dvntekim/fc-h743/docs/critical_nets.md

# Critical nets (from the routed board)

Generated by `scripts/check_critical.py`. Lengths are routed copper only (pads excluded).

| Net | Routed length (mm) | By layer | Vias | Widths (mm) |
|---|---|---|---|---|
| USB: `USB_DP` | 6.0 | F 3.0, In3 3.0 | 2 | 0.25 |
| USB: `USB_DM` | 8.3 | F 8.3 | 0 | 0.25 |
| USB: `USB_DP_C` | 7.8 | F 4.0, B 3.8 | 2 | 0.25 |
| USB: `USB_DM_C` | 5.7 | F 5.7 | 0 | 0.25 |
| Crystal: `HSE_IN` | 6.1 | F 6.1 | 0 | 0.15 |
| Crystal: `HSE_OUT` | 4.1 | F 4.1 | 0 | 0.15 |
| Buck: `BUCK_SW` | 0.0 |  | 0 |  |
| Buck: `BUCK_BOOT` | 2.3 | F 2.3 | 0 | 0.3 |
| Buck: `BUCK_FB` | 6.2 | F 6.2 | 0 | 0.127 |
| Buck: `BUCK_COMP` | 13.2 | F 13.2 | 0 | 0.127 |
| Buck: `VBAT` | 53.4 | F 29.0, B 9.6, In2 10.6, In3 4.2 | 6 | 0.421, 0.5, 0.6, 0.8, 1.0, 1.2 |
| Buck: `+5V` | 143.6 | F 24.9, B 65.0, In2 30.3, In3 23.4 | 10 | 0.4, 0.5, 0.6, 0.8, 1.0, 1.2 |
| IMU0 SPI1: `SPI1_SCK` | 15.5 | F 1.7, B 3.5, In2 10.3 | 3 | 0.127 |
| IMU0 SPI1: `SPI1_SCK_MCU` | 1.9 | F 1.9 | 0 | 0.127 |
| IMU0 SPI1: `SPI1_MISO` | 7.5 | F 6.8, B 0.8 | 1 | 0.127 |
| IMU0 SPI1: `SPI1_MOSI` | 7.9 | F 7.2, B 0.7 | 1 | 0.127, 0.15 |
| IMU0 SPI1: `IMU1_CS` | 14.2 | F 3.2, B 10.9 | 1 | 0.127 |
| IMU0 SPI1: `IMU1_DRDY` | 6.3 | F 3.4, B 0.6, In2 2.3 | 2 | 0.127 |
| IMU0 SPI1: `IMU_CLKIN` | 13.6 | F 2.0, B 1.0, In2 10.5 | 2 | 0.127 |
| IMU1 SPI2: `SPI2_SCK` | 16.2 | F 2.2, B 2.2, In2 11.8 | 2 | 0.127 |
| IMU1 SPI2: `SPI2_MISO` | 17.8 | F 8.9, B 3.5, In3 5.4 | 2 | 0.127 |
| IMU1 SPI2: `SPI2_MOSI` | 15.7 | F 14.4, B 1.3 | 1 | 0.127 |
| IMU1 SPI2: `BMI_ACC_CS` | 14.0 | F 9.0, B 1.7, In2 3.2 | 2 | 0.127 |
| IMU1 SPI2: `BMI_GYRO_CS` | 18.7 | F 2.4, B 1.9, In2 14.4 | 3 | 0.127 |
| SDMMC2: `SD_CLK` | 51.4 | F 2.4, B 5.9, In2 42.9, In3 0.2 | 2 | 0.127 |
| SDMMC2: `SD_CLK_MCU` | 2.5 | F 2.5 | 0 | 0.127 |
| SDMMC2: `SD_CMD` | 28.0 | F 3.6, B 9.9, In3 14.5 | 2 | 0.127 |
| SDMMC2: `SD_D0` | 29.3 | F 8.9, B 11.8, In2 8.7 | 3 | 0.127 |
| SDMMC2: `SD_D1` | 36.3 | F 11.6, B 14.5, In3 10.2 | 2 | 0.127 |
| SDMMC2: `SD_D2` | 26.1 | F 3.3, B 7.3, In2 15.6 | 2 | 0.127 |
| SDMMC2: `SD_D3` | 18.1 | F 1.6, B 8.1, In3 8.5 | 2 | 0.127 |
| CAN1: `CAN1_H` | 44.0 | F 12.1, B 3.9, In2 21.4, In3 6.6 | 3 | 0.127 |
| CAN1: `CAN1_L` | 27.3 | F 9.2, B 5.2, In3 12.9 | 3 | 0.127 |
| CAN2: `CAN2_H` | 14.0 | F 9.1, In3 4.9 | 2 | 0.127 |
| CAN2: `CAN2_L` | 8.0 | F 8.0 | 0 | 0.127 |

- `USB_DP`/`USB_DM` length difference: 2.26 mm
- `USB_DP_C`/`USB_DM_C` length difference: 2.06 mm
- `CAN1_H`/`CAN1_L` length difference: 16.72 mm
- `CAN2_H`/`CAN2_L` length difference: 5.97 mm
- Nearest IMU to L1 (buck inductor): 16.4 mm (spec: ≥ 10 mm)
- Nearest IMU to U1 (buck IC): 14.2 mm (spec: ≥ 10 mm)
- Crystal Y1 to MCU OSC_IN pin: 3.0 mm
- Tracks/vias inside the BMP581 body outline: {('B', 'other net'): 71, ('F', 'own net'): 241, ('via', 'own net'): 3, ('In3', 'own net'): 8, ('In3', 'other net'): 2, ('In2', 'own net'): 2, ('In2', 'other net'): 4}
- Sensor/clock nets crossing the inductor L1 outline on any layer: none
- Buck hot loop: C3 GND pad to D3 anode 10.0 mm, closed on In1 0.18 mm below F.Cu; 2 GND vias at the D3 anode
- Buck switch node: F.Cu pour, 26 mm2 (BUCK_SW has no tracks)
- Vias: 533 total; 20 at 0.35/0.15 mm, of which 17 are via-in-pad (need JLC epoxy fill + cap)
