dvntekim/fc-h743/docs/copper_layers.png

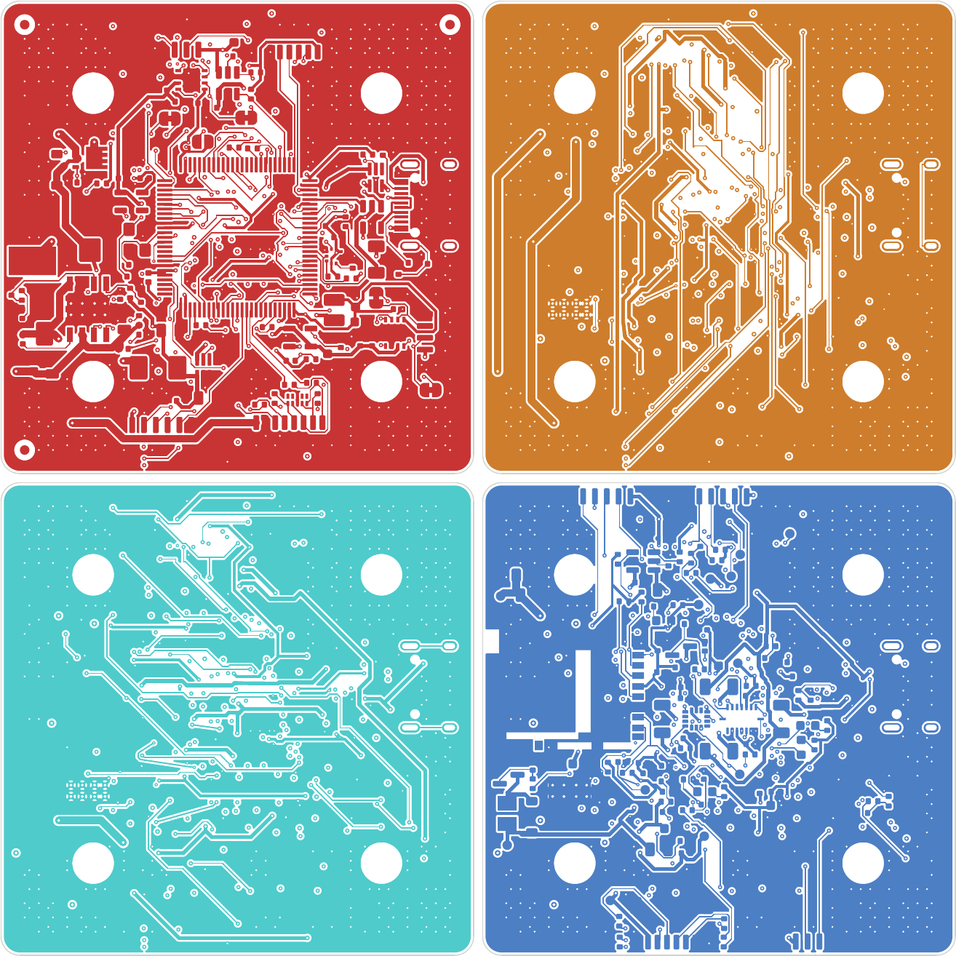
docs/copper_layers.png
