dvntekim/fc-h743/docs/render_iso.png

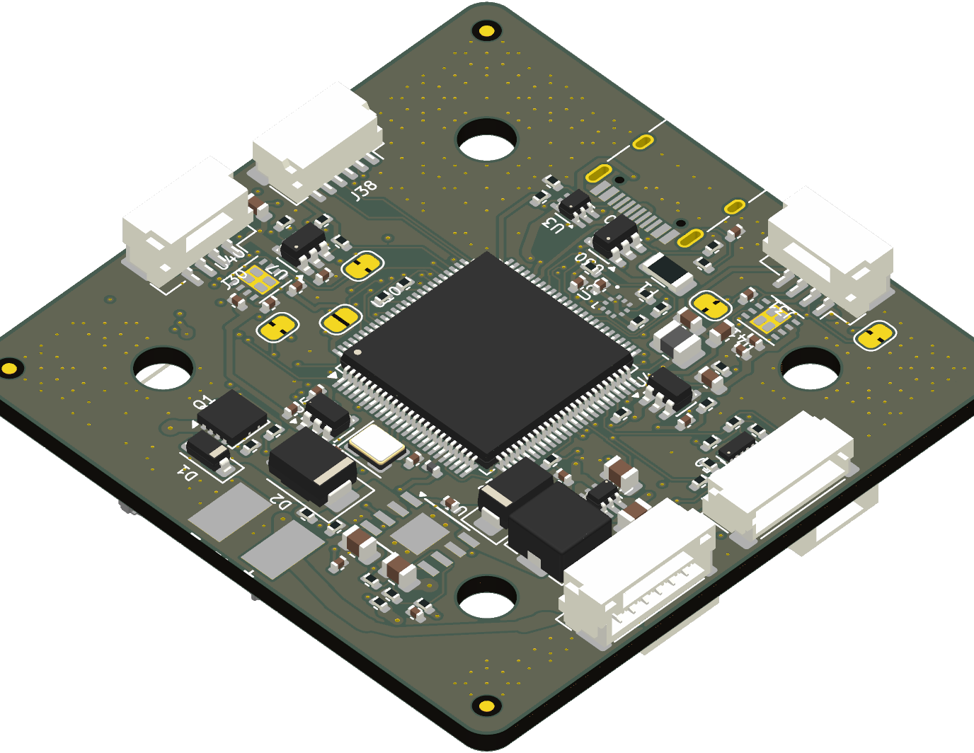
docs/render_iso.png
