dvntekim/fc-h743/sim/pi/P3V3_B.png

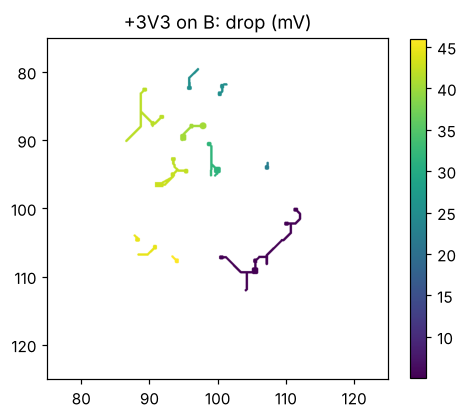
sim/pi/P3V3_B.png
