dvntekim/fc-h743/sim/pi/P3V3_F.png

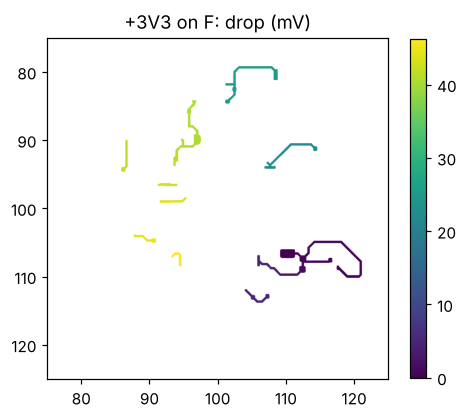
sim/pi/P3V3_F.png
