dvntekim/fc-h743/sim/pi/P3V3_In2.png

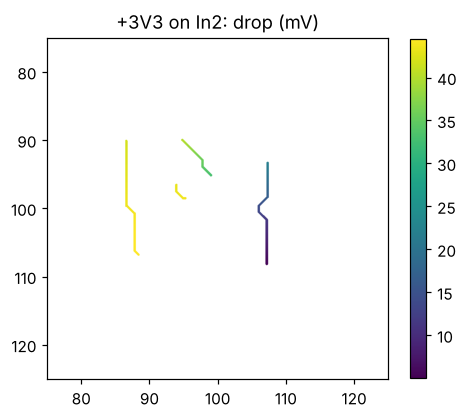
sim/pi/P3V3_In2.png
