dvntekim/fc-h743/sim/pi/P5V_B.png

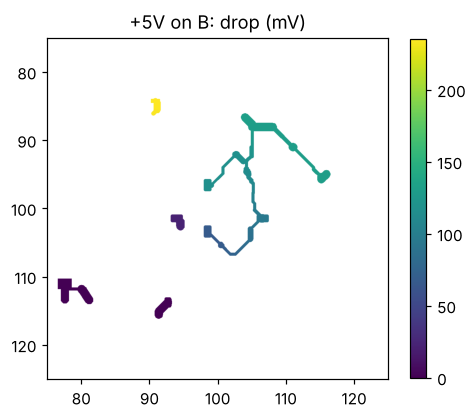
sim/pi/P5V_B.png
