dvntekim/fc-h743/sim/pi/P5V_F.png

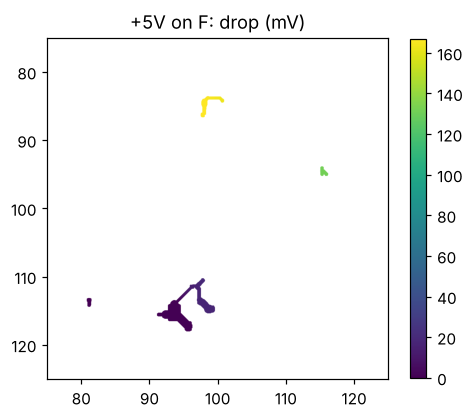
sim/pi/P5V_F.png
