dvntekim/fc-h743/sim/pi/P5V_In2.png

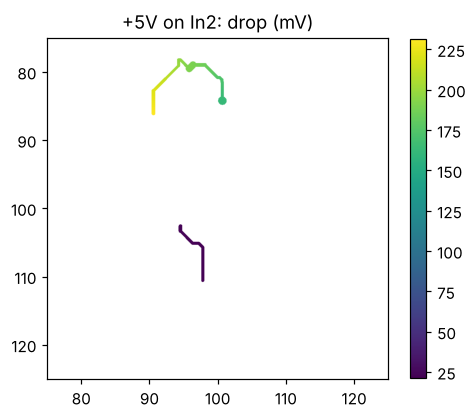
sim/pi/P5V_In2.png
