dvntekim/fc-h743/sim/pi/VBAT_B.png

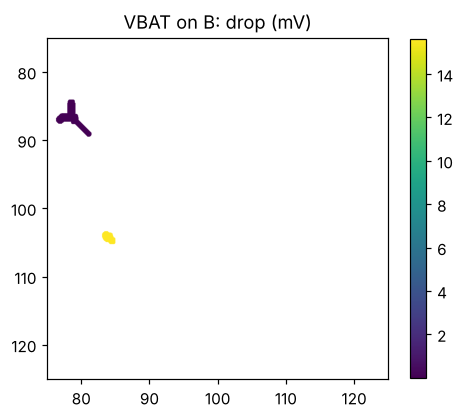
sim/pi/VBAT_B.png
