dvntekim/fc-h743/sim/pi/VBAT_F.png

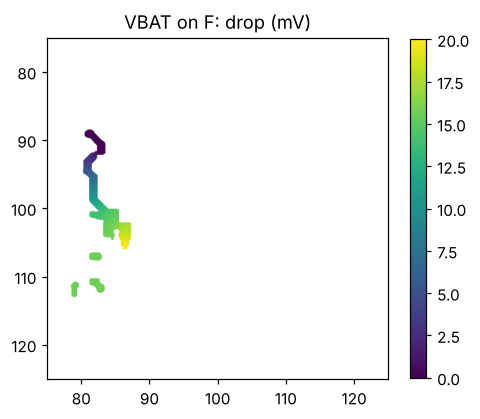
sim/pi/VBAT_F.png
