dvntekim/fc-h743/sim/pi/VBAT_In2.png

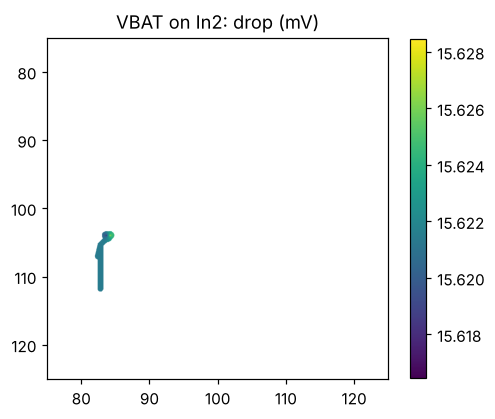
sim/pi/VBAT_In2.png
