dvntekim/fc-h743/sim/pi/VBAT_RAW_F.png

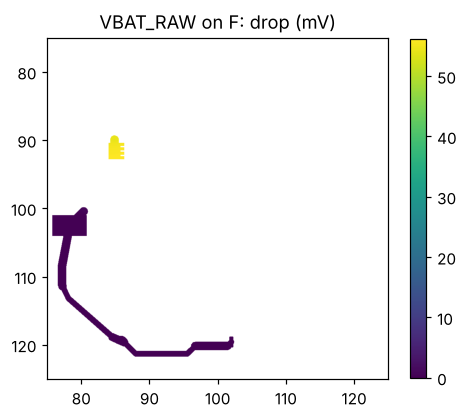
sim/pi/VBAT_RAW_F.png
