dvntekim/fc-h743/sim/pi/VBAT_RAW_In2.png

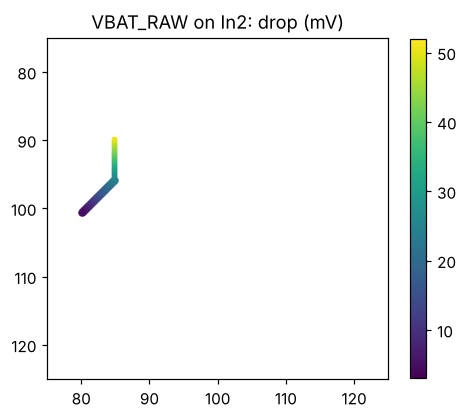
sim/pi/VBAT_RAW_In2.png
