dvntekim/fc-h743/sim/thermal/map_4S_1.2A+heater_h12.png

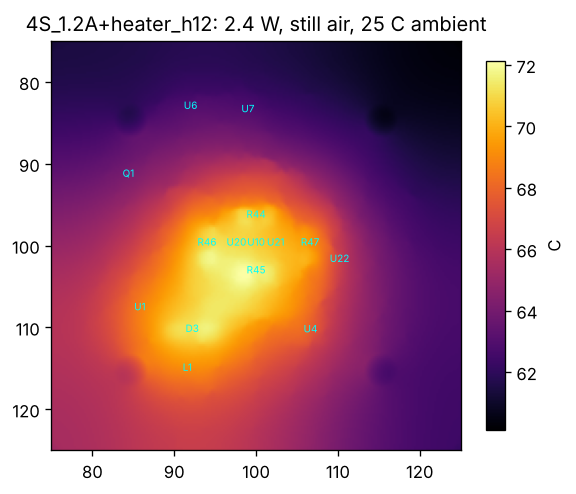
sim/thermal/map_4S_1.2A+heater_h12.png
