dvntekim/fc-h743/sim/thermal/map_6S_2.5A_h12.png

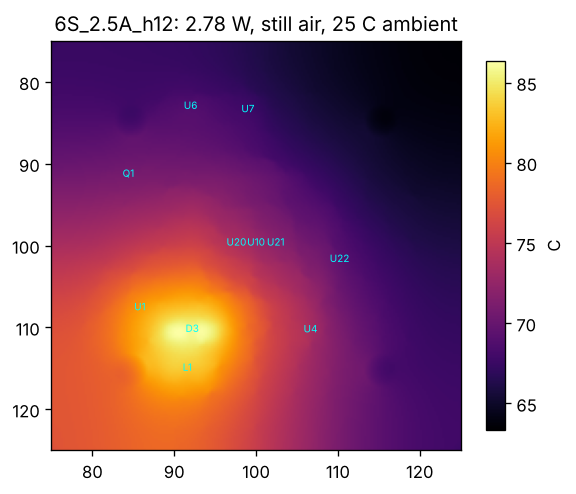
sim/thermal/map_6S_2.5A_h12.png
