dvntekim/fc-h743/sim/thermal/revB/island_inplace_slot_11x9_0.86W_cold.png

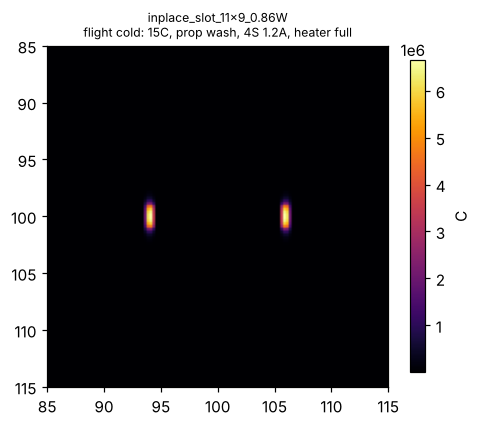
sim/thermal/revB/island_inplace_slot_11x9_0.86W_cold.png
