dvntekim/fc-h743/fab/bom_jlc.csv

Comment | Designator | Footprint | LCSC Part #
10uF | C1,C2,C6,C7 | C_0805_2012Metric | C440198
100nF | C3 | C_0603_1608Metric | C14663
100nF | C4,C5,C9,C13,C17,C18,C25,C27,C29,C30,C31,C32,C33,C34,C39,C40,C41,C44,C45,C47,C48,C49,C50,C53,C54,C56,C58,C60 | C_0402_1005Metric | C1525
22uF | C10,C11,C12,C26 | C_0805_2012Metric | C45783
4.7nF | C14,C51,C57,C61 | C_0402_1005Metric | C1538
47pF | C15 | C_0402_1005Metric | C1567
10uF | C16,C19,C21,C22,C28,C52 | C_0603_1608Metric | C19702
10pF | C20 | C_0402_1005Metric | C32949
1uF | C23,C24,C38,C46,C55,C59 | C_0402_1005Metric | C52923
4.7uF | C35 | C_0603_1608Metric | C19666
2.2uF | C36,C37 | C_0402_1005Metric | C12530
12pF | C42,C43 | C_0402_1005Metric | C1547
BZT52C12 | D1 | D_SOD-123 | C43491
SMBJ28A | D2 | D_SMB | C113997
B360A-13-F | D3 | D_SMA | C94193
GREEN PWR | D4 | LED_0603_1608Metric | C2986059
RED | D10 | LED_0603_1608Metric | C2286
BLUE | D11 | LED_0603_1608Metric | C965807
GREEN | D12 | LED_0603_1608Metric | C2986059
B5819W | D20 | D_SOD-123 | C8598
0.5A | F1 | Fuse_1206_3216Metric | C69688
220R@100MHz | FB1 | L_0402_1005Metric | C76885
USB-C | J20 | USB_C_Receptacle_HRO_TYPE-C-31-M-12 | C165948
microSD | J21 | microSD_HC_Hirose_DM3AT-SF-PEJM5 | C114218
CAN1 | J30 | JST_GH_SM04B-GHS-TB_1x04-1MP_P1.25mm_Horizontal | C189895
CAN2 | J31 | JST_GH_SM04B-GHS-TB_1x04-1MP_P1.25mm_Horizontal | C189895
TELEM1 | J32 | JST_GH_SM06B-GHS-TB_1x06-1MP_P1.25mm_Horizontal | C133065
TELEM2 | J33 | JST_GH_SM06B-GHS-TB_1x06-1MP_P1.25mm_Horizontal | C133065
GPS/I2C | J34 | JST_GH_SM06B-GHS-TB_1x06-1MP_P1.25mm_Horizontal | C133065
RC | J35 | JST_GH_SM04B-GHS-TB_1x04-1MP_P1.25mm_Horizontal | C189895
ESC | J36 | JST_SH_SM08B-SRSS-TB_1x08-1MP_P1.00mm_Horizontal | C160407
AUX | J37 | JST_SH_SM06B-SRSS-TB_1x06-1MP_P1.00mm_Horizontal | C56123098
DEBUG | J38 | JST_SH_SM06B-SRSS-TB_1x06-1MP_P1.00mm_Horizontal | C56123098
4.7uH | L1 | L_Changjiang_FXL0530 | C177246
2.2uH | L2 | L_1008_2520Metric | C98350
DMP4013LFGQ-13 | Q1 | Diodes_PowerDI3333-8 | C7264680
AO3400A | Q2 | SOT-23 | C20917
2N7002 | Q3 | SOT-23 | C8545
100k | R1,R2,R11,R18,R19,R21,R24,R43,R74 | R_0402_1005Metric | C25741
10k | R3,R9,R12,R13,R14,R15,R16,R22,R25,R27,R35,R36,R37,R38,R39 | R_0402_1005Metric | C25744
1k | R4,R32,R68 | R_0402_1005Metric | C11702
147k | R5 | R_0402_1005Metric | C64171
36k | R6 | R_0402_1005Metric | C43676
162k | R7 | R_0402_1005Metric | C54068
53.6k | R8 | R_0402_1005Metric | C53398
9.09k | R10 | R_0402_1005Metric | C11549
453k | R17 | R_0402_1005Metric | C27009
20k | R20 | R_0402_1005Metric | C25765
22k | R23,R51 | R_0402_1005Metric | C25768
2k | R26 | R_0402_1005Metric | C4109
33 | R28,R29,R31 | R_0402_1005Metric | C25105
22 | R30 | R_0402_1005Metric | C25092
470 | R33,R34 | R_0402_1005Metric | C25117
2.2k | R40,R41,R62,R63 | R_0402_1005Metric | C25879
47 | R42,R64,R65,R66,R67,R69,R70,R71,R72 | R_0402_1005Metric | C25118
120 | R44,R45,R46,R47 | R_1206_3216Metric | C17909
5.1k | R48,R49 | R_0402_1005Metric | C25905
1M | R50 | R_0402_1005Metric | C26083
33k | R52 | R_0402_1005Metric | C25779
47k | R53,R54,R55,R56,R57 | R_0402_1005Metric | C25792
60.4 | R58,R59,R60,R61 | R_0402_1005Metric | C60310
100 | R73 | R_0402_1005Metric | C25076
TPS54360BDDAR | U1 | TI_SO-PowerPAD-8_ThermalVias | C524806
LM66100DCKR | U2,U3 | SOT-363_SC-70-6 | C2869734
TLV62569DBVR | U4 | SOT-23-5 | C141836
LP5907MFX-3.3/NOPB | U5 | SOT-23-5 | C80670
TPS2553DBVR | U6,U7 | SOT-23-6 | C55266
STM32H743VIT6 | U10 | LQFP-100_14x14mm_P0.5mm | C114409
ICM-45686 | U20 | LGA-14_3x2.5mm_P0.5mm_LayoutBorder3x4y | C22459454
BMI088 | U21 | Bosch_LGA-16_4.5x3mm_P0.5mm_LayoutBorder7x1y_ClockwisePinNumbering | C194919
BMP581 | U22 | Bosch_LGA-10_2x2mm_P0.5mm_BMP581 | C5362283
USBLC6-2SC6 | U30 | SOT-23-6 | C7519
TCAN1462VDRBRQ1 | U40,U41 | TI_DRB0008J_VSON-8_3x3mm_P0.65mm | C5215833
TPD4E05U06DQAR | U50 | USON-10_2.5x1.0mm_P0.5mm | C138714
16MHz | Y1 | Crystal_SMD_3225-4Pin_3.2x2.5mm | C13738
