dvntekim/fc-h743/fab/fc-h743.step

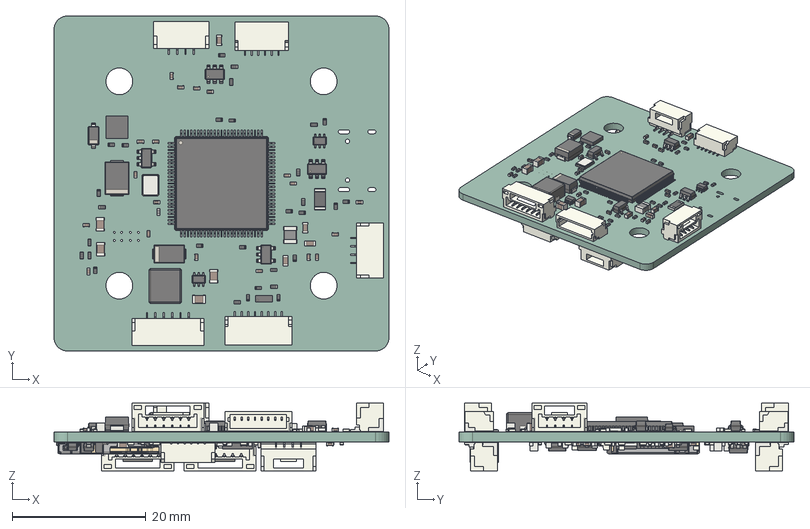
[picture p22: CAD file, 2026-11-07]
fab/fc-h743.step
50.0 x 50.0 x 10.1 mm
R_0402_1005Metric x 70
C_0603_1608Metric x 8
D_SOD-123 x 2
C_0402_1005Metric x 44
Crystal_SMD_3225-4Pin_3.2x2.5mm
C_0805_2012Metric x 8
SOT-363_SC-70-6 x 2
JST_GH_SM04B-GHS-TB_1x04-1MP_P1.25mm_Horizontal x 3
JST_SH_SM06B-SRSS-TB_1x06-1MP_P1.00mm_Horizontal x 2
Diodes_PowerDI3333-8
SOT-23-6 x 3
JST_GH_SM06B-GHS-TB_1x06-1MP_P1.25mm_Horizontal x 3
D_SMB
L_Changjiang_FXL0530
JST_SH_SM08B-SRSS-TB_1x08-1MP_P1.00mm_Horizontal
D_SMA
Fuse_1206_3216Metric
SOT-23-5 x 2
USON-10_2.5x1.0mm_P0.5mm
L_1008_2520Metric
L_0402_1005Metric
LQFP-100_14x14mm_P0.5mm
LED_0603_1608Metric x 4
LGA-14_3x2.5mm_P0.5mm_LayoutBorder3x4y
R_1206_3216Metric x 4
microSD_HC_Hirose_DM3AT-SF-PEJM5
SOT-23 x 2
Bosch_LGA-16_4.5x3mm_P0.5mm_LayoutBorder7x1y_ClockwisePinNumbering
fc_PCB
