dvntekim/fc-h743/docs/schematic.pdf

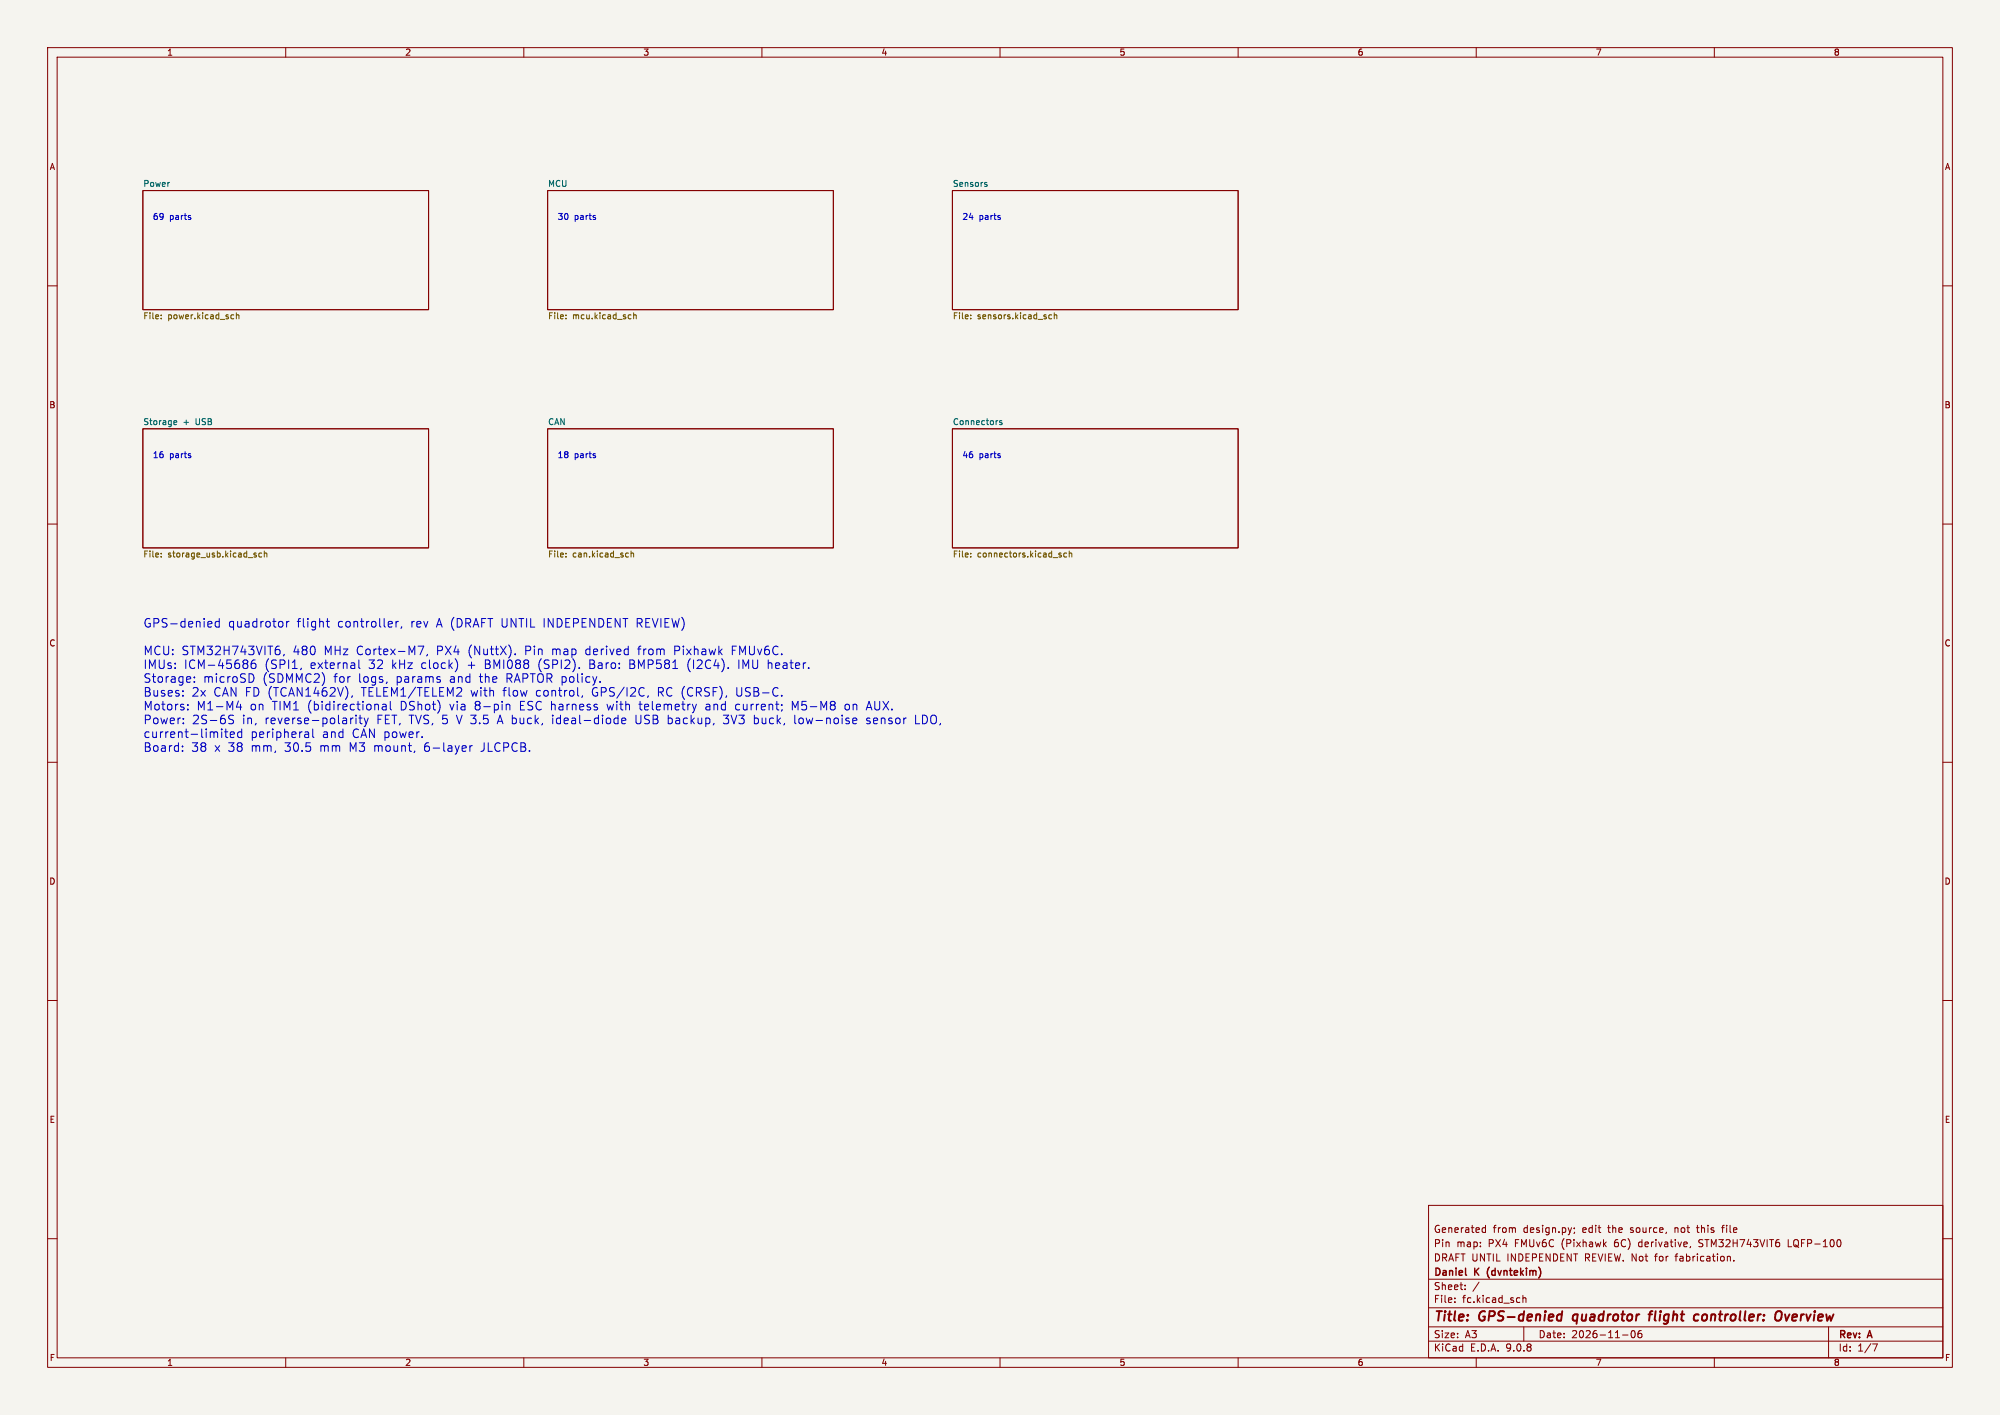
[picture p23: page 1]

Storage: microSD (SDMMC2) for logs, params and the RAPTOR policy.

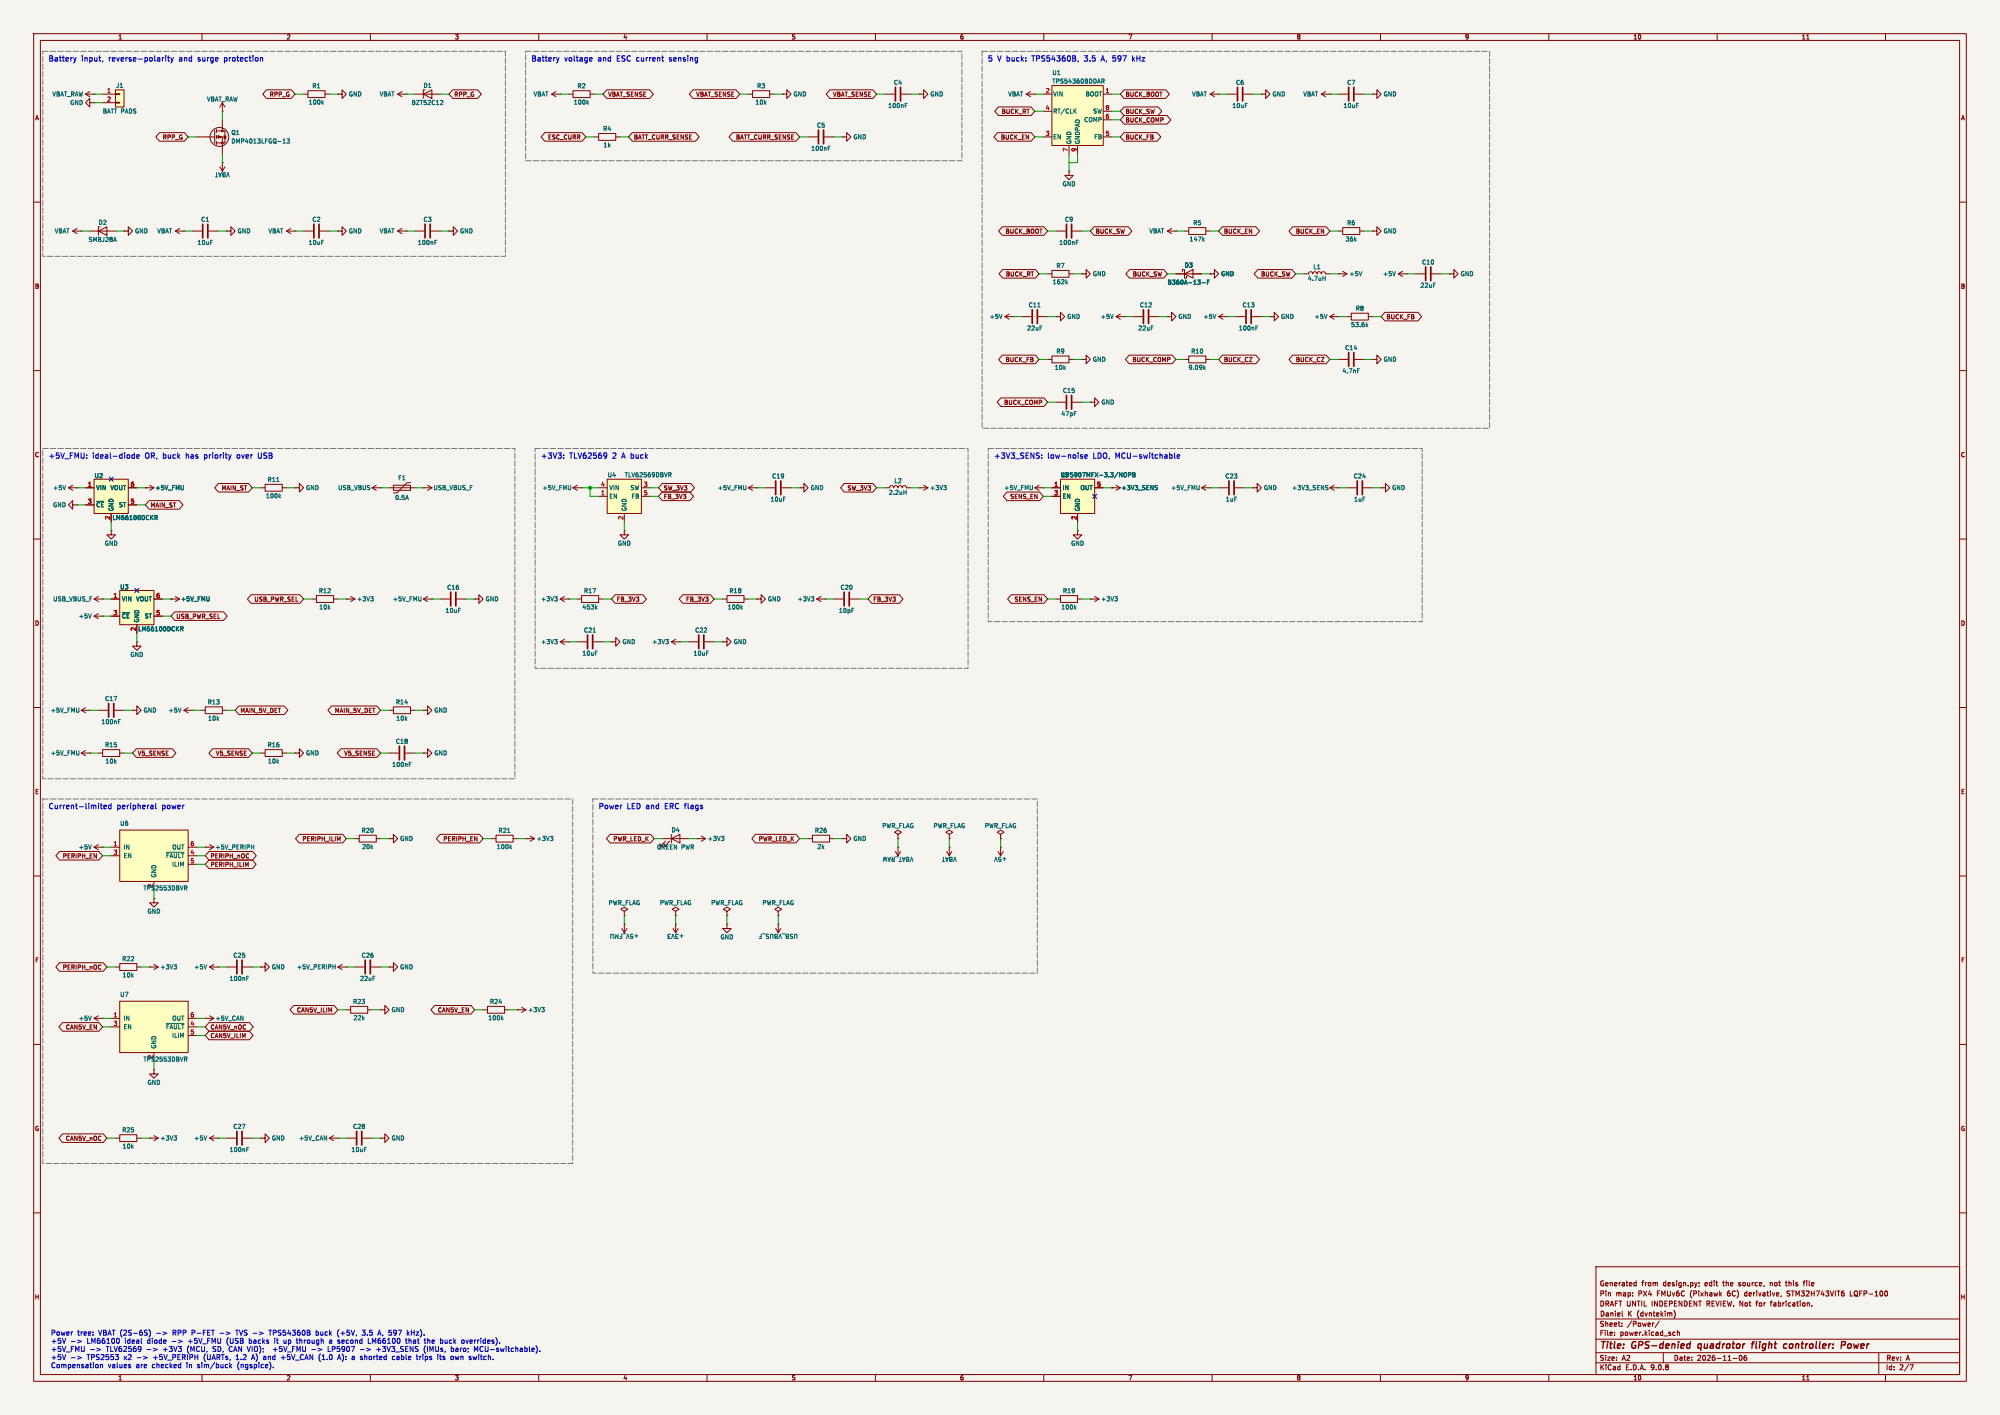
[picture p24: page 2]

Battery voltage and ESC current sensing

9 BOOT 1 SW 8 COMP 6 FB 5 U1 TPS54360BDDAR

2 SW 3 FB 5 U4 TLV62569DBVR GND GND

2 OUT 5 U5LP5907MFX-3.3/NOPB GND +5V_FMU +3V3_SENS GND +3V3_SENS C24

Power LED and ERC flags

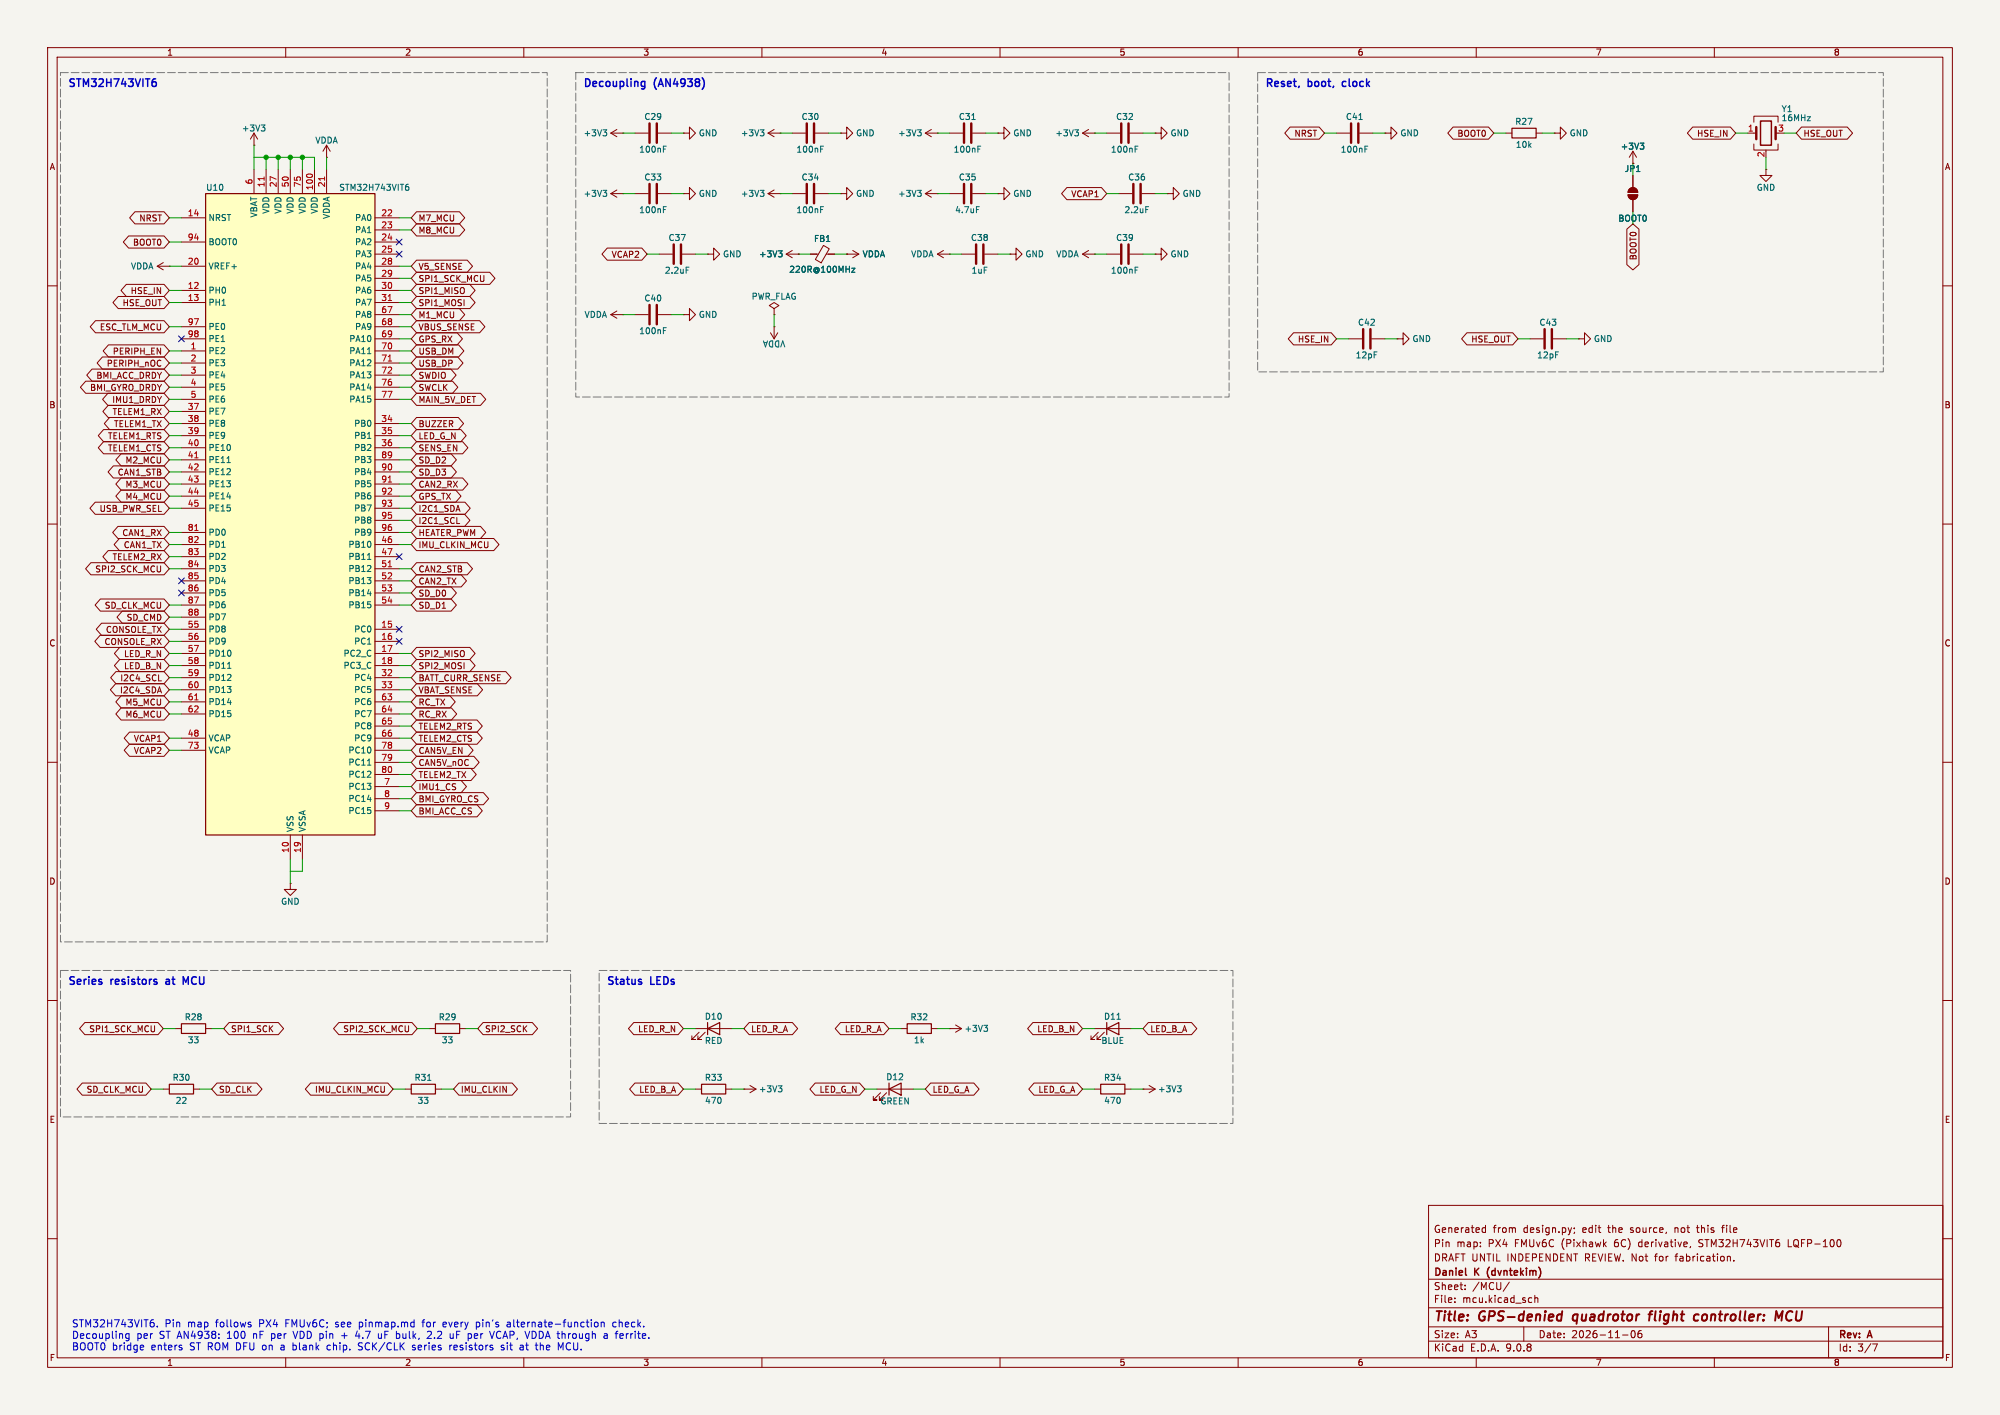
[picture p25: page 3]

6 VDD 11 VDD 27 VDD 50 VSS 10 VDD 75 VSSA 19 VDD 100 VDDA 21 PA0 22 PA1 23 PA2 24 PA3 25 PA4 28 PA5 29 PA6 30 PA7 31 PA8 67 PA9 68 PA10 69 PA11 70 PA12 71 PA13 72 PA14 76 PA15 77 PB0 34 PB1 35 PB2 36 PB3 89 PB4 90 PB5 91 PB6 92 PB7 93 PB8 95 PB9 96 PB10 46 PB11 47 PB12 51 PB13 52 PB14 53 PB15 54 PC0 15 PC1 16 PC2_C 17 PC3_C 18 PC4 32 PC5 33 PC6 63 PC7 64 PC8 65 PC9 66 PC10 78 PC11 79 PC12 80 PC13 7 PC14 8 PC15 9

Series resistors at MCU

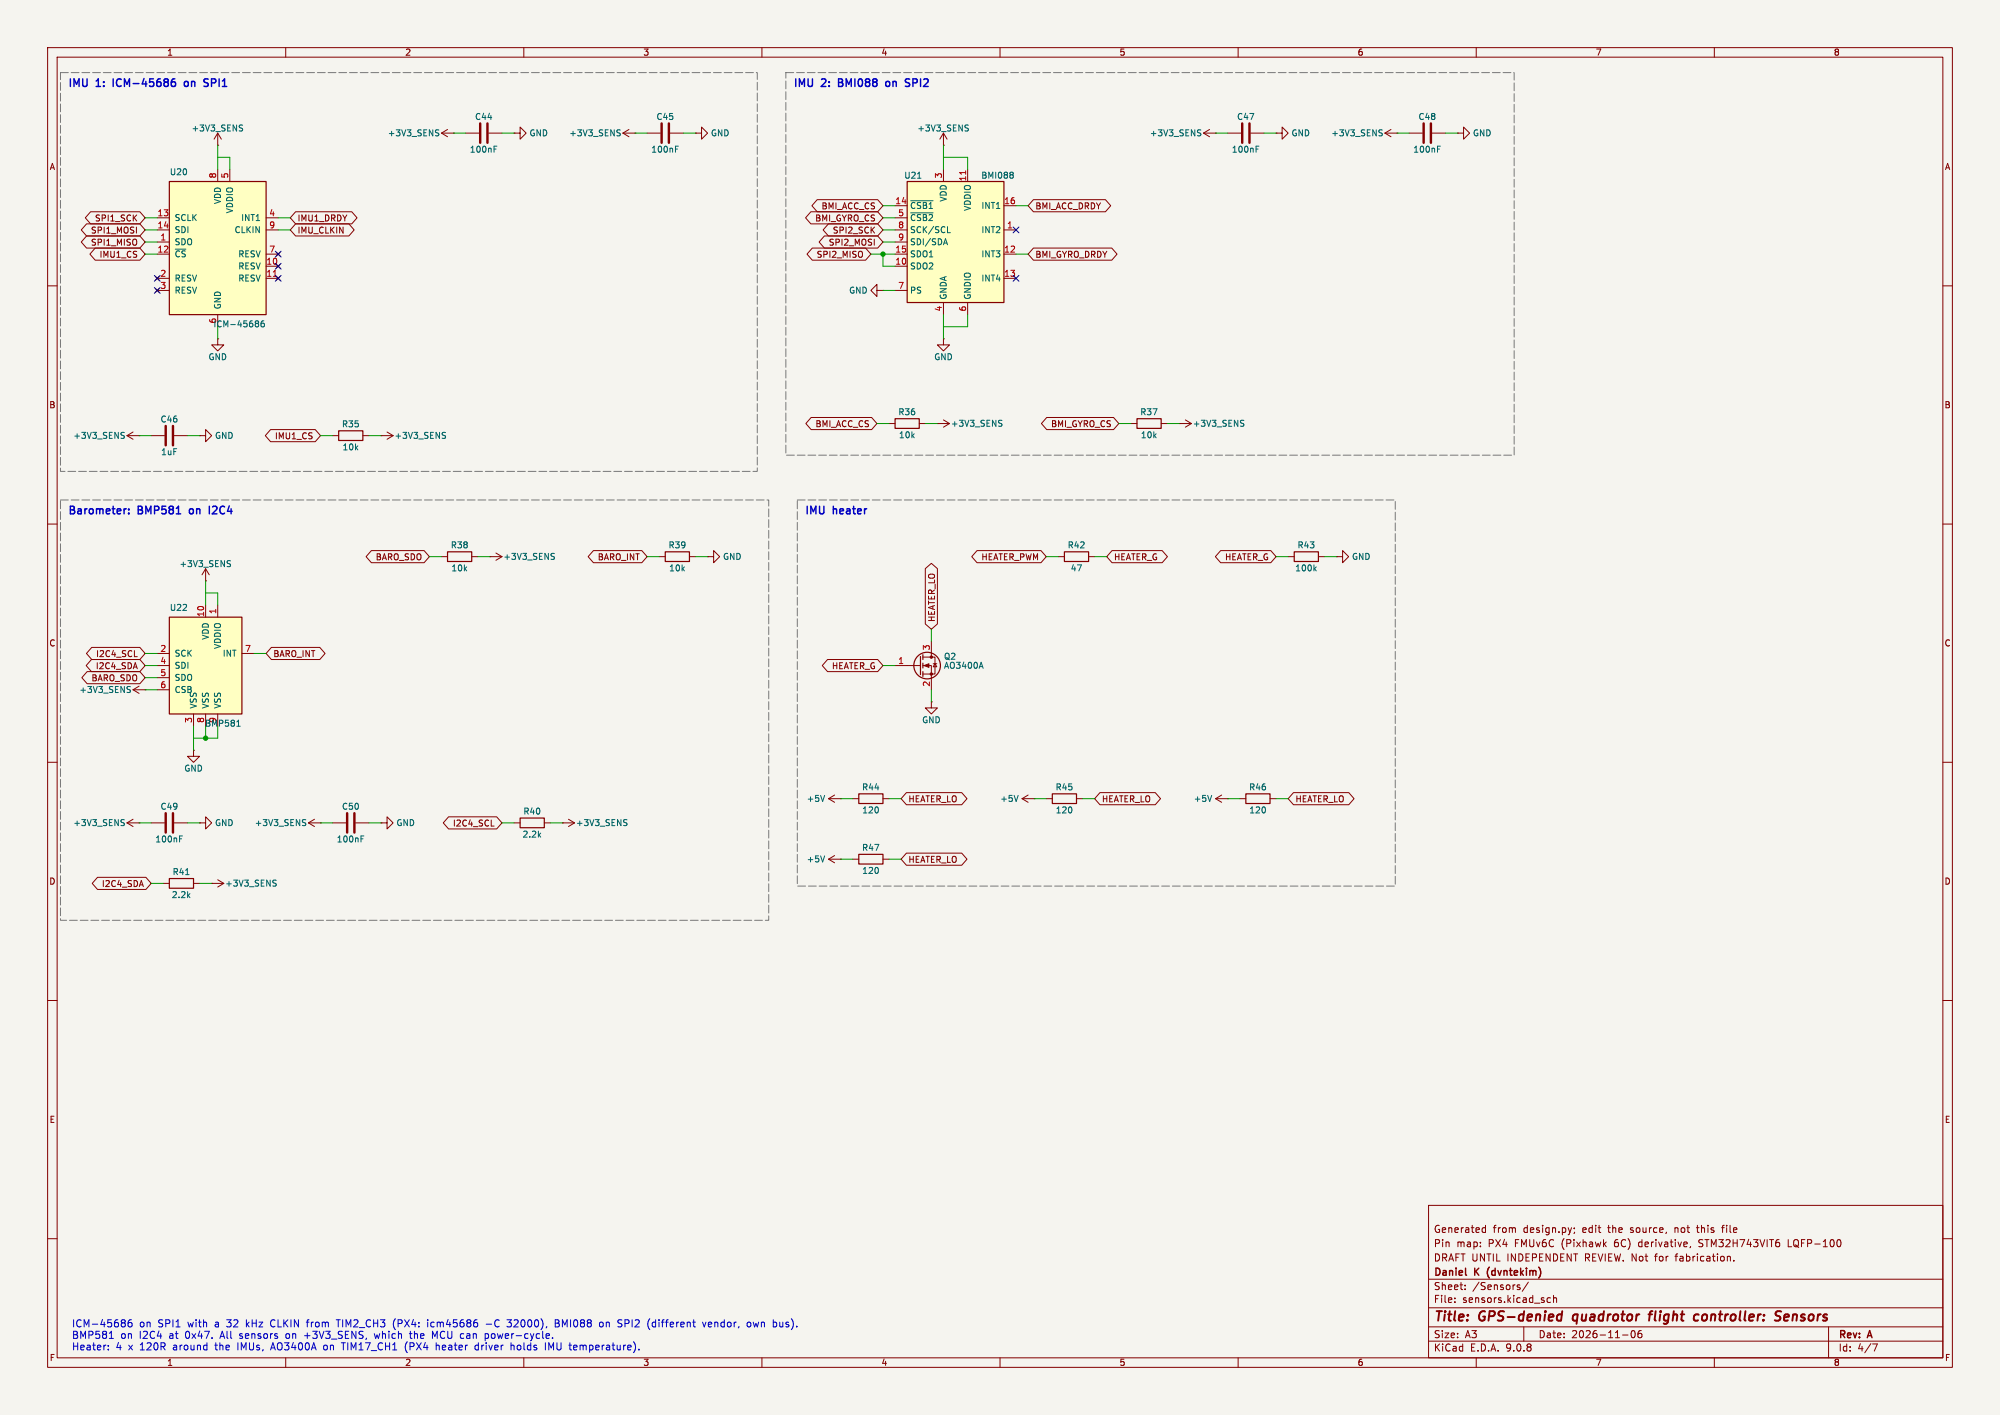
[picture p26: page 4]

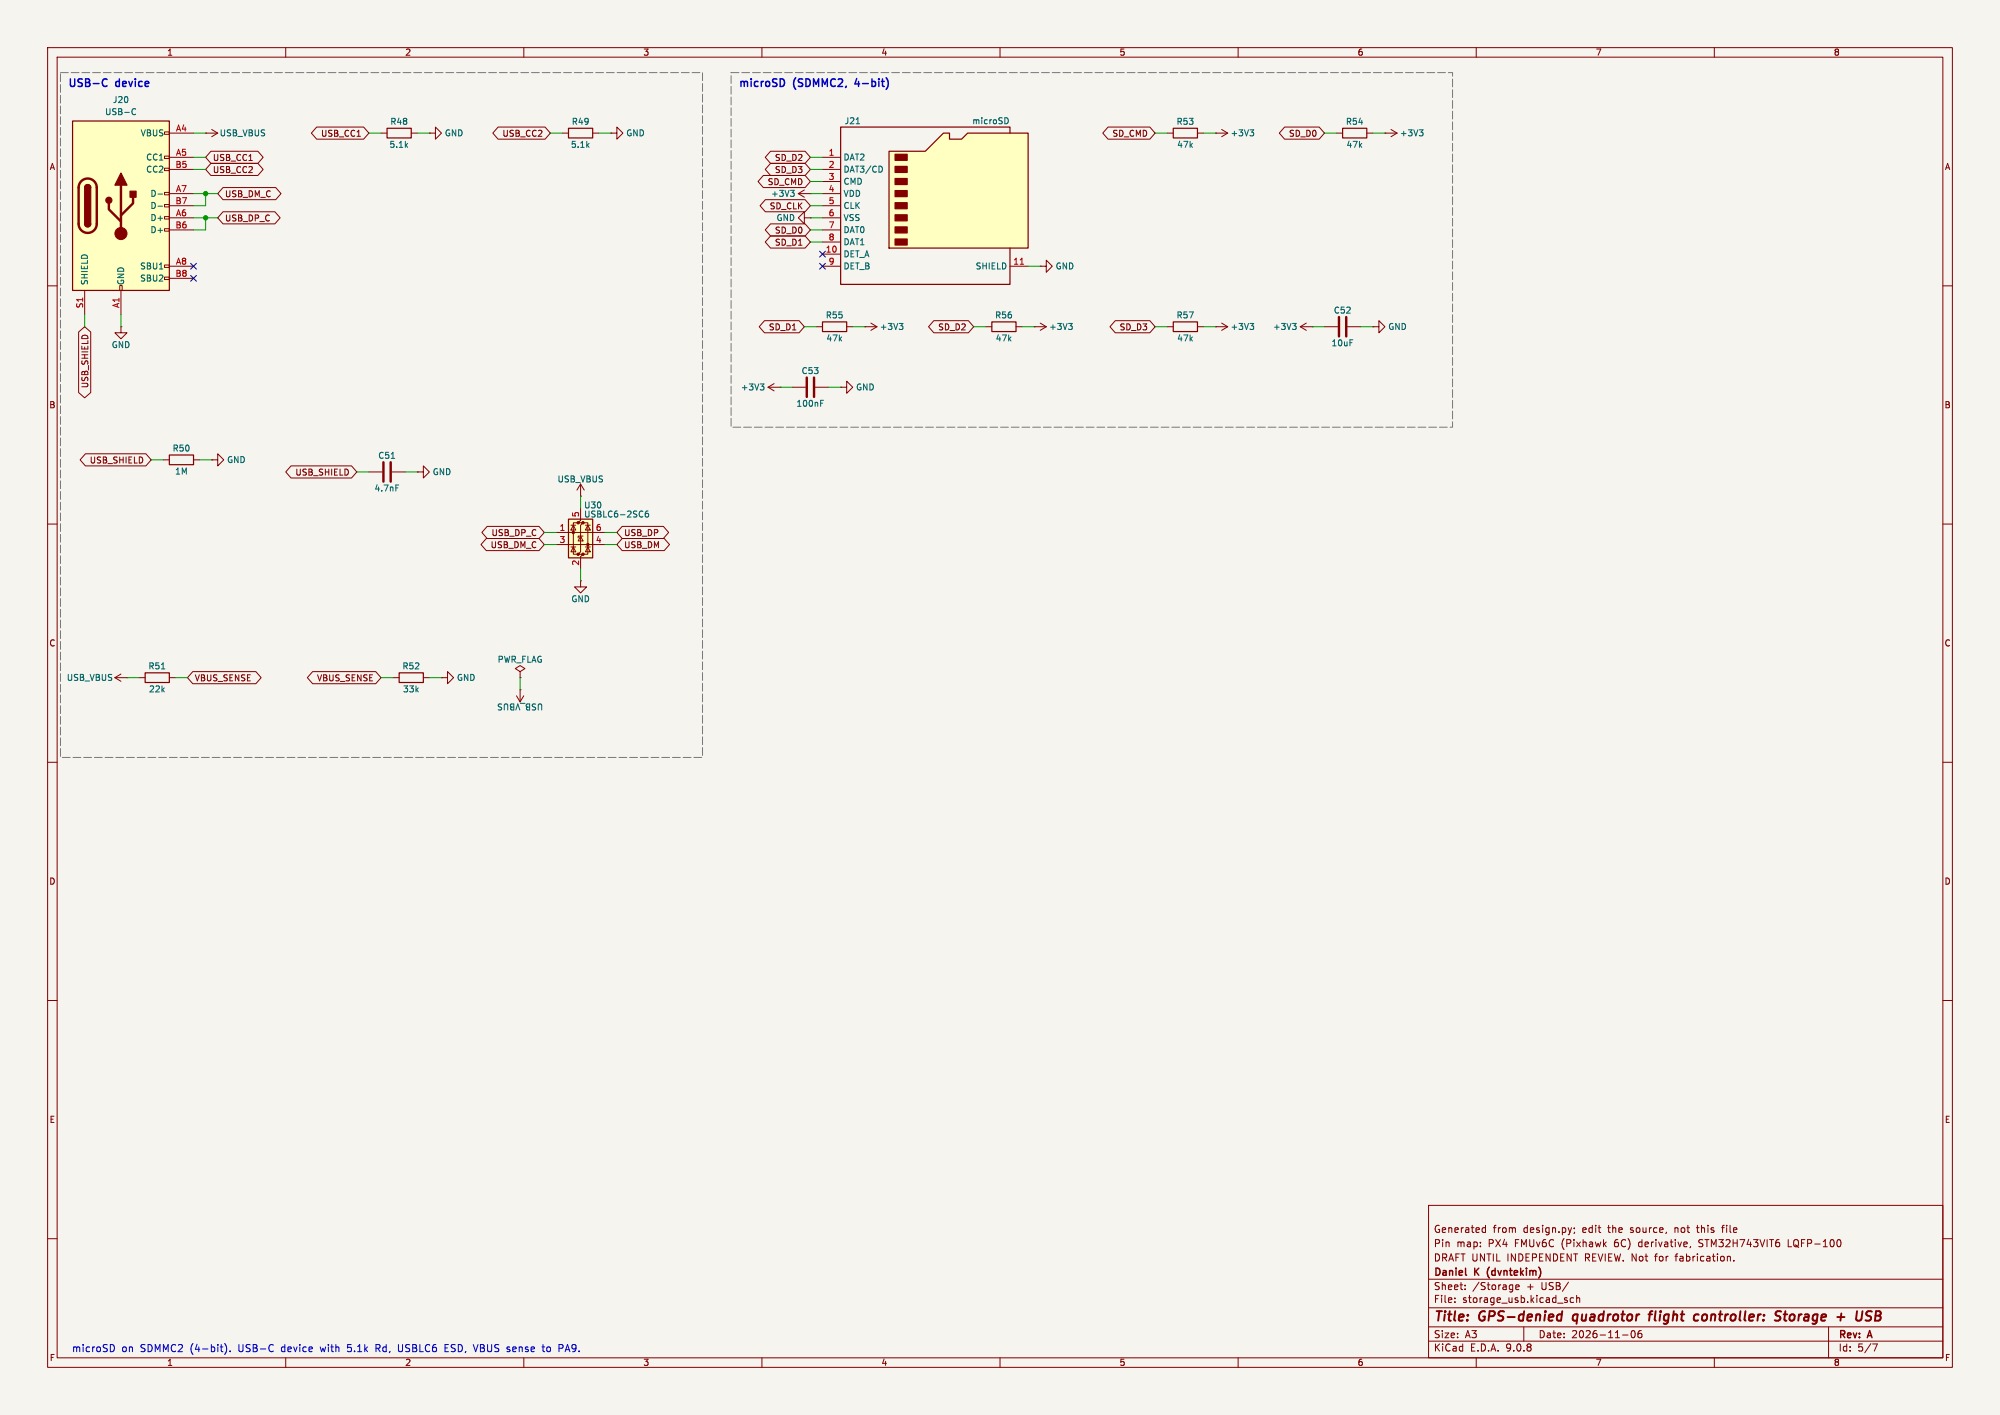
[picture p27: page 5]

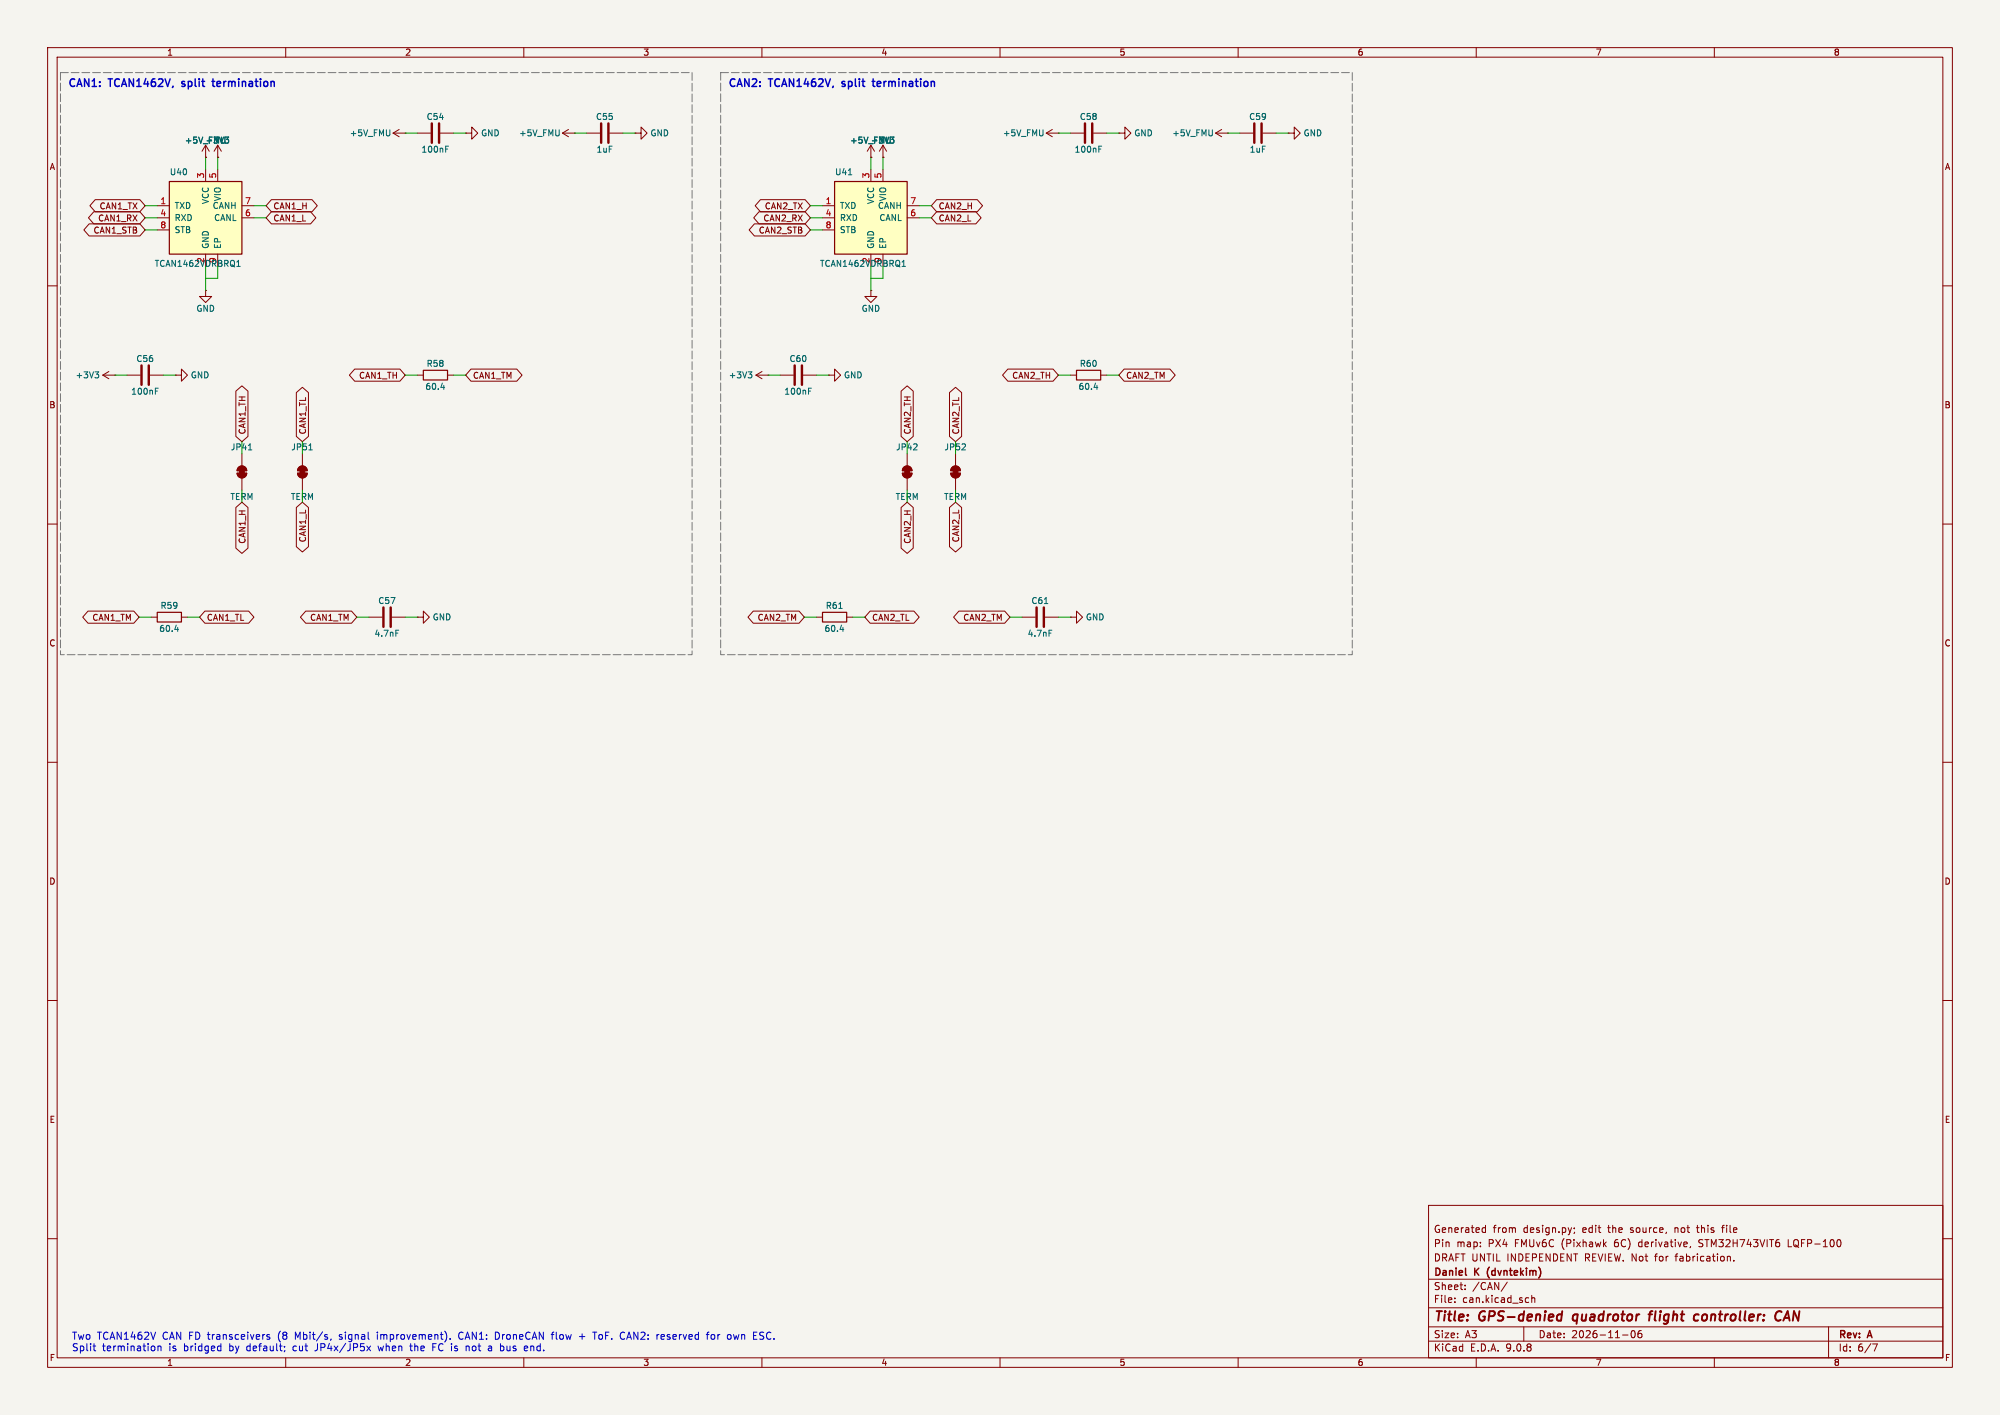
[picture p28: page 6]

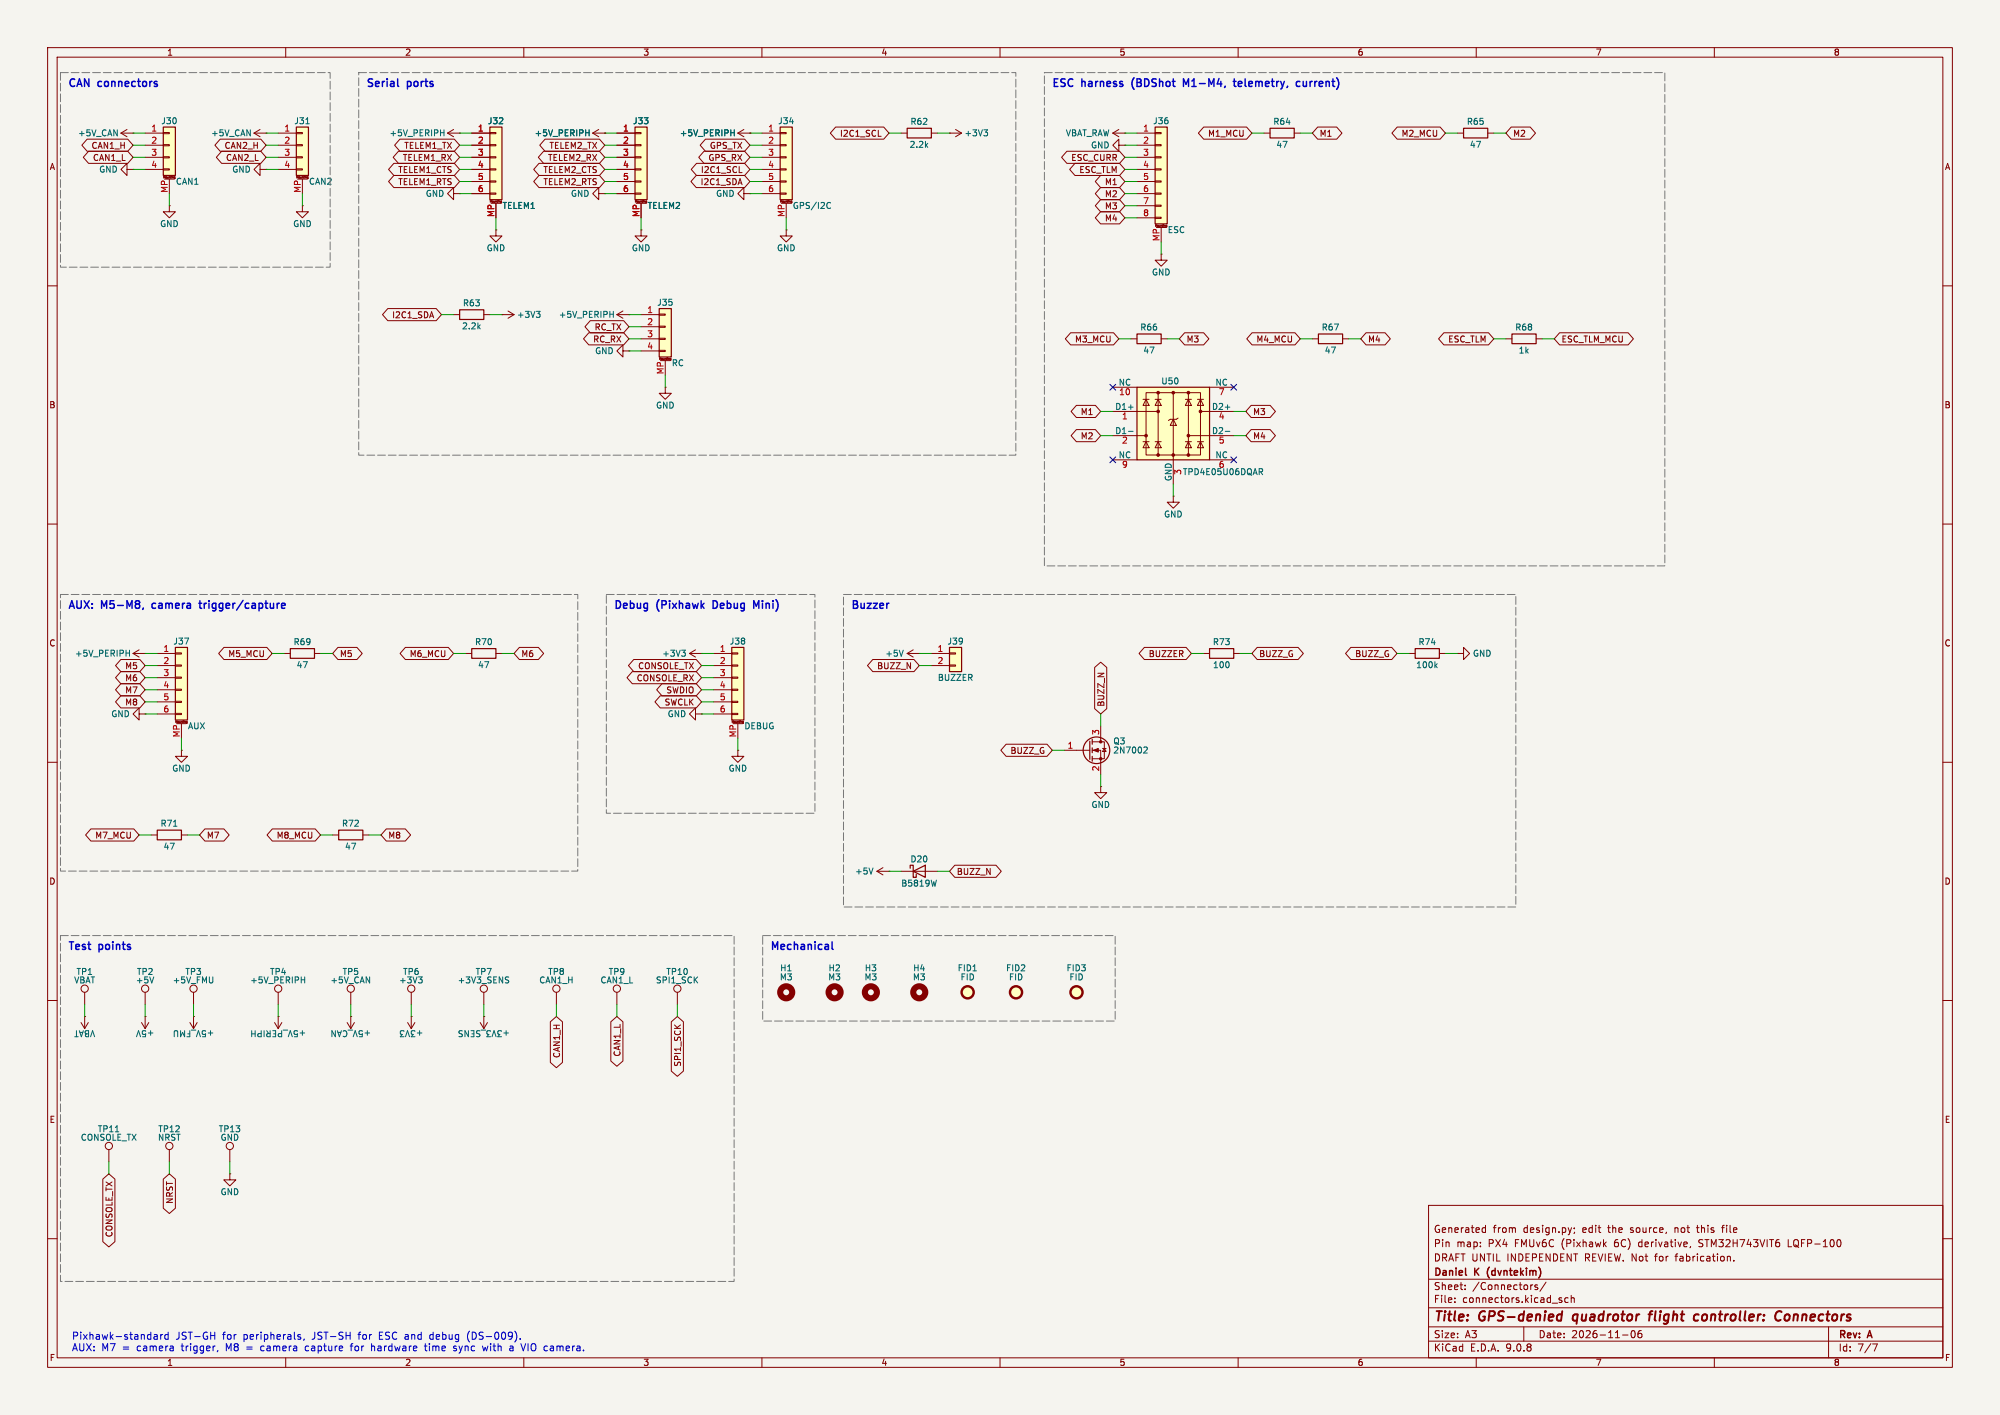
[picture p29: page 7]
