dvntekim/fc-h743/kicad/fc.kicad_pcb

## KiCad design kicad/fc.kicad_pcb (2026-11-07)

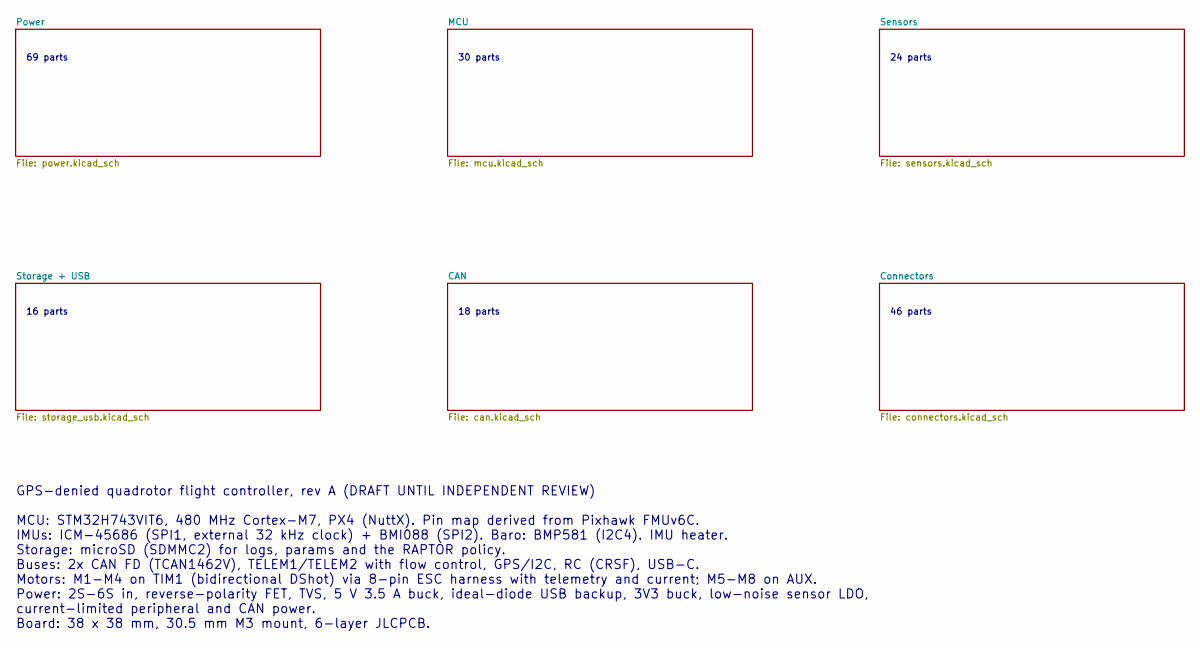
[picture p30: schematic fc.kicad_sch, GPS-denied quadrotor flight controller: Overview]

Notes on the sheet:
69 parts
30 parts
24 parts
16 parts
18 parts
46 parts
GPS-denied quadrotor flight controller, rev A (DRAFT UNTIL INDEPENDENT REVIEW) MCU: STM32H743VIT6, 480 MHz Cortex-M7, PX4 (NuttX). Pin map derived from Pixhawk FMUv6C. IMUs: ICM-45686 (SPI1, external 32 kHz clock) + BMI088 (SPI2). Baro: BMP581 (I2C4). IMU heater. Storage: microSD (SDMMC2) for logs,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

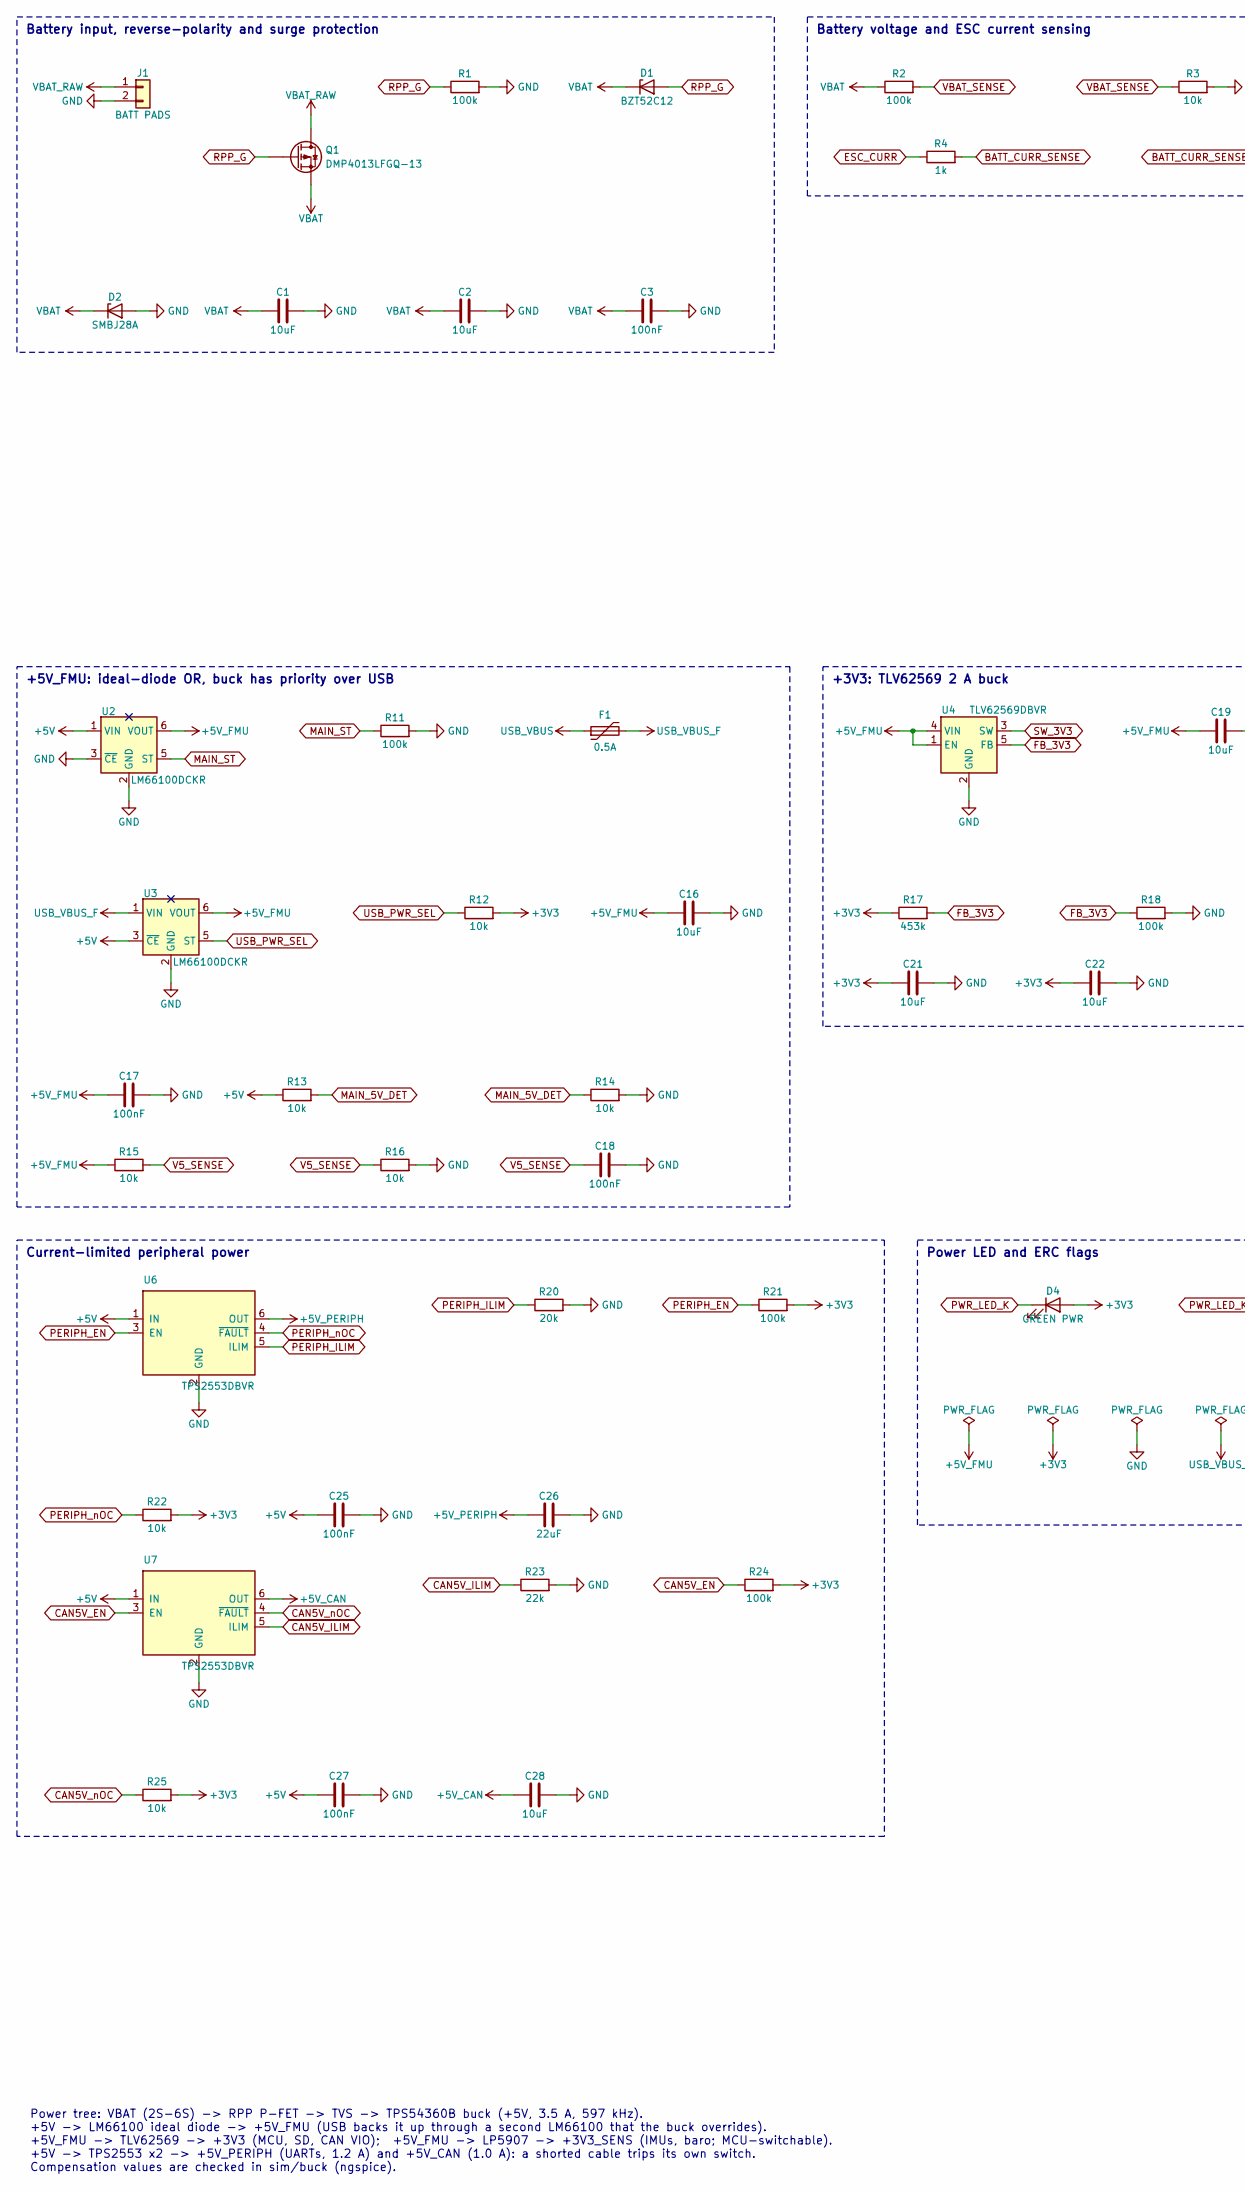
[picture p31: schematic power.kicad_sch, GPS-denied quadrotor flight controller: Power, part in row 1, column 1]

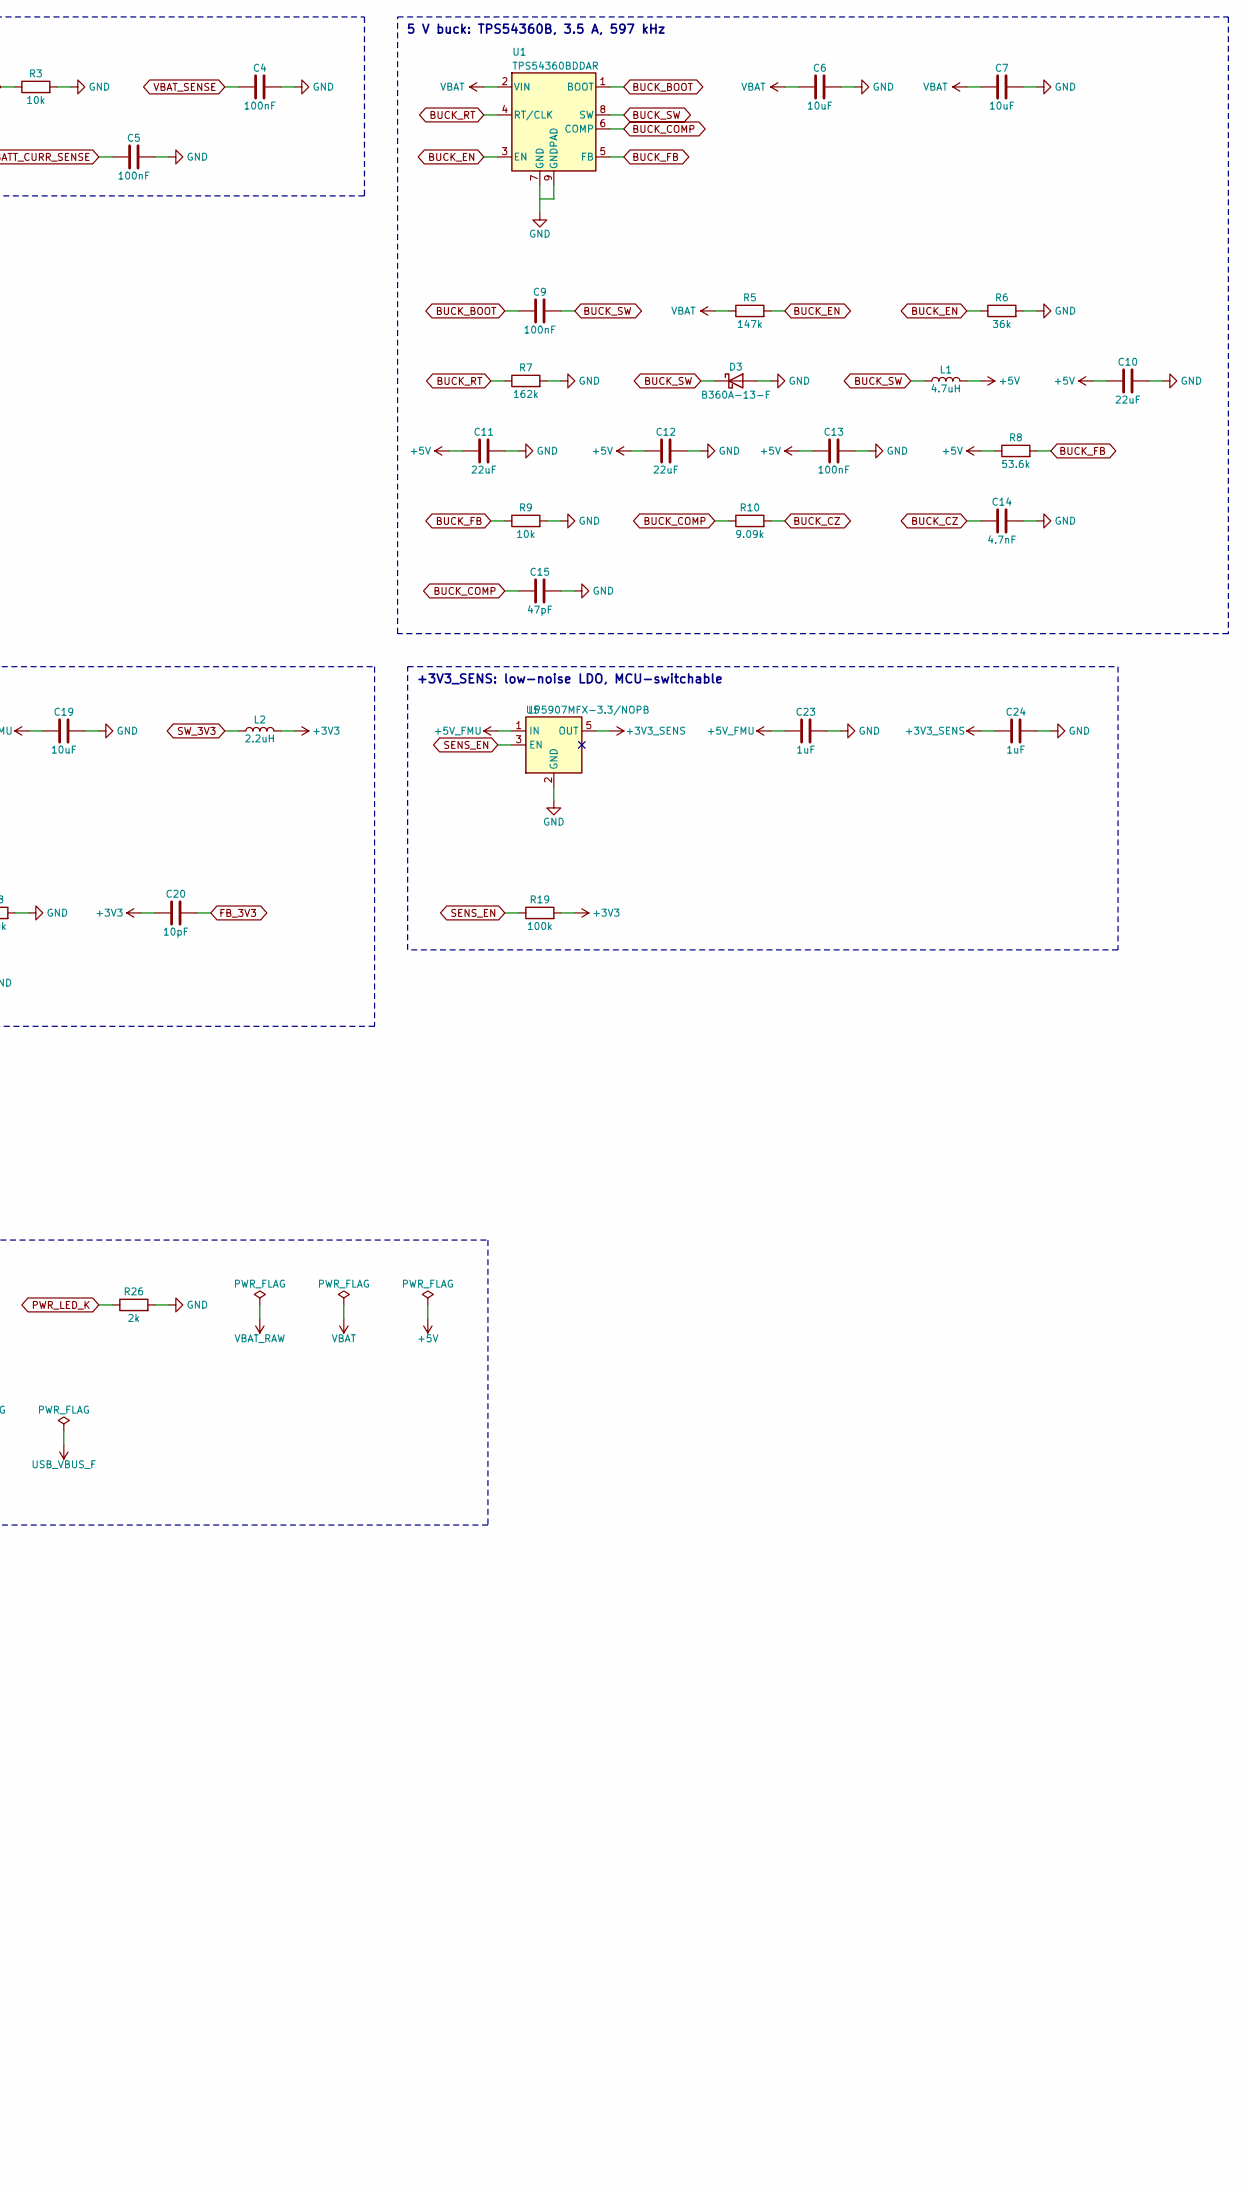
[picture p32: schematic power.kicad_sch, GPS-denied quadrotor flight controller: Power, part in row 1, column 2]

Parts:
C1, C2, C6, C7: 10uF; C_0805_2012Metric; Rating 50V X5R; LCSC C440198
C3: 100nF; C_0603_1608Metric; Rating 50V X7R; LCSC C14663
C4, C5, C9, C13, C17, C18, C25, C27: 100nF; C_0402_1005Metric; Rating 16V X7R; LCSC C1525
C10, C11, C12, C26: 22uF; C_0805_2012Metric; Rating 25V X5R; LCSC C45783
C14: 4.7nF; C_0402_1005Metric; Rating 50V X7R; LCSC C1538
C15: 47pF; C_0402_1005Metric; Rating 50V C0G; LCSC C1567
C16, C19, C21, C22, C28: 10uF; C_0603_1608Metric; Rating 10V X5R; LCSC C19702
C20: 10pF; C_0402_1005Metric; Rating 50V C0G; LCSC C32949
C23, C24: 1uF; C_0402_1005Metric; Rating 25V X5R; LCSC C52923
D1: BZT52C12; D_SOD-123; LCSC C43491
D2: SMBJ28A; D_SMB; LCSC C113997
D3: B360A-13-F; D_SMA; LCSC C94193
D4: GREEN PWR; LED_0603_1608Metric; LCSC C2986059
F1: 0.5A; Fuse_1206_3216Metric; LCSC C69688
J1: BATT PADS; PowerPads_2x_3x5mm
L1: 4.7uH; L_Changjiang_FXL0530; LCSC C177246
L2: 2.2uH; L_1008_2520Metric; LCSC C98350
Q1: DMP4013LFGQ-13; Diodes_PowerDI3333-8; LCSC C7264680
R1, R2, R11, R18, R19, R21, R24: 100k; R_0402_1005Metric; LCSC C25741
R3, R9, R12, R13, R14, R15, R16, R22, R25: 10k; R_0402_1005Metric; LCSC C25744
R4: 1k; R_0402_1005Metric; LCSC C11702
R5: 147k; R_0402_1005Metric; LCSC C64171
R6: 36k; R_0402_1005Metric; LCSC C43676
R7: 162k; R_0402_1005Metric; LCSC C54068
R8: 53.6k; R_0402_1005Metric; LCSC C53398
R10: 9.09k; R_0402_1005Metric; LCSC C11549
R17: 453k; R_0402_1005Metric; LCSC C27009
R20: 20k; R_0402_1005Metric; LCSC C25765
R23: 22k; R_0402_1005Metric; LCSC C25768
R26: 2k; R_0402_1005Metric; LCSC C4109
U1: TPS54360BDDAR; TI_SO-PowerPAD-8_ThermalVias; LCSC C524806
U2, U3: LM66100DCKR; SOT-363_SC-70-6; LCSC C2869734
U4: TLV62569DBVR; SOT-23-5; LCSC C141836
U5: LP5907MFX-3.3/NOPB; SOT-23-5; LCSC C80670
U6, U7: TPS2553DBVR; SOT-23-6; LCSC C55266

Connections:
+3V3: C20.1, C21.1, C22.1, D4.2 (A), L2.2, R12.2, R17.1, R19.2, R21.2, R22.2, R24.2, R25.2; also elsewhere on the board
+3V3_SENS: C24.1, U5.5 (OUT); also elsewhere on the board
+5V: C10.1, C11.1, C12.1, C13.1, C25.1, C27.1, L1.2, R8.1, R13.1, U2.1 (VIN), U3.3 (~CE), U6.1 (IN), U7.1 (IN); also elsewhere on the board
+5V_CAN: C28.1, U7.6 (OUT); also elsewhere on the board
+5V_FMU: C16.1, C17.1, C19.1, C23.1, R15.1, U2.6 (VOUT), U3.6 (VOUT), U4.1 (EN), U4.4 (VIN), U5.1 (IN); also elsewhere on the board
+5V_PERIPH: C26.1, U6.6 (OUT); also elsewhere on the board
BATT_CURR_SENSE: C5.1, R4.2; also elsewhere on the board
BUCK_BOOT: C9.1, U1.1 (BOOT)
BUCK_COMP: C15.1, R10.1, U1.6 (COMP)
BUCK_CZ: C14.1, R10.2
BUCK_EN: R5.2, R6.1, U1.3 (EN)
BUCK_FB: R8.2, R9.1, U1.5 (FB)
BUCK_RT: R7.1, U1.4 (RT/CLK)
BUCK_SW: C9.2, D3.1 (K), L1.1, U1.8 (SW)
CAN5V_EN: R24.1, U7.3 (EN); also elsewhere on the board
CAN5V_ILIM: R23.1, U7.5 (ILIM)
CAN5V_nOC: R25.1, U7.4 (~FAULT); also elsewhere on the board
ESC_CURR: R4.1; also elsewhere on the board
FB_3V3: C20.2, R17.2, R18.1, U4.5 (FB)
GND: C1.2, C2.2, C3.2, C4.2, C5.2, C6.2, C7.2, C10.2, C11.2, C12.2, C13.2, C14.2, C15.2, C16.2, C17.2, C18.2, C19.2, C21.2, C22.2, C23.2, C24.2, C25.2, C26.2, C27.2, C28.2, D2.2 (A), D3.2 (A), J1.2, R1.2, R3.2, R6.2, R7.2, R9.2, R11.2, R14.2, R16.2, R18.2, R20.2, R23.2, R26.2, U1.7 (GND), U1.9 (GNDPAD), U2.2 (GND), U2.3 (~CE), U3.2 (GND), U4.2 (GND), U5.2 (GND), U6.2 (GND), U7.2 (GND); also elsewhere on the board
MAIN_5V_DET: R13.2, R14.1; also elsewhere on the board
MAIN_ST: R11.1, U2.5 (ST)
PERIPH_EN: R21.1, U6.3 (EN); also elsewhere on the board
PERIPH_ILIM: R20.1, U6.5 (ILIM)
PERIPH_nOC: R22.1, U6.4 (~FAULT); also elsewhere on the board
PWR_LED_K: D4.1 (K), R26.1
RPP_G: D1.2 (A), Q1.4 (G), R1.1
SENS_EN: R19.1, U5.3 (EN); also elsewhere on the board
SW_3V3: L2.1, U4.3 (SW)
USB_PWR_SEL: R12.1, U3.5 (ST); also elsewhere on the board
USB_VBUS: F1.1; also elsewhere on the board
USB_VBUS_F: F1.2, U3.1 (VIN)
V5_SENSE: C18.1, R15.2, R16.1; also elsewhere on the board
VBAT: C1.1, C2.1, C3.1, C6.1, C7.1, D1.1 (K), D2.1 (K), Q1.1 (S), Q1.2 (S), Q1.3 (S), R2.1, R5.1, U1.2 (VIN); also elsewhere on the board
VBAT_RAW: J1.1, Q1.5 (D); also elsewhere on the board
VBAT_SENSE: C4.1, R2.2, R3.1; also elsewhere on the board

Notes on the sheet:
Battery input, reverse-polarity and surge protection
Battery voltage and ESC current sensing
5 V buck: TPS54360B, 3.5 A, 597 kHz
+5V_FMU: ideal-diode OR, buck has priority over USB
+3V3: TLV62569 2 A buck
+3V3_SENS: low-noise LDO, MCU-switchable
Current-limited peripheral power
Power LED and ERC flags
Power tree: VBAT (2S-6S) -> RPP P-FET -> TVS -> TPS54360B buck (+5V, 3.5 A, 597 kHz). +5V -> LM66100 ideal diode -> +5V_FMU (USB backs it up through a second LM66100 that the buck overrides). +5V_FMU -> TLV62569 -> +3V3 (MCU, SD, CAN VIO); +5V_FMU -> LP5907 -> +3V3_SENS (IMUs, baro; MCU-switchable)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

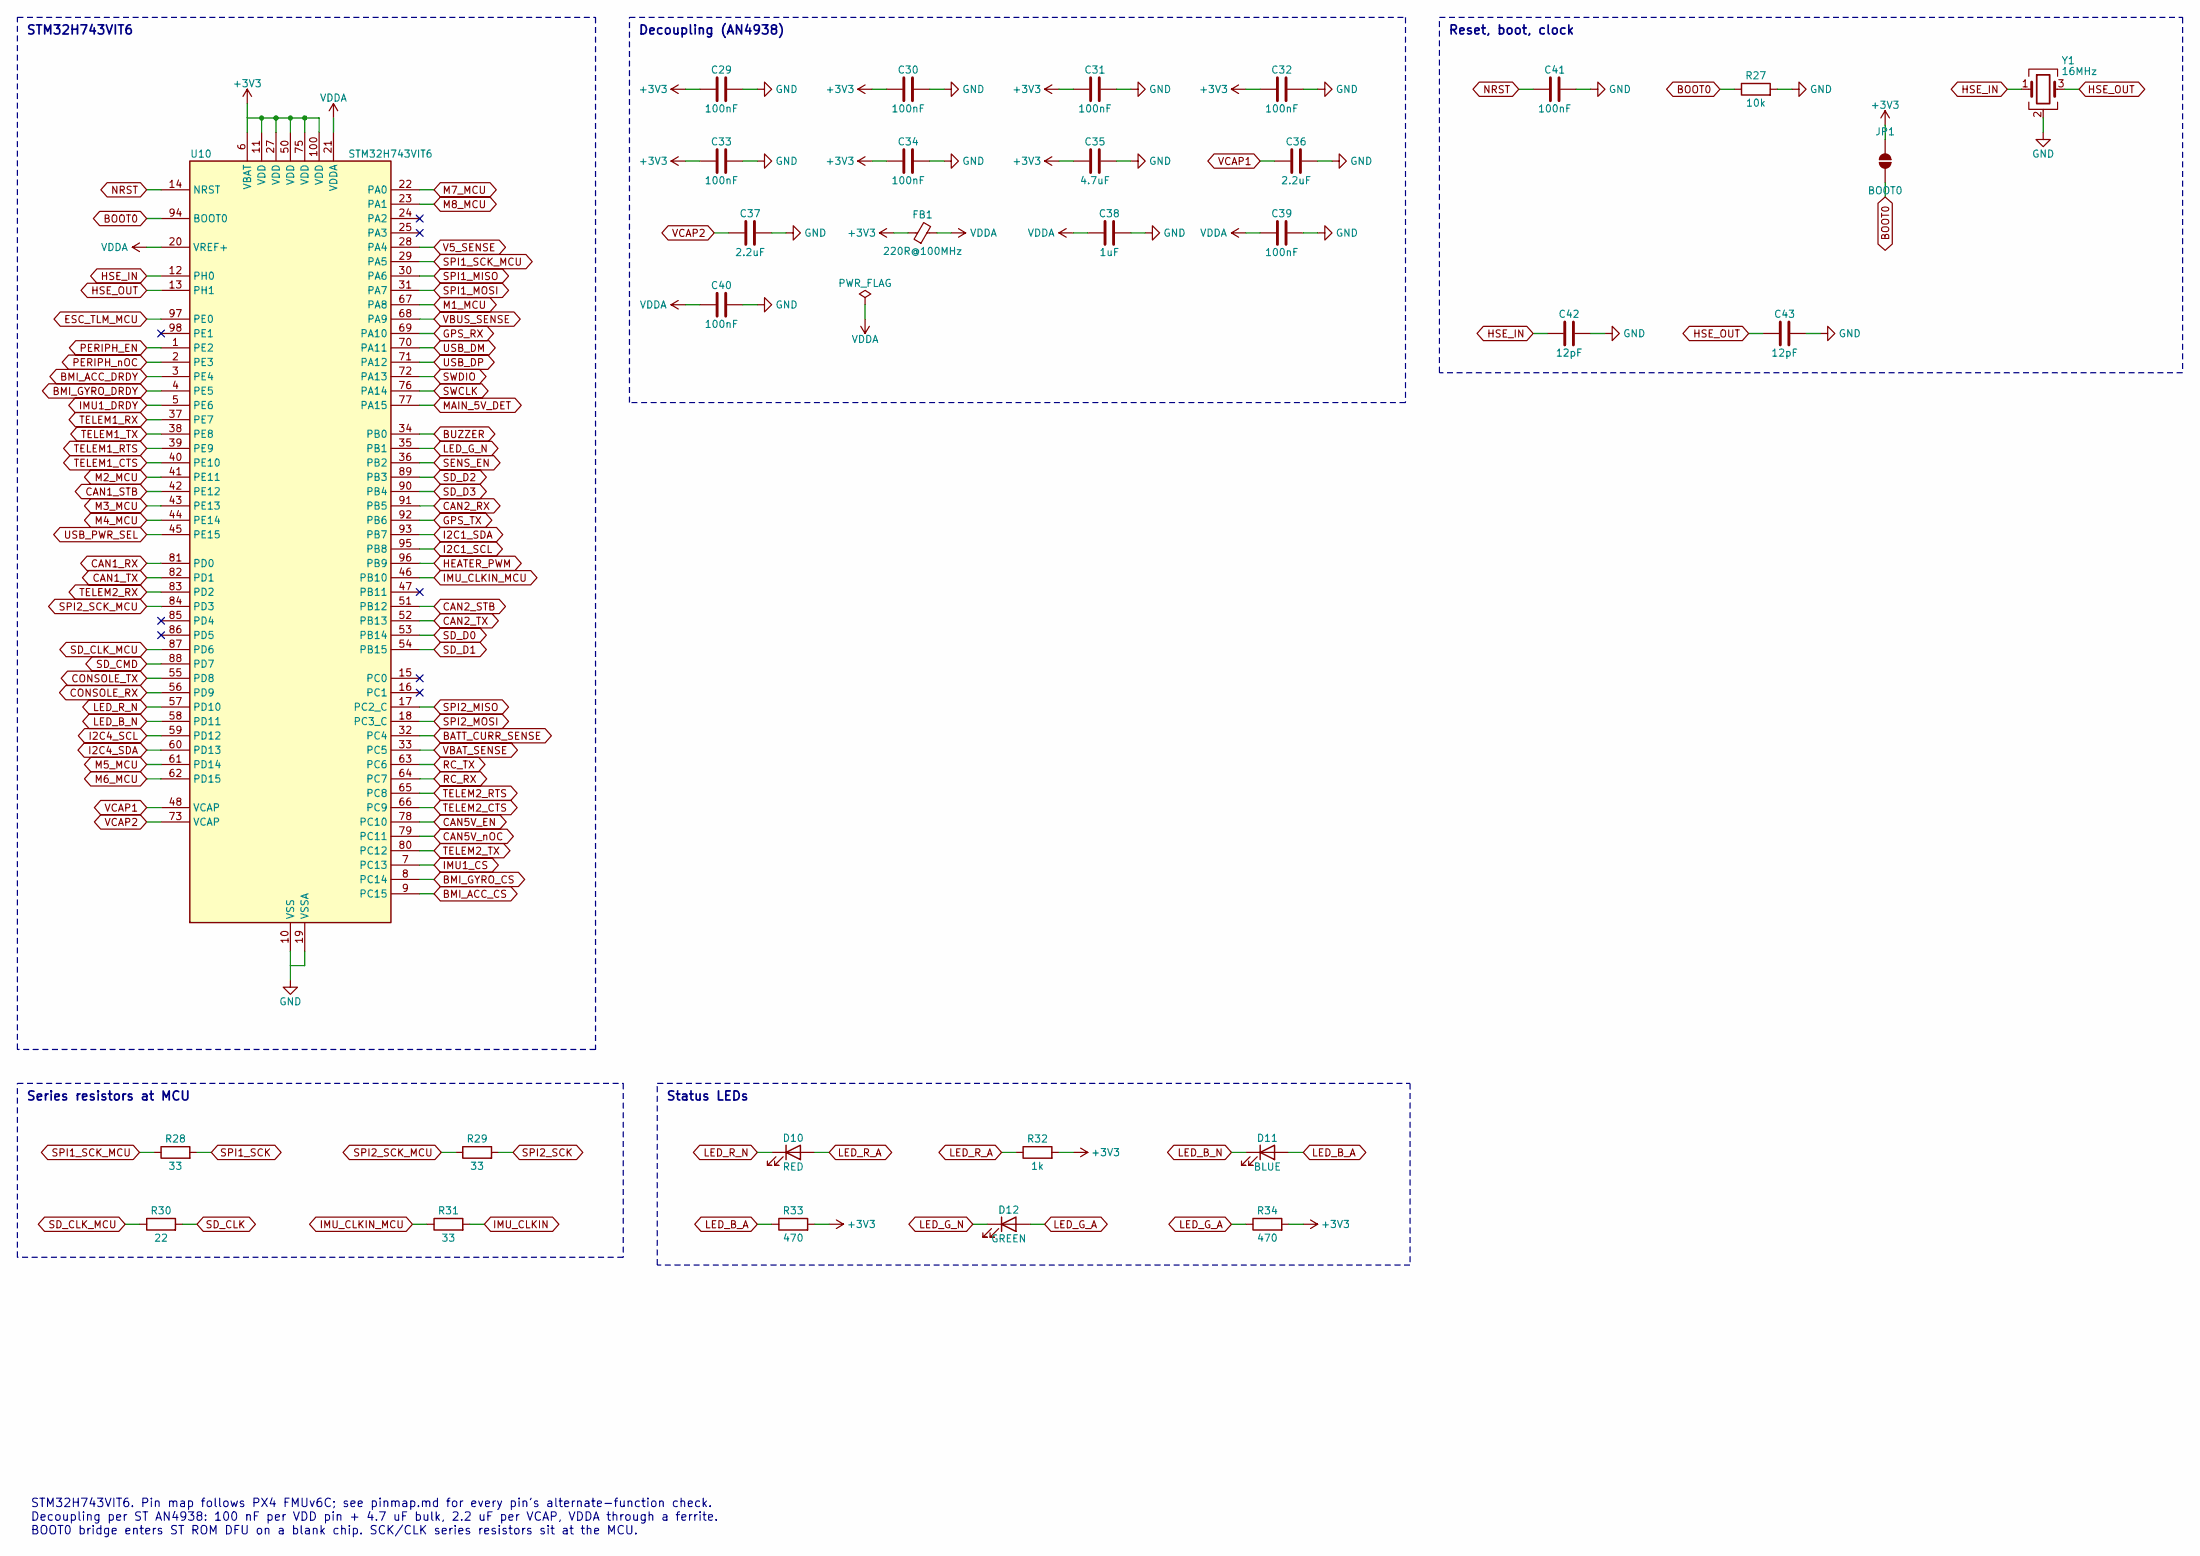
[picture p33: schematic mcu.kicad_sch, GPS-denied quadrotor flight controller: MCU]

Parts:
C29, C30, C31, C32, C33, C34, C39, C40, C41: 100nF; C_0402_1005Metric; Rating 16V X7R; LCSC C1525
C35: 4.7uF; C_0603_1608Metric; Rating 25V X5R; LCSC C19666
C36, C37: 2.2uF; C_0402_1005Metric; Rating 10V X5R; LCSC C12530
C38: 1uF; C_0402_1005Metric; Rating 25V X5R; LCSC C52923
C42, C43: 12pF; C_0402_1005Metric; Rating 50V C0G; LCSC C1547
D10: RED; LED_0603_1608Metric; LCSC C2286
D11: BLUE; LED_0603_1608Metric; LCSC C965807
D12: GREEN; LED_0603_1608Metric; LCSC C2986059
FB1: 220R@100MHz; L_0402_1005Metric; LCSC C76885
JP1: BOOT0; SolderJumper-2_P1.3mm_Open_RoundedPad1.0x1.5mm
R27: 10k; R_0402_1005Metric; LCSC C25744
R28, R29, R31: 33; R_0402_1005Metric; LCSC C25105
R30: 22; R_0402_1005Metric; LCSC C25092
R32: 1k; R_0402_1005Metric; LCSC C11702
R33, R34: 470; R_0402_1005Metric; LCSC C25117
U10: STM32H743VIT6; LQFP-100_14x14mm_P0.5mm; LCSC C114409
Y1: 16MHz; Crystal_SMD_3225-4Pin_3.2x2.5mm; LCSC C13738

Connections:
+3V3: C29.1, C30.1, C31.1, C32.1, C33.1, C34.1, C35.1, FB1.1, JP1.2 (B), R32.2, R33.2, R34.2, U10.6 (VBAT), U10.11 (VDD), U10.27 (VDD), U10.50 (VDD), U10.75 (VDD), U10.100 (VDD); also elsewhere on the board
BATT_CURR_SENSE: U10.32 (PC4); also elsewhere on the board
BMI_ACC_CS: U10.9 (PC15); also elsewhere on the board
BMI_ACC_DRDY: U10.3 (PE4); also elsewhere on the board
BMI_GYRO_CS: U10.8 (PC14); also elsewhere on the board
BMI_GYRO_DRDY: U10.4 (PE5); also elsewhere on the board
BOOT0: JP1.1 (A), R27.1, U10.94 (BOOT0)
BUZZER: U10.34 (PB0); also elsewhere on the board
CAN1_RX: U10.81 (PD0); also elsewhere on the board
CAN1_STB: U10.42 (PE12); also elsewhere on the board
CAN1_TX: U10.82 (PD1); also elsewhere on the board
CAN2_RX: U10.91 (PB5); also elsewhere on the board
CAN2_STB: U10.51 (PB12); also elsewhere on the board
CAN2_TX: U10.52 (PB13); also elsewhere on the board
CAN5V_EN: U10.78 (PC10); also elsewhere on the board
CAN5V_nOC: U10.79 (PC11); also elsewhere on the board
CONSOLE_RX: U10.56 (PD9); also elsewhere on the board
CONSOLE_TX: U10.55 (PD8); also elsewhere on the board
ESC_TLM_MCU: U10.97 (PE0); also elsewhere on the board
GND: C29.2, C30.2, C31.2, C32.2, C33.2, C34.2, C35.2, C36.2, C37.2, C38.2, C39.2, C40.2, C41.2, C42.2, C43.2, R27.2, U10.10 (VSS), U10.19 (VSSA), U10.26 (VSS), U10.49 (VSS), U10.74 (VSS), U10.99 (VSS), Y1.2 (G), Y1.4 (G); also elsewhere on the board
GPS_RX: U10.69 (PA10); also elsewhere on the board
GPS_TX: U10.92 (PB6); also elsewhere on the board
HEATER_PWM: U10.96 (PB9); also elsewhere on the board
HSE_IN: C42.1, U10.12 (PH0), Y1.1
HSE_OUT: C43.1, U10.13 (PH1), Y1.3
I2C1_SCL: U10.95 (PB8); also elsewhere on the board
I2C1_SDA: U10.93 (PB7); also elsewhere on the board
I2C4_SCL: U10.59 (PD12); also elsewhere on the board
I2C4_SDA: U10.60 (PD13); also elsewhere on the board
IMU1_CS: U10.7 (PC13); also elsewhere on the board
IMU1_DRDY: U10.5 (PE6); also elsewhere on the board
IMU_CLKIN: R31.2; also elsewhere on the board
IMU_CLKIN_MCU: R31.1, U10.46 (PB10)
LED_B_A: D11.2 (A), R33.1
LED_B_N: D11.1 (K), U10.58 (PD11)
LED_G_A: D12.2 (A), R34.1
LED_G_N: D12.1 (K), U10.35 (PB1)
LED_R_A: D10.2 (A), R32.1
LED_R_N: D10.1 (K), U10.57 (PD10)
M1_MCU: U10.67 (PA8); also elsewhere on the board
M2_MCU: U10.41 (PE11); also elsewhere on the board
M3_MCU: U10.43 (PE13); also elsewhere on the board
M4_MCU: U10.44 (PE14); also elsewhere on the board
M5_MCU: U10.61 (PD14); also elsewhere on the board
M6_MCU: U10.62 (PD15); also elsewhere on the board
M7_MCU: U10.22 (PA0); also elsewhere on the board
M8_MCU: U10.23 (PA1); also elsewhere on the board
MAIN_5V_DET: U10.77 (PA15); also elsewhere on the board
NRST: C41.1, U10.14 (NRST); also elsewhere on the board
PERIPH_EN: U10.1 (PE2); also elsewhere on the board
PERIPH_nOC: U10.2 (PE3); also elsewhere on the board
RC_RX: U10.64 (PC7); also elsewhere on the board
RC_TX: U10.63 (PC6); also elsewhere on the board
SD_CLK: R30.2; also elsewhere on the board
SD_CLK_MCU: R30.1, U10.87 (PD6)
SD_CMD: U10.88 (PD7); also elsewhere on the board
SD_D0: U10.53 (PB14); also elsewhere on the board
SD_D1: U10.54 (PB15); also elsewhere on the board
SD_D2: U10.89 (PB3); also elsewhere on the board
SD_D3: U10.90 (PB4); also elsewhere on the board
SENS_EN: U10.36 (PB2); also elsewhere on the board
SPI1_MISO: U10.30 (PA6); also elsewhere on the board
SPI1_MOSI: U10.31 (PA7); also elsewhere on the board
SPI1_SCK: R28.2; also elsewhere on the board
SPI1_SCK_MCU: R28.1, U10.29 (PA5)
SPI2_MISO: U10.17 (PC2_C); also elsewhere on the board
SPI2_MOSI: U10.18 (PC3_C); also elsewhere on the board
SPI2_SCK: R29.2; also elsewhere on the board
SPI2_SCK_MCU: R29.1, U10.84 (PD3)
SWCLK: U10.76 (PA14); also elsewhere on the board
SWDIO: U10.72 (PA13); also elsewhere on the board
TELEM1_CTS: U10.40 (PE10); also elsewhere on the board
TELEM1_RTS: U10.39 (PE9); also elsewhere on the board
TELEM1_RX: U10.37 (PE7); also elsewhere on the board
TELEM1_TX: U10.38 (PE8); also elsewhere on the board
TELEM2_CTS: U10.66 (PC9); also elsewhere on the board
TELEM2_RTS: U10.65 (PC8); also elsewhere on the board
TELEM2_RX: U10.83 (PD2); also elsewhere on the board
TELEM2_TX: U10.80 (PC12); also elsewhere on the board
USB_DM: U10.70 (PA11); also elsewhere on the board
USB_DP: U10.71 (PA12); also elsewhere on the board
USB_PWR_SEL: U10.45 (PE15); also elsewhere on the board
V5_SENSE: U10.28 (PA4); also elsewhere on the board
VBAT_SENSE: U10.33 (PC5); also elsewhere on the board
VBUS_SENSE: U10.68 (PA9); also elsewhere on the board
VCAP1: C36.1, U10.48 (VCAP)
VCAP2: C37.1, U10.73 (VCAP)
VDDA: C38.1, C39.1, C40.1, FB1.2, U10.20 (VREF+), U10.21 (VDDA)

Notes on the sheet:
STM32H743VIT6
Decoupling (AN4938)
Reset, boot, clock
Series resistors at MCU
Status LEDs
STM32H743VIT6. Pin map follows PX4 FMUv6C; see pinmap.md for every pin's alternate-function check. Decoupling per ST AN4938: 100 nF per VDD pin + 4.7 uF bulk, 2.2 uF per VCAP, VDDA through a ferrite. BOOT0 bridge enters ST ROM DFU on a blank chip. SCK/CLK series resistors sit at the MCU.

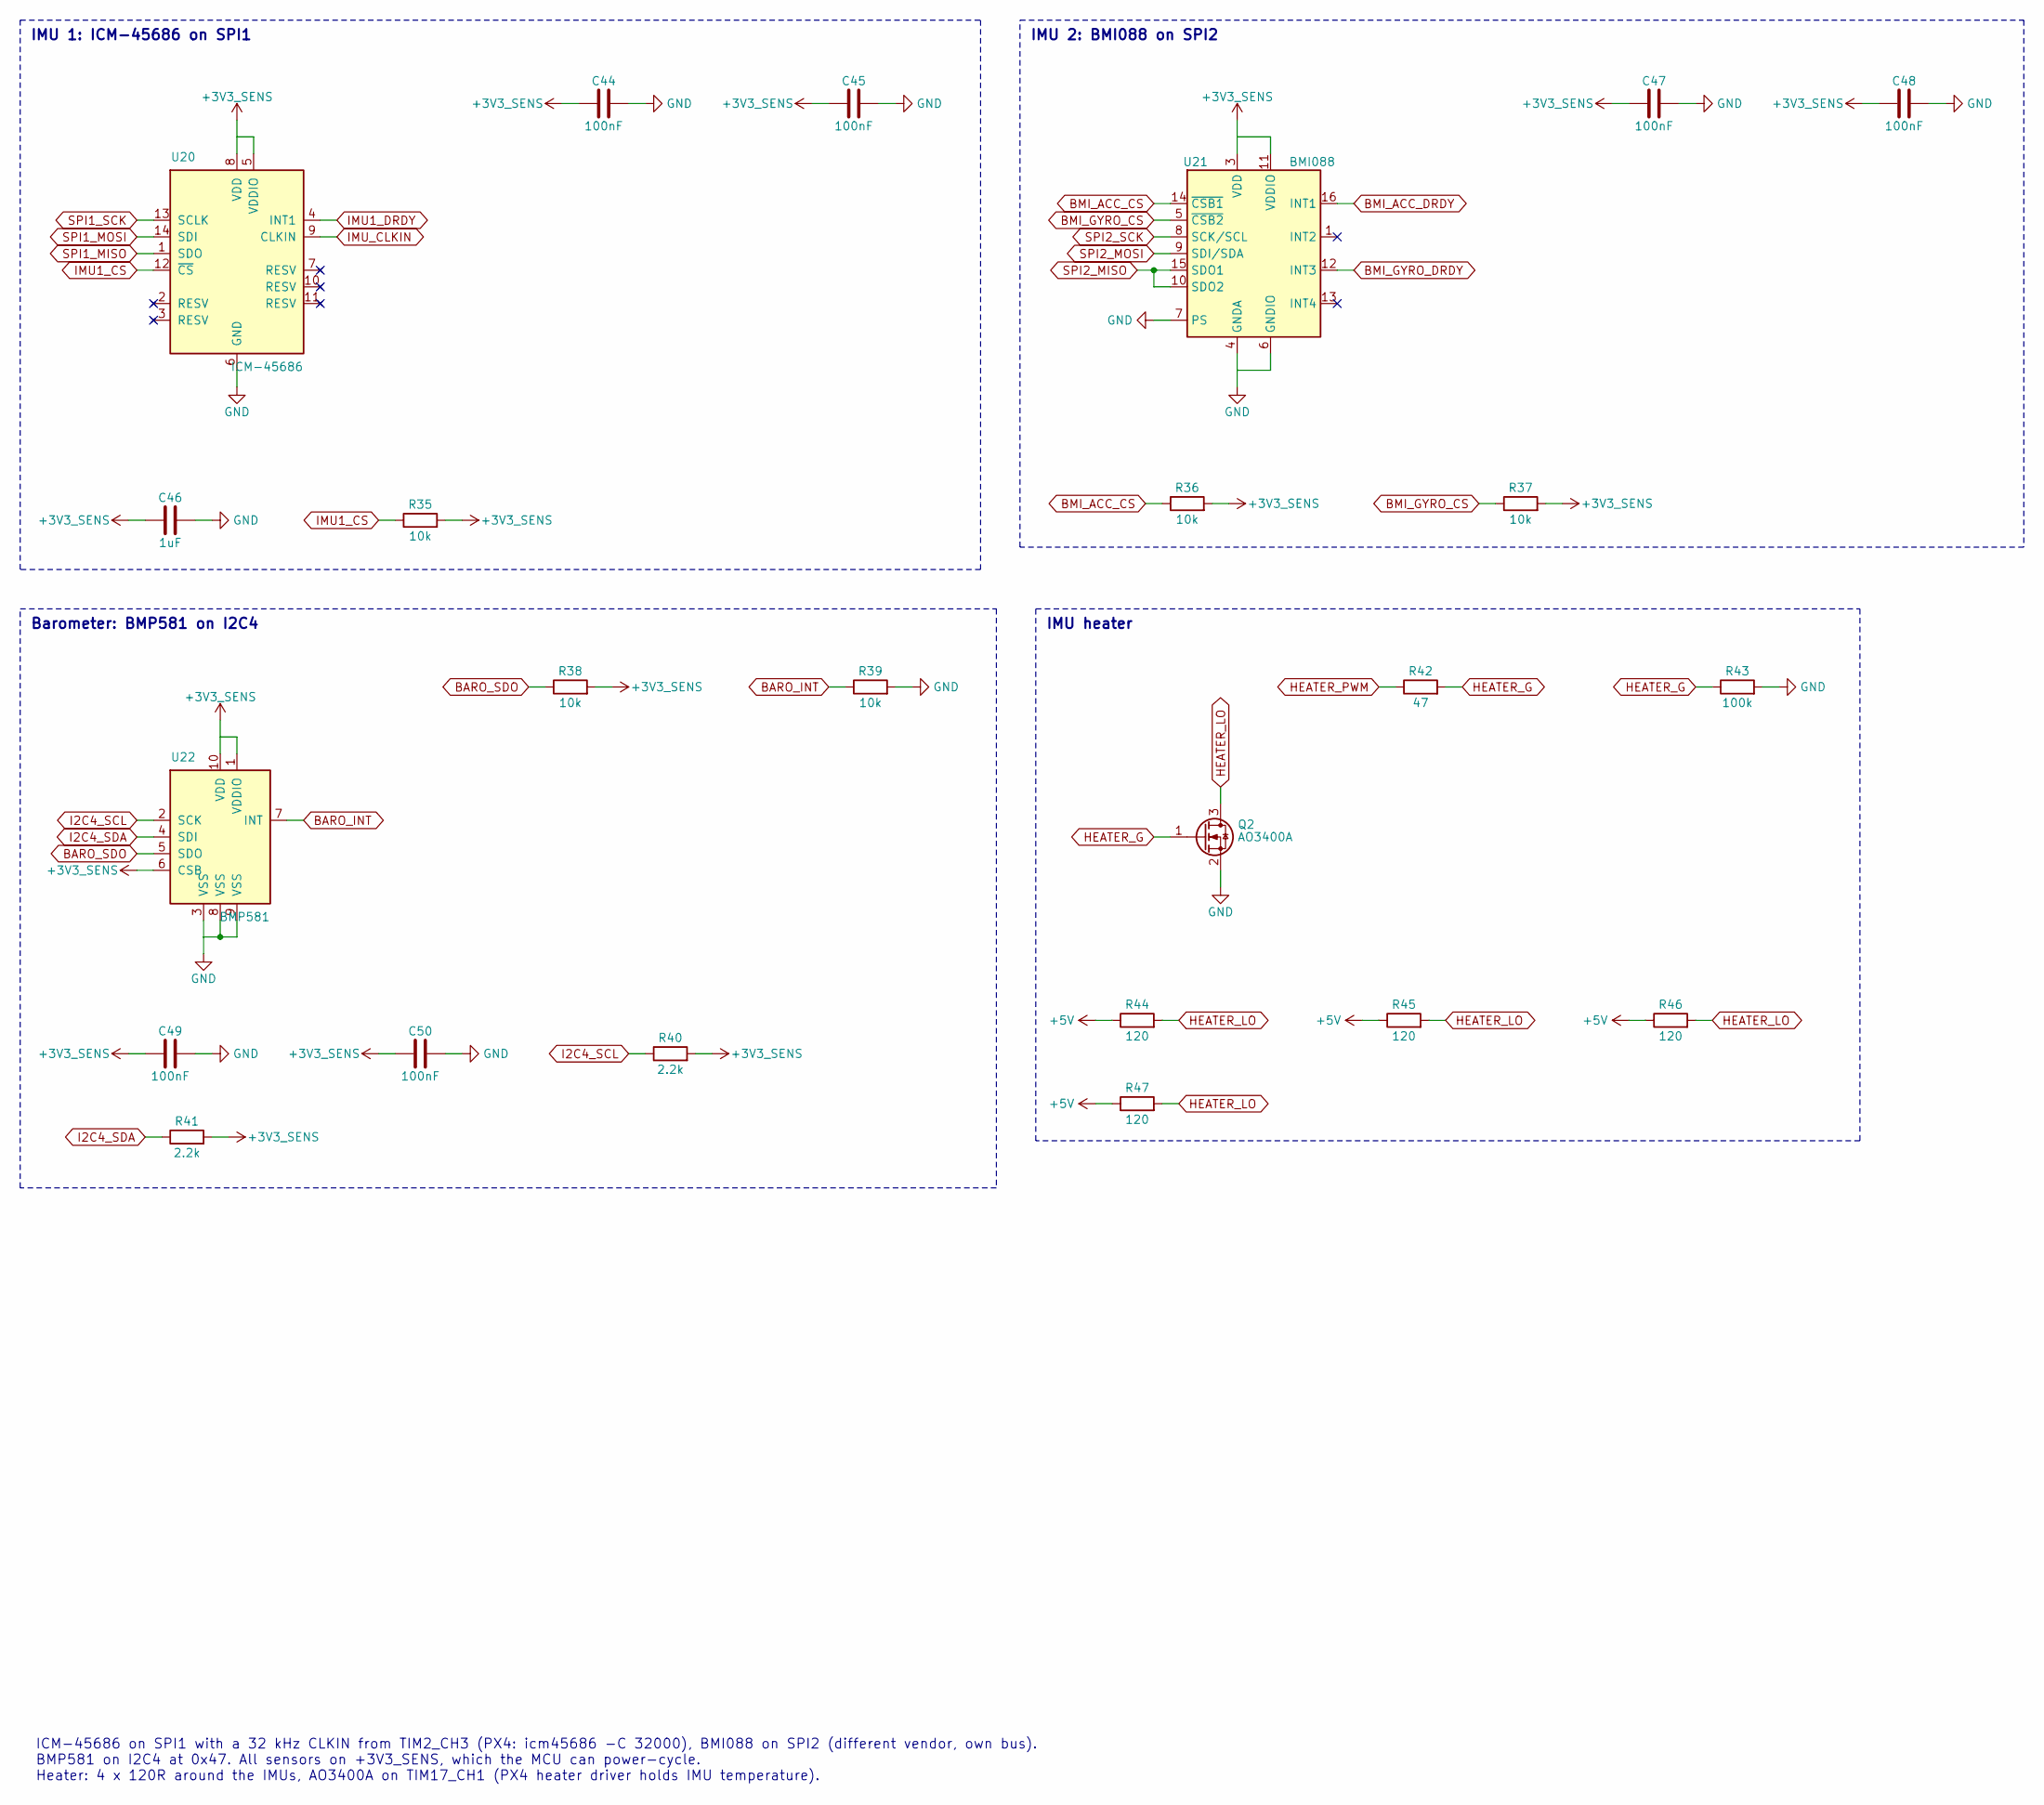
[picture p34: schematic sensors.kicad_sch, GPS-denied quadrotor flight controller: Sensors]

Parts:
C44, C45, C47, C48, C49, C50: 100nF; C_0402_1005Metric; Rating 16V X7R; LCSC C1525
C46: 1uF; C_0402_1005Metric; Rating 25V X5R; LCSC C52923
Q2: AO3400A; SOT-23; LCSC C20917
R35, R36, R37, R38, R39: 10k; R_0402_1005Metric; LCSC C25744
R40, R41: 2.2k; R_0402_1005Metric; LCSC C25879
R42: 47; R_0402_1005Metric; LCSC C25118
R43: 100k; R_0402_1005Metric; LCSC C25741
R44, R45, R46, R47: 120; R_1206_3216Metric; LCSC C17909
U20: ICM-45686; LGA-14_3x2.5mm_P0.5mm_LayoutBorder3x4y; LCSC C22459454
U21: BMI088; Bosch_LGA-16_4.5x3mm_P0.5mm_LayoutBorder7x1y_ClockwisePinNu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; LCSC C194919
U22: BMP581; Bosch_LGA-10_2x2mm_P0.5mm_BMP581; LCSC C5362283

Connections:
+3V3_SENS: C44.1, C45.1, C46.1, C47.1, C48.1, C49.1, C50.1, R35.2, R36.2, R37.2, R38.2, R40.2, R41.2, U20.5 (VDDIO), U20.8 (VDD), U21.3 (VDD), U21.11 (VDDIO), U22.1 (VDDIO), U22.6 (CSB), U22.10 (VDD); also elsewhere on the board
+5V: R44.1, R45.1, R46.1, R47.1; also elsewhere on the board
BARO_INT: R39.1, U22.7 (INT)
BARO_SDO: R38.1, U22.5 (SDO)
BMI_ACC_CS: R36.1, U21.14 (~CSB1); also elsewhere on the board
BMI_ACC_DRDY: U21.16 (INT1); also elsewhere on the board
BMI_GYRO_CS: R37.1, U21.5 (~CSB2); also elsewhere on the board
BMI_GYRO_DRDY: U21.12 (INT3); also elsewhere on the board
GND: C44.2, C45.2, C46.2, C47.2, C48.2, C49.2, C50.2, Q2.2 (S), R39.2, R43.2, U20.6 (GND), U21.2 (GNDA), U21.4 (GNDA), U21.6 (GNDIO), U21.7 (PS), U22.3 (VSS), U22.8 (VSS), U22.9 (VSS); also elsewhere on the board
HEATER_G: Q2.1 (G), R42.2, R43.1
HEATER_LO: Q2.3 (D), R44.2, R45.2, R46.2, R47.2
HEATER_PWM: R42.1; also elsewhere on the board
I2C4_SCL: R40.1, U22.2 (SCK); also elsewhere on the board
I2C4_SDA: R41.1, U22.4 (SDI); also elsewhere on the board
IMU1_CS: R35.1, U20.12 (~CS); also elsewhere on the board
IMU1_DRDY: U20.4 (INT1); also elsewhere on the board
IMU_CLKIN: U20.9 (CLKIN); also elsewhere on the board
SPI1_MISO: U20.1 (SDO); also elsewhere on the board
SPI1_MOSI: U20.14 (SDI); also elsewhere on the board
SPI1_SCK: U20.13 (SCLK); also elsewhere on the board
SPI2_MISO: U21.10 (SDO2), U21.15 (SDO1); also elsewhere on the board
SPI2_MOSI: U21.9 (SDI/SDA); also elsewhere on the board
SPI2_SCK: U21.8 (SCK/SCL); also elsewhere on the board

Notes on the sheet:
IMU 1: ICM-45686 on SPI1
IMU 2: BMI088 on SPI2
Barometer: BMP581 on I2C4
IMU heater
ICM-45686 on SPI1 with a 32 kHz CLKIN from TIM2_CH3 (PX4: icm45686 -C 32000), BMI088 on SPI2 (different vendor, own bus). BMP581 on I2C4 at 0x47. All sensors on +3V3_SENS, which the MCU can power-cycle. Heater: 4 x 120R around the IMUs, AO3400A on TIM17_CH1 (PX4 heater driver holds IMU temperature).
