dvntekim/fc-h743/kicad/fc.kicad_pcb

## KiCad design kicad/fc.kicad_pcb (continued)

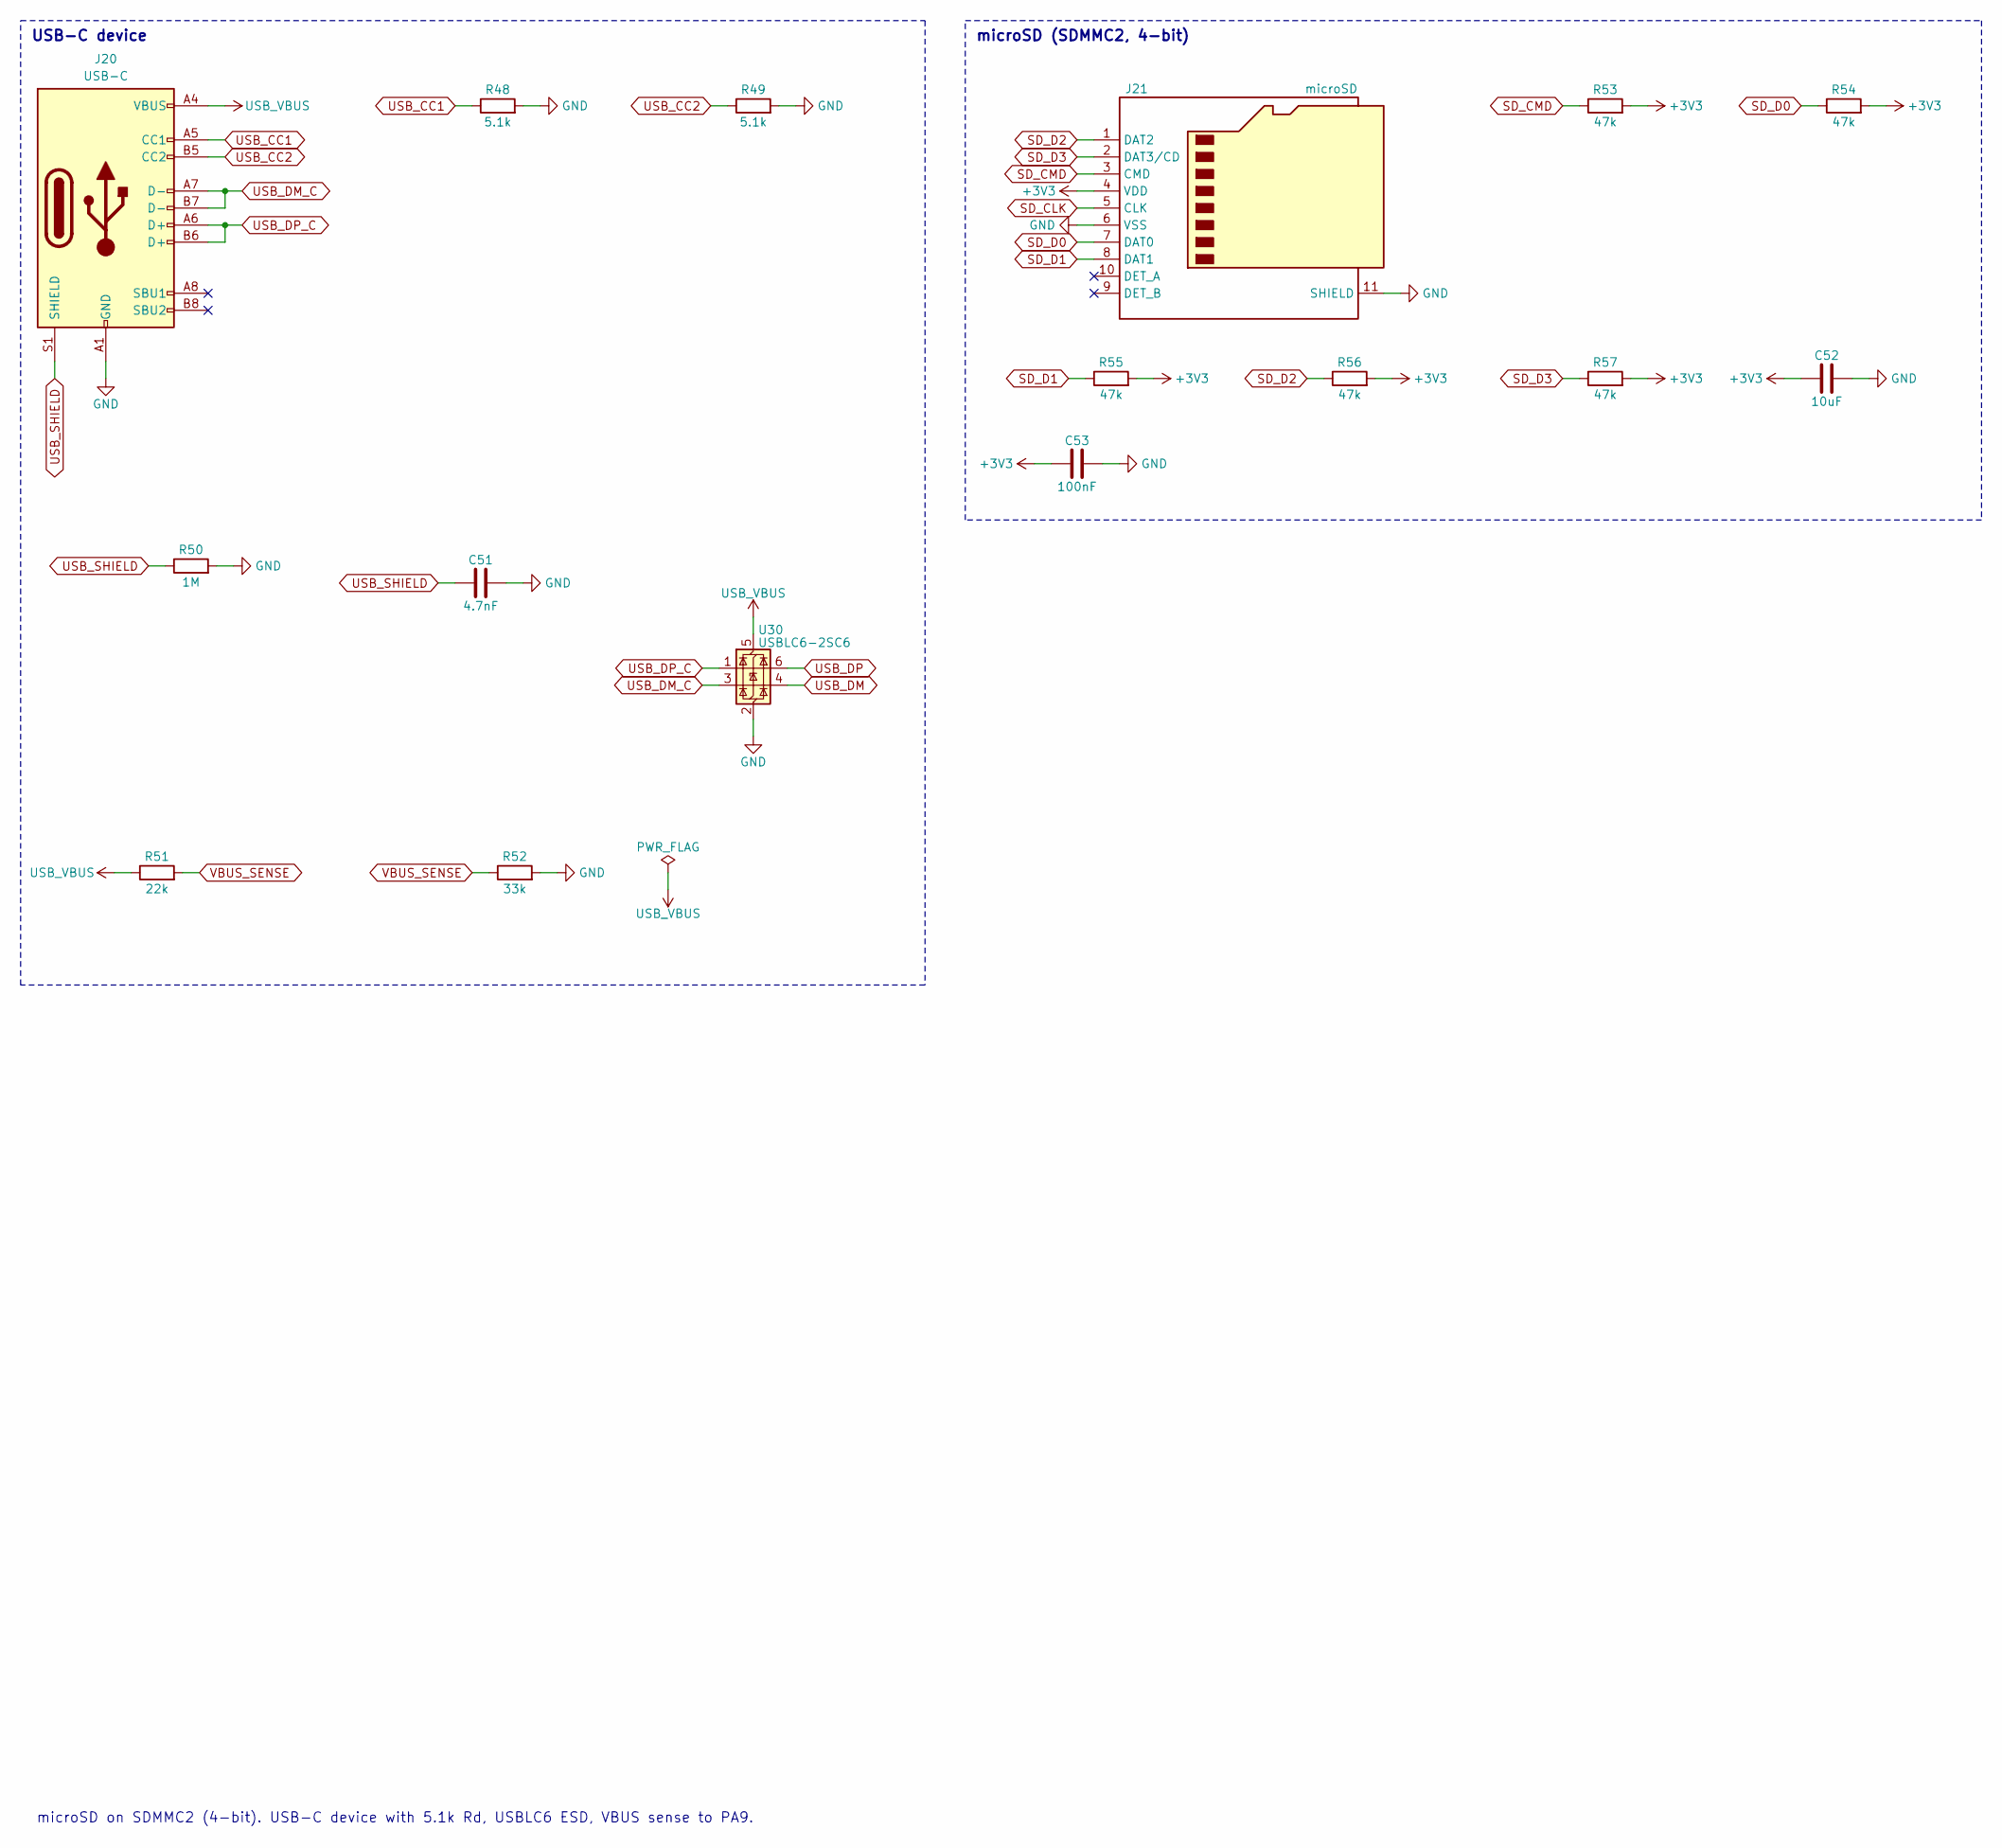
[picture p35: schematic storage_usb.kicad_sch, GPS-denied quadrotor flight controller: Storage + USB]

Parts:
C51: 4.7nF; C_0402_1005Metric; Rating 50V X7R; LCSC C1538
C52: 10uF; C_0603_1608Metric; Rating 10V X5R; LCSC C19702
C53: 100nF; C_0402_1005Metric; Rating 16V X7R; LCSC C1525
J20: USB-C; USB_C_Receptacle_HRO_TYPE-C-31-M-12; LCSC C165948
J21: microSD; microSD_HC_Hirose_DM3AT-SF-PEJM5; LCSC C114218
R48, R49: 5.1k; R_0402_1005Metric; LCSC C25905
R50: 1M; R_0402_1005Metric; LCSC C26083
R51: 22k; R_0402_1005Metric; LCSC C25768
R52: 33k; R_0402_1005Metric; LCSC C25779
R53, R54, R55, R56, R57: 47k; R_0402_1005Metric; LCSC C25792
U30: USBLC6-2SC6; SOT-23-6; LCSC C7519

Connections:
+3V3: C52.1, C53.1, J21.4 (VDD), R53.2, R54.2, R55.2, R56.2, R57.2; also elsewhere on the board
GND: C51.2, C52.2, C53.2, J20.A1 (GND), J20.A12 (GND), J20.B1 (GND), J20.B12 (GND), J21.6 (VSS), J21.11 (SHIELD), R48.2, R49.2, R50.2, R52.2, U30.2 (GND); also elsewhere on the board
SD_CLK: J21.5 (CLK); also elsewhere on the board
SD_CMD: J21.3 (CMD), R53.1; also elsewhere on the board
SD_D0: J21.7 (DAT0), R54.1; also elsewhere on the board
SD_D1: J21.8 (DAT1), R55.1; also elsewhere on the board
SD_D2: J21.1 (DAT2), R56.1; also elsewhere on the board
SD_D3: J21.2 (DAT3/CD), R57.1; also elsewhere on the board
USB_CC1: J20.A5 (CC1), R48.1
USB_CC2: J20.B5 (CC2), R49.1
USB_DM: U30.4 (I/O2); also elsewhere on the board
USB_DM_C: J20.A7 (D-), J20.B7 (D-), U30.3 (I/O2)
USB_DP: U30.6 (I/O1); also elsewhere on the board
USB_DP_C: J20.A6 (D+), J20.B6 (D+), U30.1 (I/O1)
USB_SHIELD: C51.1, J20.S1 (SHIELD), R50.1
USB_VBUS: J20.A4 (VBUS), J20.A9 (VBUS), J20.B4 (VBUS), J20.B9 (VBUS), R51.1, U30.5 (VBUS); also elsewhere on the board
VBUS_SENSE: R51.2, R52.1; also elsewhere on the board

Notes on the sheet:
USB-C device
microSD (SDMMC2, 4-bit)
microSD on SDMMC2 (4-bit). USB-C device with 5.1k Rd, USBLC6 ESD, VBUS sense to PA9.

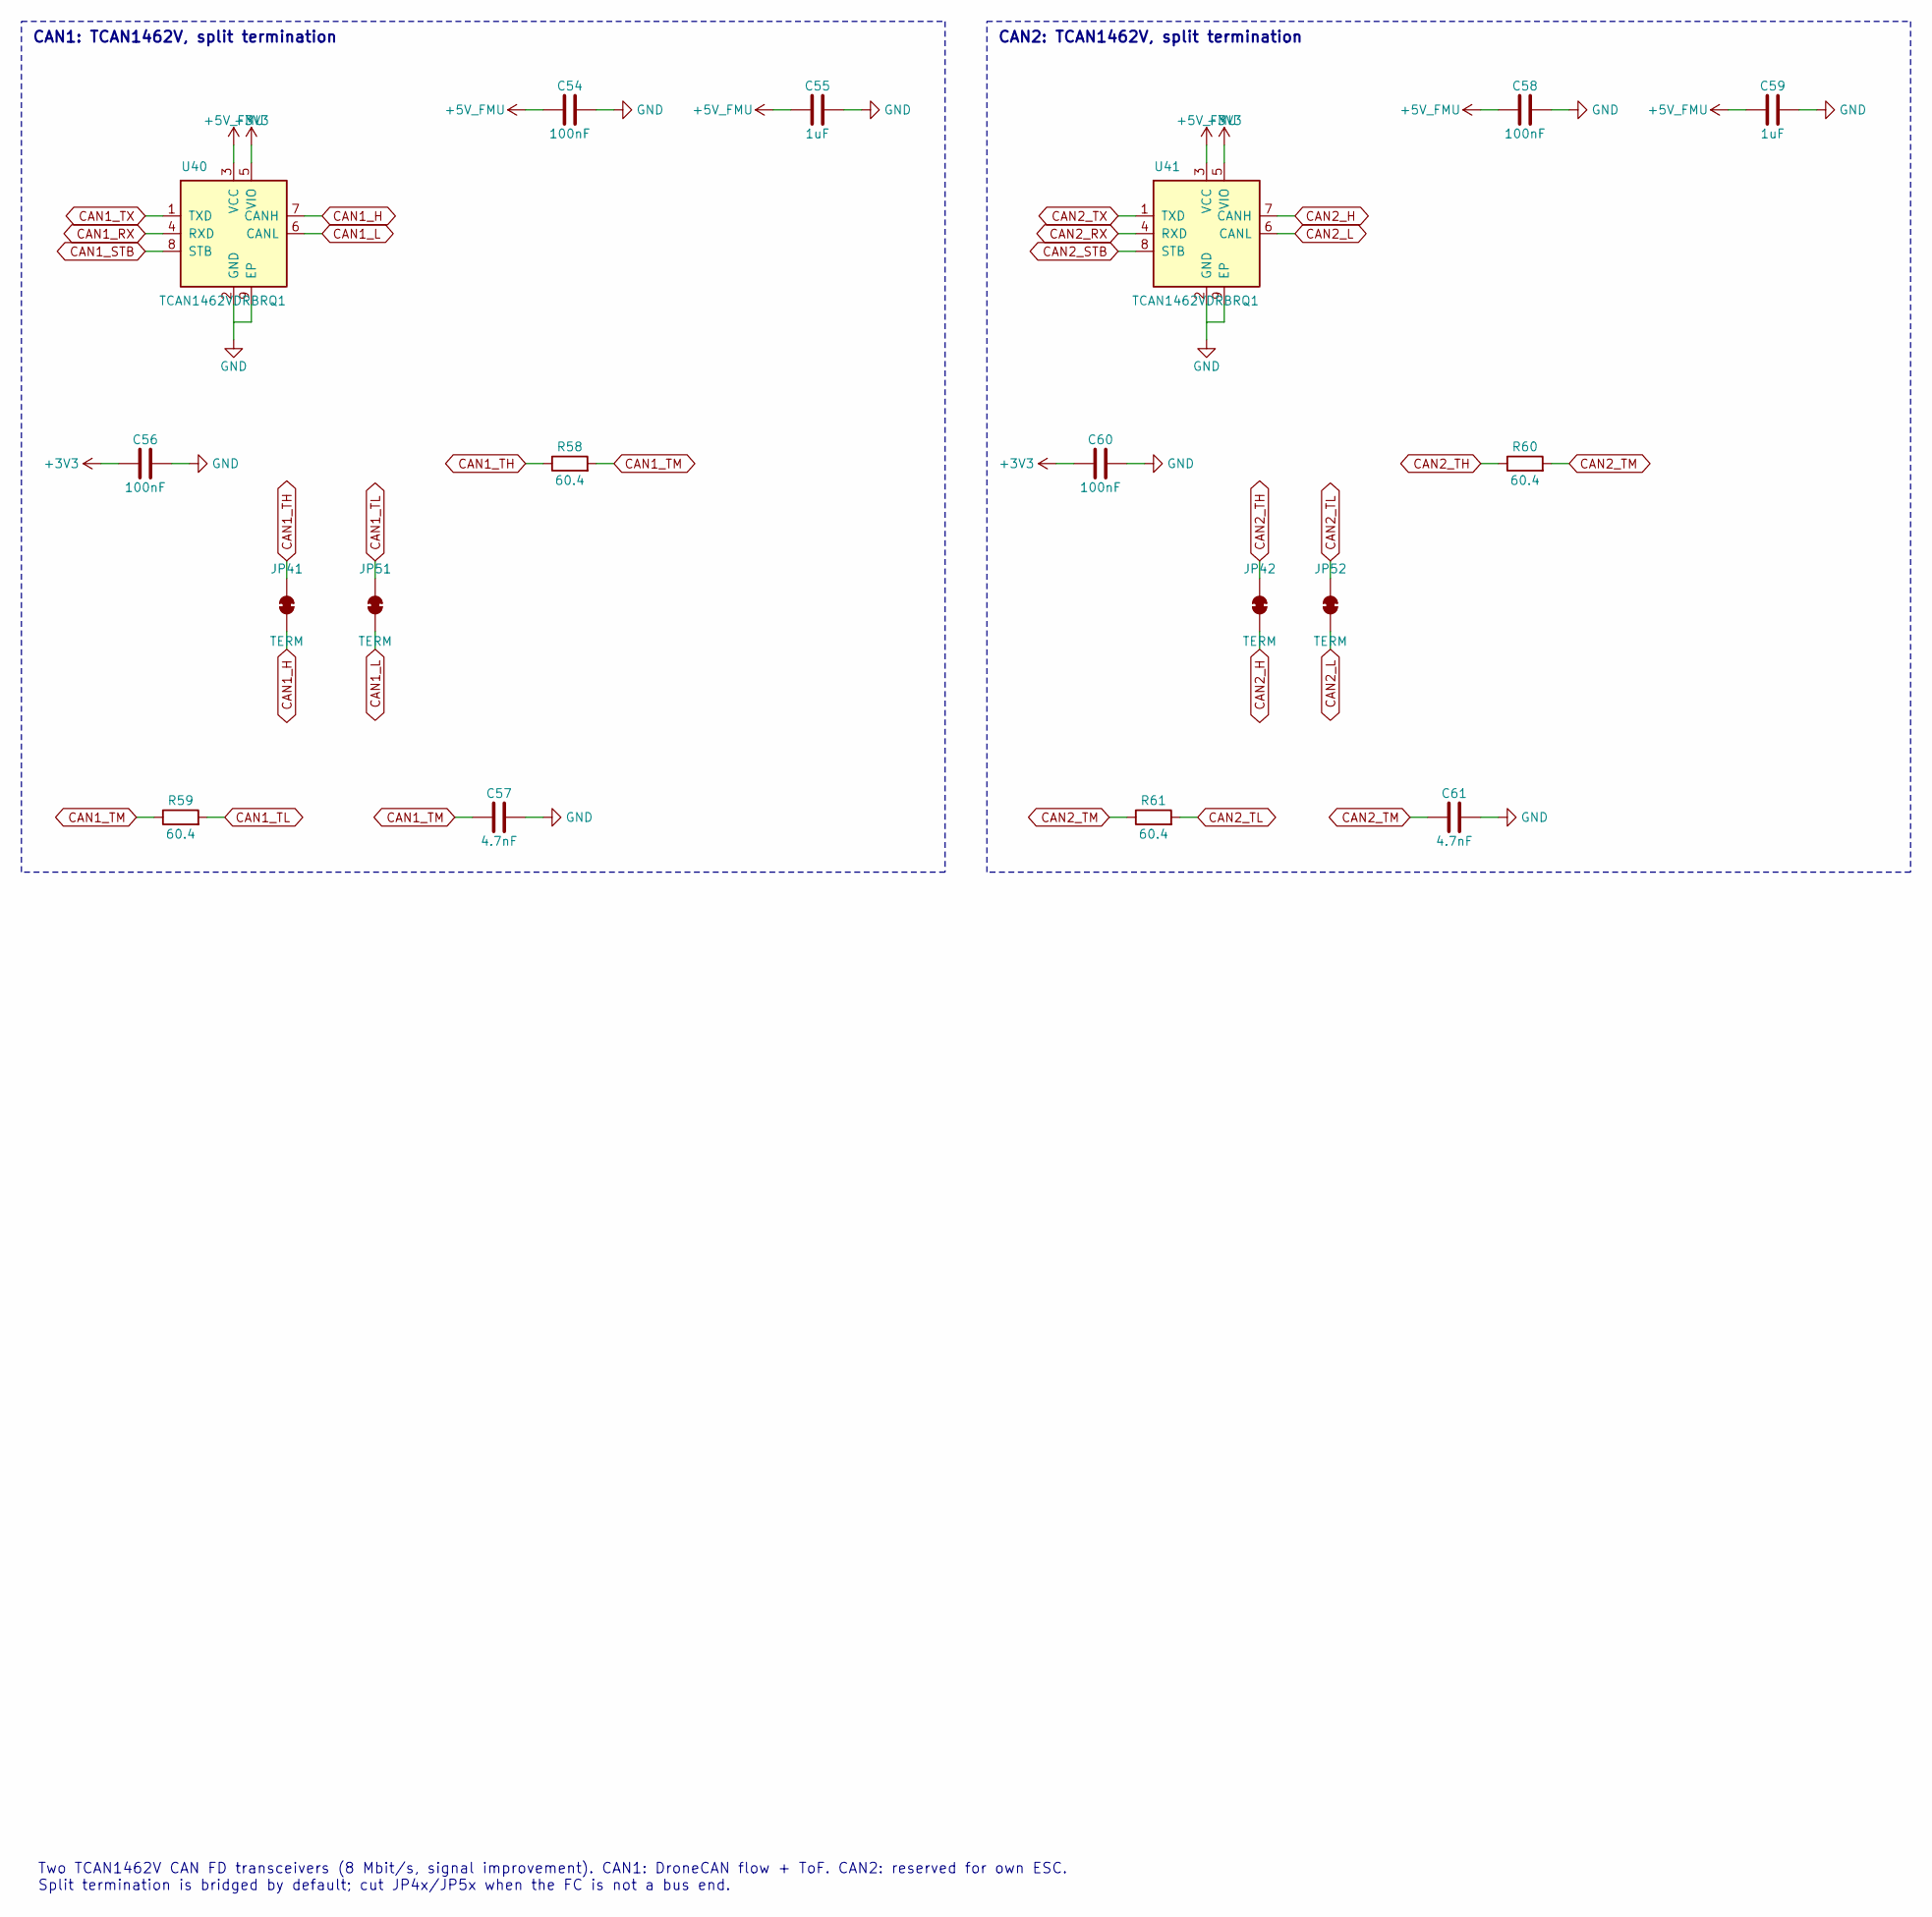
[picture p36: schematic can.kicad_sch, GPS-denied quadrotor flight controller: CAN]

Parts:
C54, C56, C58, C60: 100nF; C_0402_1005Metric; Rating 16V X7R; LCSC C1525
C55, C59: 1uF; C_0402_1005Metric; Rating 25V X5R; LCSC C52923
C57, C61: 4.7nF; C_0402_1005Metric; Rating 50V X7R; LCSC C1538
JP41, JP42, JP51, JP52: TERM; SolderJumper-2_P1.3mm_Bridged_RoundedPad1.0x1.5mm
R58, R59, R60, R61: 60.4; R_0402_1005Metric; LCSC C60310
U40, U41: TCAN1462VDRBRQ1; TI_DRB0008J_VSON-8_3x3mm_P0.65mm; LCSC C5215833

Connections:
+3V3: C56.1, C60.1, U40.5 (VIO), U41.5 (VIO); also elsewhere on the board
+5V_FMU: C54.1, C55.1, C58.1, C59.1, U40.3 (VCC), U41.3 (VCC); also elsewhere on the board
CAN1_H: JP41.1 (A), U40.7 (CANH); also elsewhere on the board
CAN1_L: JP51.1 (A), U40.6 (CANL); also elsewhere on the board
CAN1_RX: U40.4 (RXD); also elsewhere on the board
CAN1_STB: U40.8 (STB); also elsewhere on the board
CAN1_TH: JP41.2 (B), R58.1
CAN1_TL: JP51.2 (B), R59.2
CAN1_TM: C57.1, R58.2, R59.1
CAN1_TX: U40.1 (TXD); also elsewhere on the board
CAN2_H: JP42.1 (A), U41.7 (CANH); also elsewhere on the board
CAN2_L: JP52.1 (A), U41.6 (CANL); also elsewhere on the board
CAN2_RX: U41.4 (RXD); also elsewhere on the board
CAN2_STB: U41.8 (STB); also elsewhere on the board
CAN2_TH: JP42.2 (B), R60.1
CAN2_TL: JP52.2 (B), R61.2
CAN2_TM: C61.1, R60.2, R61.1
CAN2_TX: U41.1 (TXD); also elsewhere on the board
GND: C54.2, C55.2, C56.2, C57.2, C58.2, C59.2, C60.2, C61.2, U40.2 (GND), U40.9 (EP), U41.2 (GND), U41.9 (EP); also elsewhere on the board

Notes on the sheet:
CAN1: TCAN1462V, split termination
CAN2: TCAN1462V, split termination
Two TCAN1462V CAN FD transceivers (8 Mbit/s, signal improvement). CAN1: DroneCAN flow + ToF. CAN2: reserved for own ESC. Split termination is bridged by default; cut JP4x/JP5x when the FC is not a bus end.

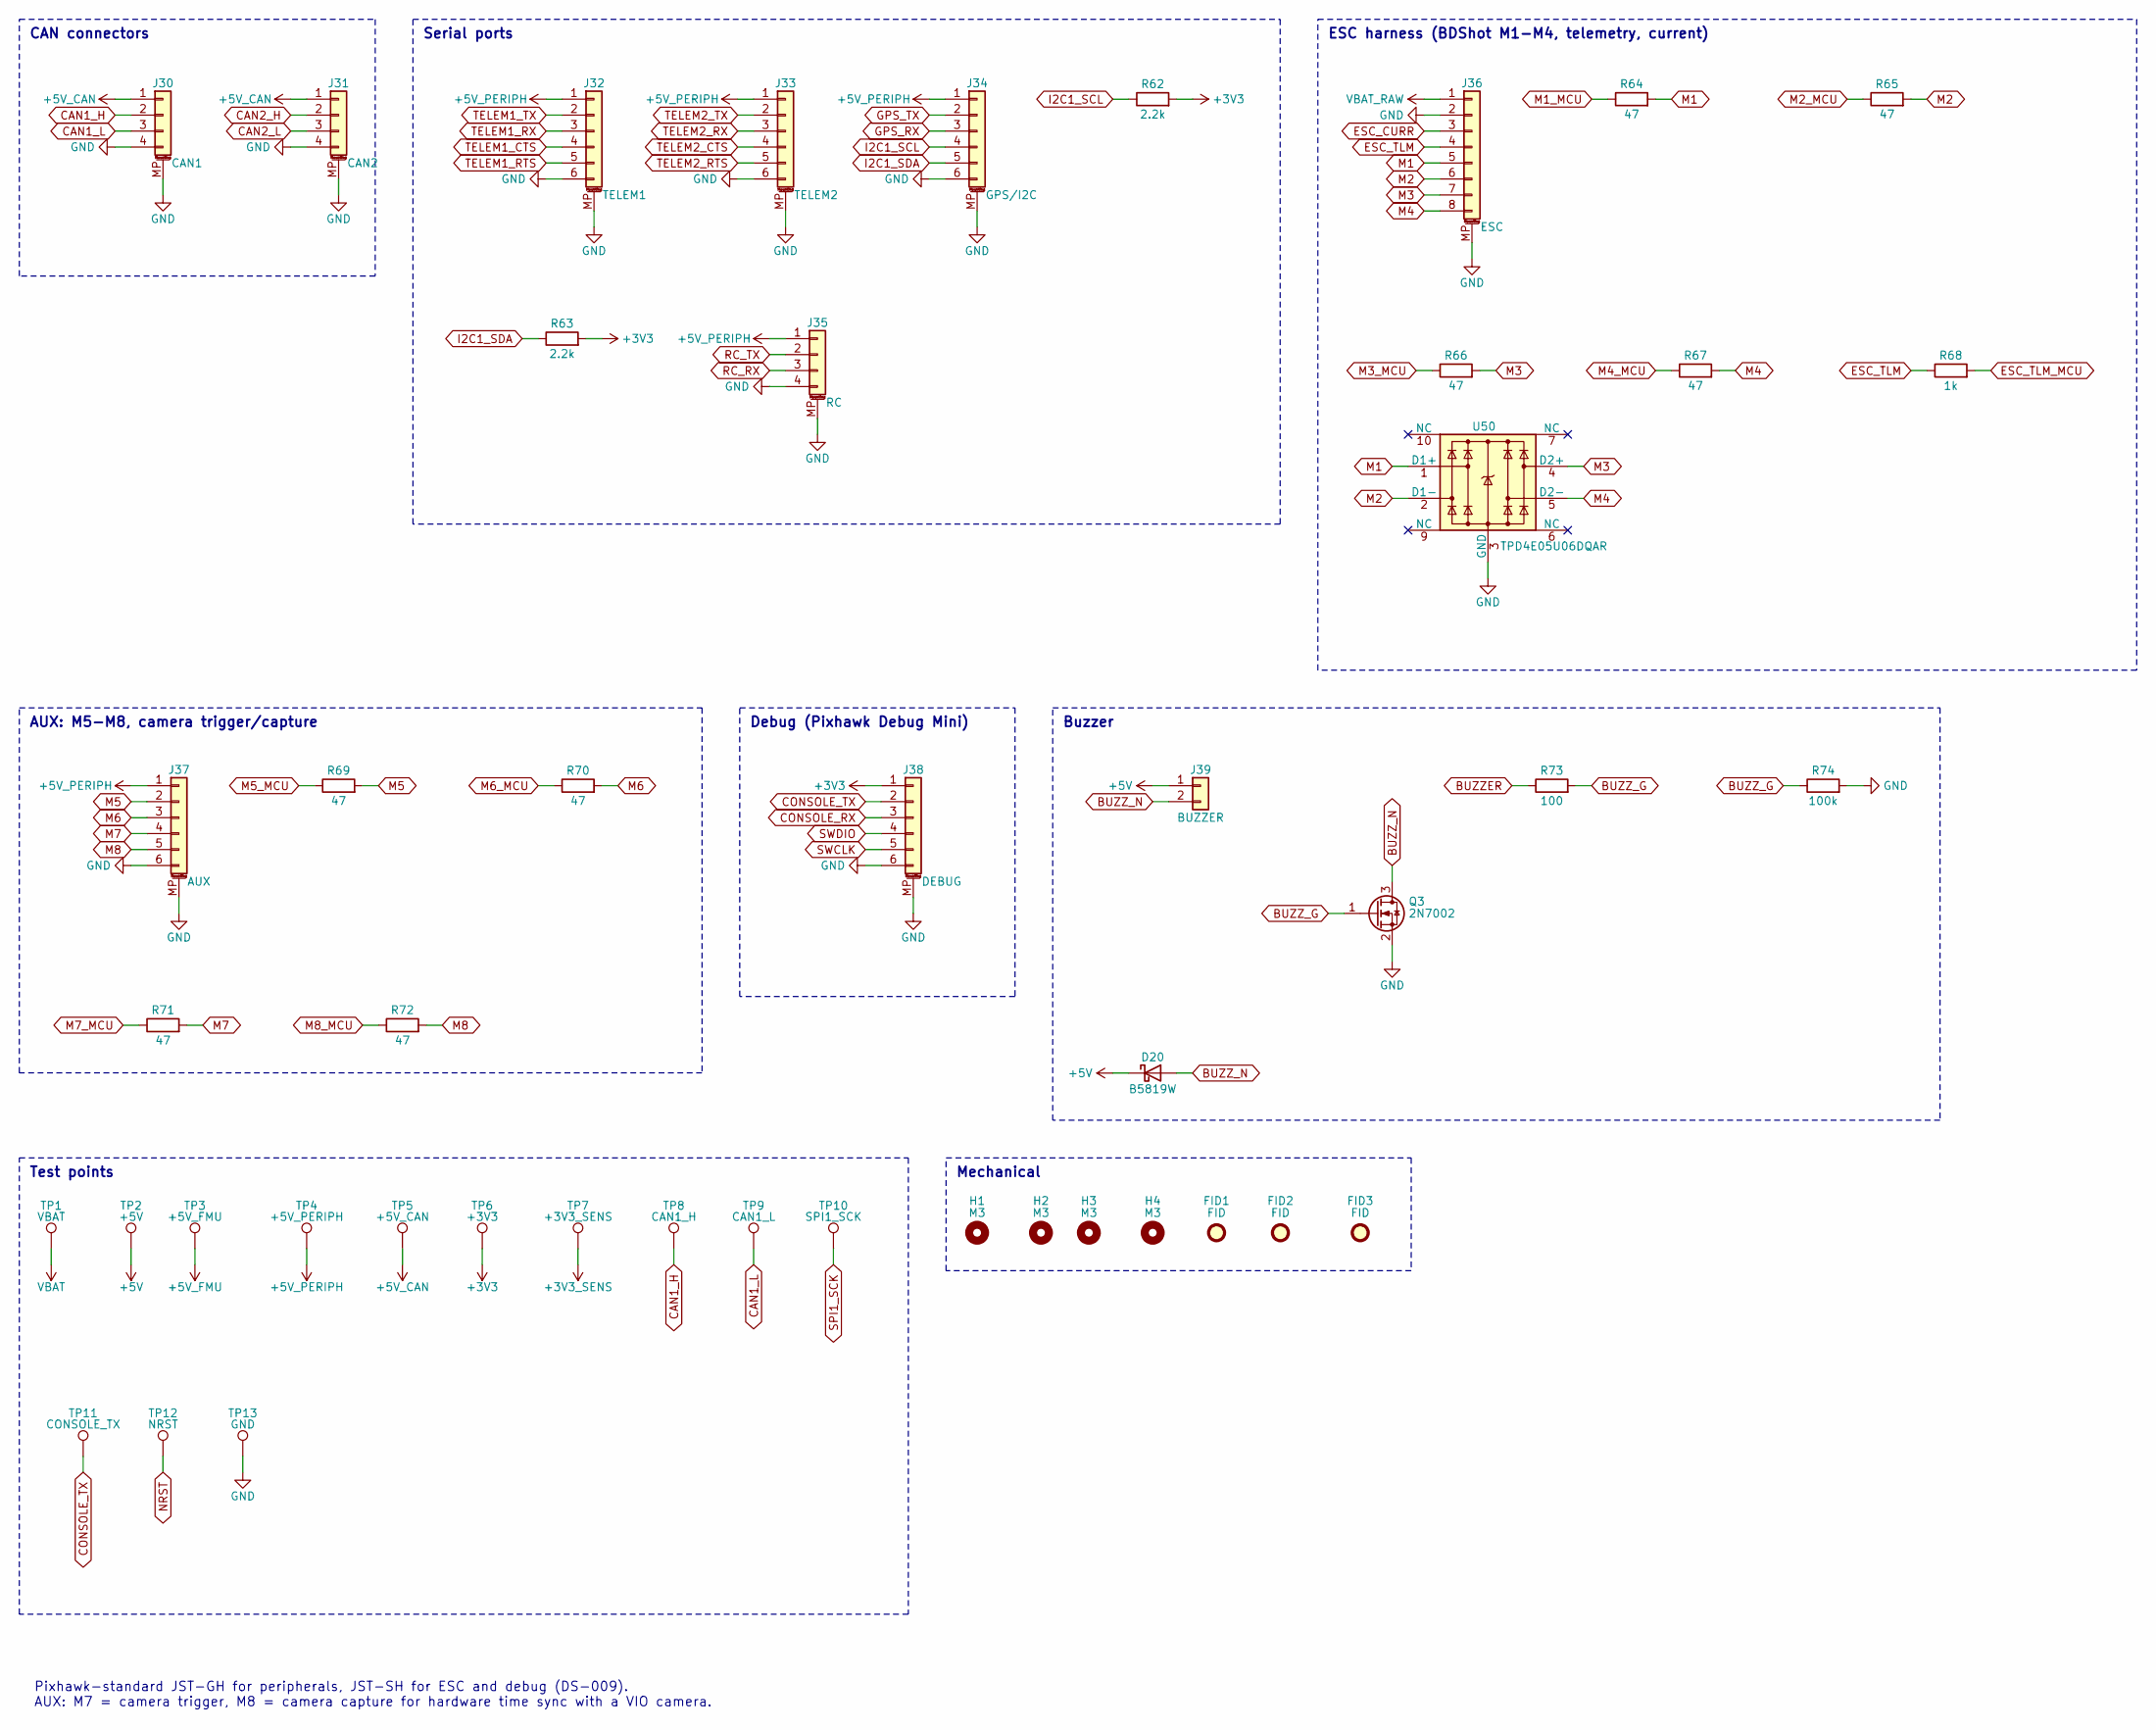
[picture p37: schematic connectors.kicad_sch, GPS-denied quadrotor flight controller: Connectors]

Parts:
D20: B5819W; D_SOD-123; LCSC C8598
FID1, FID2, FID3: FID; Fiducial_1mm_Mask2mm
H1, H2, H3, H4: M3; MountingHole_4.0mm_Grommet
J30: CAN1; JST_GH_SM04B-GHS-TB_1x04-1MP_P1.25mm_Horizontal; LCSC C189895
J31: CAN2; JST_GH_SM04B-GHS-TB_1x04-1MP_P1.25mm_Horizontal; LCSC C189895
J32: TELEM1; JST_GH_SM06B-GHS-TB_1x06-1MP_P1.25mm_Horizontal; LCSC C133065
J33: TELEM2; JST_GH_SM06B-GHS-TB_1x06-1MP_P1.25mm_Horizontal; LCSC C133065
J34: GPS/I2C; JST_GH_SM06B-GHS-TB_1x06-1MP_P1.25mm_Horizontal; LCSC C133065
J35: RC; JST_GH_SM04B-GHS-TB_1x04-1MP_P1.25mm_Horizontal; LCSC C189895
J36: ESC; JST_SH_SM08B-SRSS-TB_1x08-1MP_P1.00mm_Horizontal; LCSC C160407
J37: AUX; JST_SH_SM06B-SRSS-TB_1x06-1MP_P1.00mm_Horizontal; LCSC C56123098
J38: DEBUG; JST_SH_SM06B-SRSS-TB_1x06-1MP_P1.00mm_Horizontal; LCSC C56123098
J39: BUZZER; Pads_2x_1.5x2mm
Q3: 2N7002; SOT-23; LCSC C8545
R62, R63: 2.2k; R_0402_1005Metric; LCSC C25879
R64, R65, R66, R67, R69, R70, R71, R72: 47; R_0402_1005Metric; LCSC C25118
R68: 1k; R_0402_1005Metric; LCSC C11702
R73: 100; R_0402_1005Metric; LCSC C25076
R74: 100k; R_0402_1005Metric; LCSC C25741
TP1: VBAT; TestPoint_Pad_D1.0mm
TP2: +5V; TestPoint_Pad_D1.0mm
TP3: +5V_FMU; TestPoint_Pad_D1.0mm
TP4: +5V_PERIPH; TestPoint_Pad_D1.0mm
TP5: +5V_CAN; TestPoint_Pad_D1.0mm
TP6: +3V3; TestPoint_Pad_D1.0mm
TP7: +3V3_SENS; TestPoint_Pad_D1.0mm
TP8: CAN1_H; TestPoint_Pad_D1.0mm
TP9: CAN1_L; TestPoint_Pad_D1.0mm
TP10: SPI1_SCK; TestPoint_Pad_D1.0mm
TP11: CONSOLE_TX; TestPoint_Pad_D1.0mm
TP12: NRST; TestPoint_Pad_D1.0mm
TP13: GND; TestPoint_Pad_D1.0mm
U50: TPD4E05U06DQAR; USON-10_2.5x1.0mm_P0.5mm; LCSC C138714

Connections:
+3V3: J38.1, R62.2, R63.2, TP6.1; also elsewhere on the board
+3V3_SENS: TP7.1; also elsewhere on the board
+5V: D20.1 (K), J39.1, TP2.1; also elsewhere on the board
+5V_CAN: J30.1, J31.1, TP5.1; also elsewhere on the board
+5V_FMU: TP3.1; also elsewhere on the board
+5V_PERIPH: J32.1, J33.1, J34.1, J35.1, J37.1, TP4.1; also elsewhere on the board
BUZZER: R73.1; also elsewhere on the board
BUZZ_G: Q3.1 (G), R73.2, R74.1
BUZZ_N: D20.2 (A), J39.2, Q3.3 (D)
CAN1_H: J30.2, TP8.1; also elsewhere on the board
CAN1_L: J30.3, TP9.1; also elsewhere on the board
CAN2_H: J31.2; also elsewhere on the board
CAN2_L: J31.3; also elsewhere on the board
CONSOLE_RX: J38.3; also elsewhere on the board
CONSOLE_TX: J38.2, TP11.1; also elsewhere on the board
ESC_CURR: J36.3; also elsewhere on the board
ESC_TLM: J36.4, R68.1
ESC_TLM_MCU: R68.2; also elsewhere on the board
GND: J30.4, J30.MP (MountPin), J31.4, J31.MP (MountPin), J32.6, J32.MP (MountPin), J33.6, J33.MP (MountPin), J34.6, J34.MP (MountPin), J35.4, J35.MP (MountPin), J36.2, J36.MP (MountPin), J37.6, J37.MP (MountPin), J38.6, J38.MP (MountPin), Q3.2 (S), R74.2, TP13.1, U50.3 (GND), U50.8 (GND); also elsewhere on the board
GPS_RX: J34.3; also elsewhere on the board
GPS_TX: J34.2; also elsewhere on the board
I2C1_SCL: J34.4, R62.1; also elsewhere on the board
I2C1_SDA: J34.5, R63.1; also elsewhere on the board
M1: J36.5, R64.2, U50.1 (D1+)
M1_MCU: R64.1; also elsewhere on the board
M2: J36.6, R65.2, U50.2 (D1-)
M2_MCU: R65.1; also elsewhere on the board
M3: J36.7, R66.2, U50.4 (D2+)
M3_MCU: R66.1; also elsewhere on the board
M4: J36.8, R67.2, U50.5 (D2-)
M4_MCU: R67.1; also elsewhere on the board
M5: J37.2, R69.2
M5_MCU: R69.1; also elsewhere on the board
M6: J37.3, R70.2
M6_MCU: R70.1; also elsewhere on the board
M7: J37.4, R71.2
M7_MCU: R71.1; also elsewhere on the board
M8: J37.5, R72.2
M8_MCU: R72.1; also elsewhere on the board
NRST: TP12.1; also elsewhere on the board
RC_RX: J35.3; also elsewhere on the board
RC_TX: J35.2; also elsewhere on the board
SPI1_SCK: TP10.1; also elsewhere on the board
SWCLK: J38.5; also elsewhere on the board
SWDIO: J38.4; also elsewhere on the board
TELEM1_CTS: J32.4; also elsewhere on the board
TELEM1_RTS: J32.5; also elsewhere on the board
TELEM1_RX: J32.3; also elsewhere on the board
TELEM1_TX: J32.2; also elsewhere on the board
TELEM2_CTS: J33.4; also elsewhere on the board
TELEM2_RTS: J33.5; also elsewhere on the board
TELEM2_RX: J33.3; also elsewhere on the board
TELEM2_TX: J33.2; also elsewhere on the board
VBAT: TP1.1; also elsewhere on the board
VBAT_RAW: J36.1; also elsewhere on the board

Notes on the sheet:
CAN connectors
Serial ports
ESC harness (BDShot M1-M4, telemetry, current)
AUX: M5-M8, camera trigger/capture
Debug (Pixhawk Debug Mini)
Buzzer
Test points
Mechanical
Pixhawk-standard JST-GH for peripherals, JST-SH for ESC and debug (DS-009). AUX: M7 = camera trigger, M8 = camera capture for hardware time sync with a VIO camera.

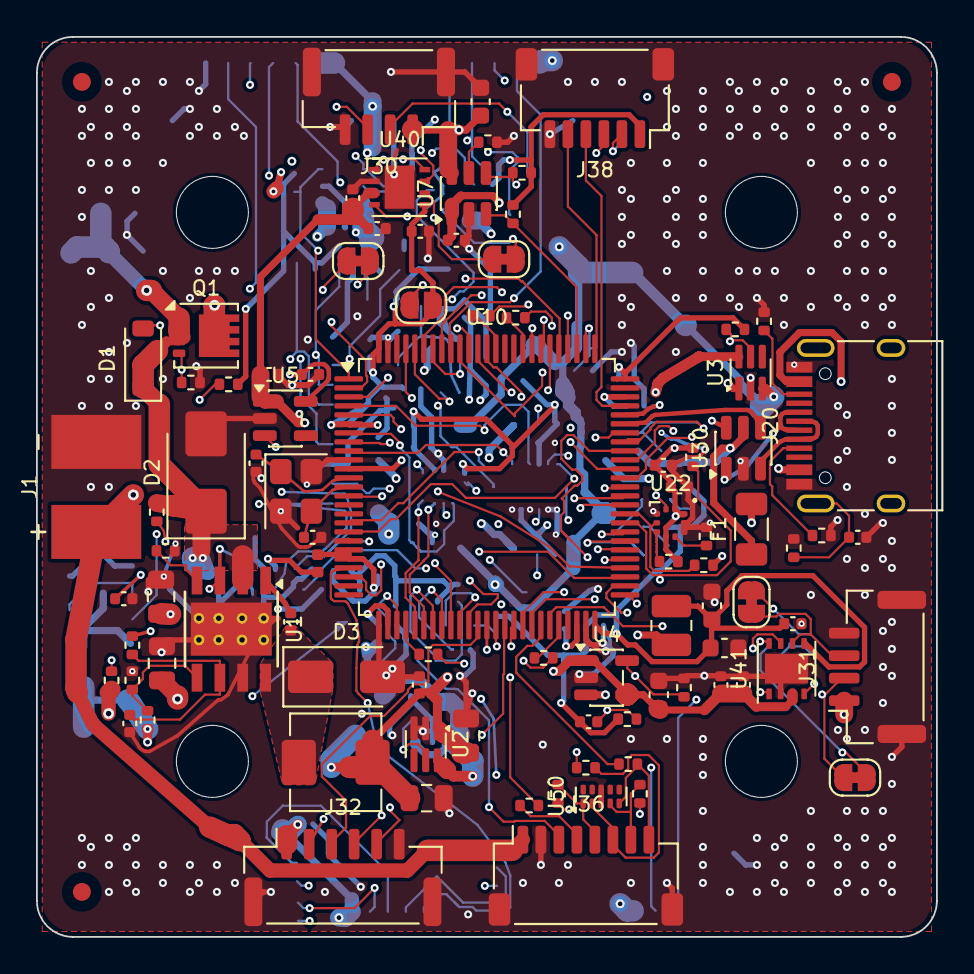
[picture p38: board fc.kicad_pcb from above]

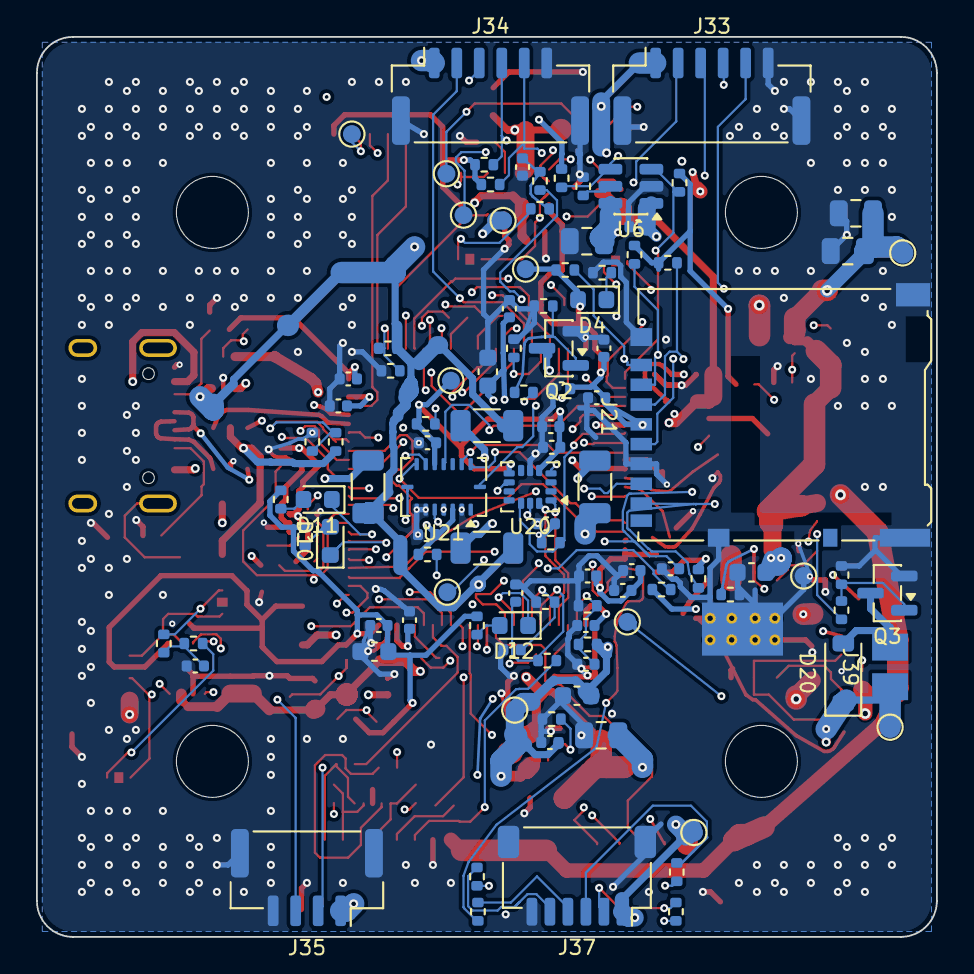
[picture p39: board fc.kicad_pcb from below]

Board: 6 copper layers, 50.0 x 50.0 mm, 203 parts (106 on the bottom side), 142 nets.
