dvntekim/fc-h743/firmware/boards/dvntekim/fch743/src/init.c

/****************************************************************************
 *
 *   Copyright (c) 2012-2022 PX4 Development Team. All rights reserved.
 *
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
 * 1. Redistributions of source code must retain the above copyright
 *    notice, this list of conditions and the following disclaimer.
 * 2. Redistributions in binary form must reproduce the above copyright
 *    notice, this list of conditions and the following disclaimer in
 *    the documentation and/or other materials provided with the
 *    distribution.
 * 3. Neither the name PX4 nor the names of its contributors may be
 *    used to endorse or promote products derived from this software
 *    without specific prior written permission.
 *
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
 ****************************************************************************/

/**
 * @file init.c
 *
 * PX4FMU-specific early startup code.  This file implements the
 * board_app_initialize() function that is called early by nsh during startup.
 *
 * Code here is run before the rcS script is invoked; it should start required
 * subsystems and perform board-specific initialization.
 */

/****************************************************************************
 * Included Files
 ****************************************************************************/

#include "board_config.h"

#include <stdbool.h>
#include <stdio.h>
#include <string.h>
#include <debug.h>
#include <errno.h>
#include <syslog.h>

#include <nuttx/config.h>
#include <nuttx/board.h>
#include <nuttx/spi/spi.h>
#include <nuttx/sdio.h>
#include <nuttx/mmcsd.h>
#include <nuttx/analog/adc.h>
#include <nuttx/mm/gran.h>
#include <chip.h>
#include <stm32_uart.h>
#include <arch/board/board.h>
#include "arm_internal.h"

#include <drivers/drv_hrt.h>
#include <drivers/drv_board_led.h>
#include <systemlib/px4_macros.h>
#include <px4_arch/io_timer.h>
#include <px4_platform_common/init.h>
#include <px4_platform/gpio.h>
#include <px4_platform/board_dma_alloc.h>

/****************************************************************************
 * Pre-Processor Definitions
 ****************************************************************************/

/* Configuration ************************************************************/

/*
 * Ideally we'd be able to get these from arm_internal.h,
 * but since we want to be able to disable the NuttX use
 * of leds for system indication at will and there is no
 * separate switch, we need to build independent of the
 * CONFIG_ARCH_LEDS configuration switch.
 */
__BEGIN_DECLS
extern void led_init(void);
extern void led_on(int led);
extern void led_off(int led);
__END_DECLS


/************************************************************************************
 * Name: board_peripheral_reset
 *
 * Description:
 *
 ************************************************************************************/
__EXPORT void board_peripheral_reset(int ms)
{
	/* set the peripheral rails off */

	VDD_5V_PERIPH_EN(false);
	board_imu_clkin_stop();
	board_control_spi_sensors_power(false, 0xffff);

	/* wait for the peripheral rail to reach GND */
	usleep(ms * 1000);
	syslog(LOG_DEBUG, "reset done, %d ms\n", ms);

	/* re-enable power */

	/* switch the peripheral rail back on */
	board_control_spi_sensors_power(true, 0xffff);
	board_imu_clkin_start();
	VDD_5V_PERIPH_EN(true);

}

/************************************************************************************
 * Name: board_on_reset
 *
 * Description:
 * Optionally provided function called on entry to board_system_reset
 * It should perform any house keeping prior to the rest.
 *
 * status - 1 if resetting to boot loader
 *          0 if just resetting
 *
 ************************************************************************************/
/************************************************************************************
 * fch743: 32.000 kHz on TIM2_CH3 (PB10) into the ICM-45686 CLKIN pin.
 * TIM2 runs from 2 x PCLK1 = 240 MHz: 240 MHz / 7500 = 32.000 kHz exactly, 50 % duty.
 * PX4's icm45686 driver is started with -C 32000 so FIFO timestamps use this clock.
 ************************************************************************************/
#define FCH_TIM2_BASE      0x40000000u
#define FCH_RCC_APB1LENR   0x580244E8u
#define FCH_REG(o)         (*(volatile uint32_t *)(FCH_TIM2_BASE + (o)))

__EXPORT void board_imu_clkin_start(void)
{
	const uint32_t arr = (STM32_APB1_TIM2_CLKIN / BOARD_IMU_CLKIN_HZ) - 1;
	*(volatile uint32_t *)FCH_RCC_APB1LENR |= (1u << 0);   /* TIM2EN */
	FCH_REG(0x00) = 0;                 /* CR1: stop */
	FCH_REG(0x28) = 0;                 /* PSC */
	FCH_REG(0x2C) = arr;               /* ARR */
	FCH_REG(0x3C) = (arr + 1) / 2;     /* CCR3: 50 % */
	FCH_REG(0x1C) = (6u << 4) | (1u << 3); /* CCMR2: OC3M = PWM1, OC3PE */
	FCH_REG(0x20) = (1u << 8);         /* CCER: CC3E */
	FCH_REG(0x14) = 1;                 /* EGR: UG */
	FCH_REG(0x00) = (1u << 7) | 1u;    /* CR1: ARPE | CEN */
	px4_arch_configgpio(GPIO_IMU_CLKIN);
}

/* Stop the IMU clock and park PB10 before +3V3_SENS is switched off. */
__EXPORT void board_imu_clkin_stop(void)
{
	px4_arch_configgpio(GPIO_IMU_CLKIN_OFF);
	FCH_REG(0x00) = 0;                 /* CR1: stop */
}

__EXPORT void board_on_reset(int status)
{
	for (int i = 0; i < DIRECT_PWM_OUTPUT_CHANNELS; ++i) {
		px4_arch_configgpio(io_timer_channel_get_gpio_output(i));
	}

	/*
	 * On resets invoked from system (not boot) ensure we establish a low
	 * output state on PWM pins to disarm the ESC and prevent the reset from potentially
	 * spinning up the motors.
	 */
	if (status >= 0) {
		up_mdelay(100);
	}
}

/************************************************************************************
 * Name: stm32_boardinitialize
 *
 * Description:
 *   All STM32 architectures must provide the following entry point.  This entry point
 *   is called early in the initialization -- after all memory has been configured
 *   and mapped but before any devices have been initialized.
 *
 ************************************************************************************/

__EXPORT void
stm32_boardinitialize(void)
{
	board_on_reset(-1); /* Reset PWM first thing */

	/* configure LEDs */

	board_autoled_initialize();

	/* configure pins */

	const uint32_t gpio[] = PX4_GPIO_INIT_LIST;
	px4_gpio_init(gpio, arraySize(gpio));

	/* configure USB interfaces */

	stm32_usbinitialize();
}

/****************************************************************************
 * Name: board_app_initialize
 *
 * Description:
 *   Perform application specific initialization.  This function is never
 *   called directly from application code, but only indirectly via the
 *   (non-standard) boardctl() interface using the command BOARDIOC_INIT.
 *
 * Input Parameters:
 *   arg - The boardctl() argument is passed to the board_app_initialize()
 *         implementation without modification.  The argument has no
 *         meaning to NuttX; the meaning of the argument is a contract
 *         between the board-specific initalization logic and the the
 *         matching application logic.  The value cold be such things as a
 *         mode enumeration value, a set of DIP switch switch settings, a
 *         pointer to configuration data read from a file or serial FLASH,
 *         or whatever you would like to do with it.  Every implementation
 *         should accept zero/NULL as a default configuration.
 *
 * Returned Value:
 *   Zero (OK) is returned on success; a negated errno value is returned on
 *   any failure to indicate the nature of the failure.
 *
 ****************************************************************************/

__EXPORT int board_app_initialize(uintptr_t arg)
{
#if !defined(BOOTLOADER)

	/* Power on Interfaces */
	VDD_5V_PERIPH_EN(true);
	VDD_5V_HIPOWER_EN(true);

	/* Need hrt running before using the ADC */

	px4_platform_init();


	stm32_spiinitialize();

	/* Power-cycle the sensor rail with the IMU clock parked, then start the
	 * 32 kHz reference once +3V3_SENS is up and before the IMU drivers probe. */
	board_imu_clkin_stop();
	board_spi_reset(10, 0xffff);
	board_imu_clkin_start();

	/* configure the DMA allocator */

	if (board_dma_alloc_init() < 0) {
		syslog(LOG_ERR, "[boot] DMA alloc FAILED\n");
	}

#  if defined(SERIAL_HAVE_RXDMA)
	// set up the serial DMA polling at 1ms intervals for received bytes that have not triggered a DMA event.
	static struct hrt_call serial_dma_call;
	hrt_call_every(&serial_dma_call, 1000, 1000, (hrt_callout)stm32_serial_dma_poll, NULL);
#  endif

	/* initial LED state */
	drv_led_start();
	led_off(LED_RED);
	led_off(LED_BLUE);

	if (board_hardfault_init(2, true) != 0) {
		led_on(LED_RED);
	}

#  ifdef CONFIG_MMCSD
	int ret = stm32_sdio_initialize();

	if (ret != OK) {
		led_on(LED_RED);
	}

#  endif /* CONFIG_MMCSD */

	/* Configure the HW based on the manifest */

	px4_platform_configure();
#endif
	return OK;
}
