dvntekim/fc-h743/(commit log)

2026-10-31 fc-h743 rev A: STM32H743 flight controller (draft until independent review)
    KiCad 9 project, 50x50 mm 6-layer (JLC06161H-3313D), adapted from Pixhawk FMUv6C.
    - ERC 0/0; DRC 0 errors, 0 unconnected, 0 parity (silk warnings only)
    - Pin map checked against ST pin data (74 pins)
    - BOM: 69/69 JLCPCB parts in stock (2026-10-31)
    - TPS54360B loop simulated in ngspice (PM >= 66 deg, GM >= 12.9 dB)
    - PX4 board port boots on Simantic with every sensor found on the
    netlist-derived buses (ICM-45686 SPI1, BMI088 SPI2, BMP581 I2C4, CAN1, SD)
    - Gerbers, drill, JLC BOM/CPL, STEP, renders, review checklist
    Not ordered. JLCPCB DFM and independent review still open (REVIEW.md).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
    [bom_jlc.csv, can.kicad_sch, connectors.kicad_sch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]
2026-11-06 rev-A-draft2: vendor-guide review, SI/PI/thermal solvers, CI
    - 5 V set point 4.98 -> 5.09 V (R8 53.6k): LM66100 OR margin and copper drop
    - buck return path: vias at D3 anode, C11, C12; power pads solid to the pour
    - 328 power-net segments widened to the clearance limit
    - firmware: IMU clock parked during sensor-rail power-cycle; SPI2 power pin
    - sim/si (atlc), sim/pi (IR drop), sim/thermal; crosstalk scan
    - CI: ERC, DRC+parity, pin map, KiBot fab package/iBOM/PDF/STEP, PX4 build, Simantic (token)
    - CHANGELOG, CONTRIBUTING, issue/PR templates, BUILD_LOG, design_review
    - BOM re-checked 2026-11-06: 69/69 in stock
    Still DRAFT until independent review. Not for ordering.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
    [bom_jlc.csv, can.kicad_sch, connectors.kicad_sch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]
2026-11-06 CI: install KiCad symbol and footprint libraries for ERC/DRC
    Claude-Session: https://claude.ai/code/session_01Php19j7tJaQokbprB7Bjus
2026-11-06 CI: install newlib and libstdc++ for the ARM toolchain
    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
2026-11-06 CI: seed KiCad's global library tables; skip the footprint package
    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
2026-11-06 CI: fetch only the footprint libraries the board uses
    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
2026-11-06 CI: write the footprint library table for the fetched libraries
    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
2026-11-06 CI: footprints from the 9.0 library branch
    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
2026-11-06 CI: gate ERC on design warnings; ignore only missing stock footprint libraries
    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
2026-11-06 CI: cache KiCad packages; time out a stalled PPA download
    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
2026-11-06 KiBot: ERC filter under the erc preflight
    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
2026-11-07 rev-A-draft3: JLCDFM findings; vias cleared from mounting holes
    JLCDFM flagged GND stitching vias 0.37 mm from the 4 mm mounting holes.
    21 stitching vias within 1 mm of a hole edge removed; DRC 0/0/0, no GND islands.
    All other JLCDFM flags checked against JLC's published limits and the board
    file (same-net via-in-pad, 0.6 mm USB-C slots, 0.15 mm via tier) and logged
    in docs/design_review.md. JLC quote settings added to REVIEW.md.
    Still DRAFT until independent review. Not for ordering.
    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
    [fc-B_Cu.gbl, fc-B_Mask.gbs, fc-B_Paste.gbp, fc-B_Silkscreen.gbo, fc-Edge_Cuts.gm1, fc-F_Cu.gtl, fc-F_Mask.gts, fc-F_Paste.gtp]
2026-11-07 Rev B thermal analysis: IMU hold requirement, island sweep, heater loop
    - requirement from the IMU datasheets: hold within +-1.5 C
    - island model: moat vs slot, in place vs moved off the MCU, 0.86 / 1.5 W
    - PX4 heater PI modelled as coded; robustness to lag, C and isolation
    - decision: move IMUs off the MCU onto a slotted island, 1.5 W heater, 55 C
    - README states what is simulated and what is unbuilt; external review log
    Analysis only; layout not started.
    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
